Ant0Kr/Circuit-design/Cхемы/battery_controller.jpg

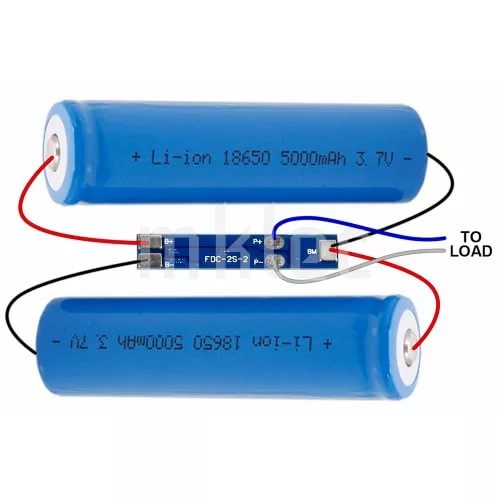
Cхемы/battery_controller.jpg
