Ant0Kr/Circuit-design/Инструкция/Логотип.png

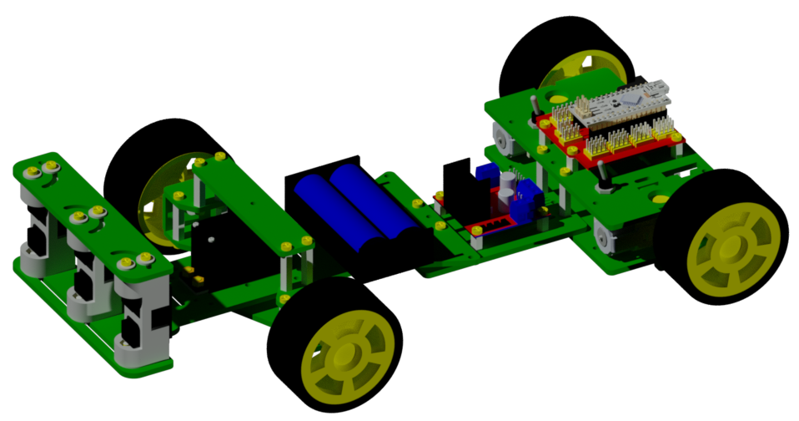
Инструкция/Логотип.png
