Ant0Kr/Circuit-design/Инструкция/Инструкция.docx

Робот для RoboRace

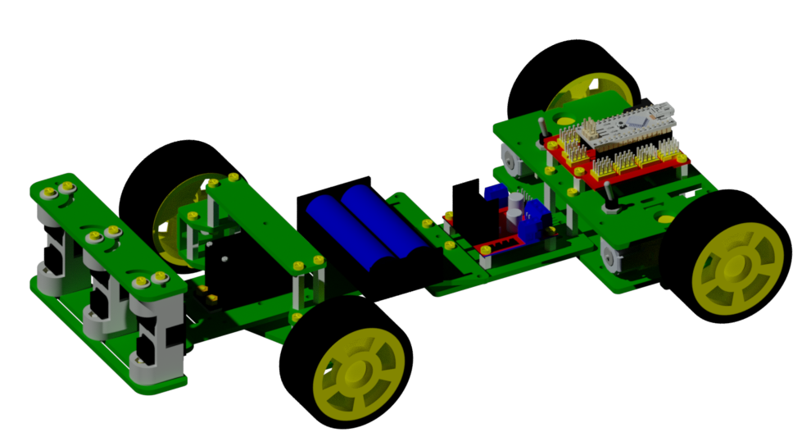
[picture p3: figure]

ИНСТРУКЦИЯ ПО СБОРКЕ

От авторов

Данная инструкция предлагает Вам собрать робота для участия в соревнованиях RoboRace по уже подготовленным чертежам и схемам. Однако авторы будут в восторге, если Вы используя их наработки спроектируете и соберете своего уникального робота.

Все чертежи, схемы и примеры прошивок можно найти в github репозитории: https://github.com/Ant0Kr/Circuit-design

(Все схемы и чертежи, приведенные в данной инструкции могут не соответствовать реальному виду использованных комплектующих робота. Все ссылки на комплектующие приведены в качестве примера.)

Удачи в творчестве.

С уважением, студенты БГУиР ФКСиС ВМСиС:

Карачун А. С.

Василевский И. А.

Содержание

Состав корпуса10

Инструкция по сборке12

Схема подключения электроники4

Описание API робота4

Необходимые комплектующие

Изображение | Описание | Количество

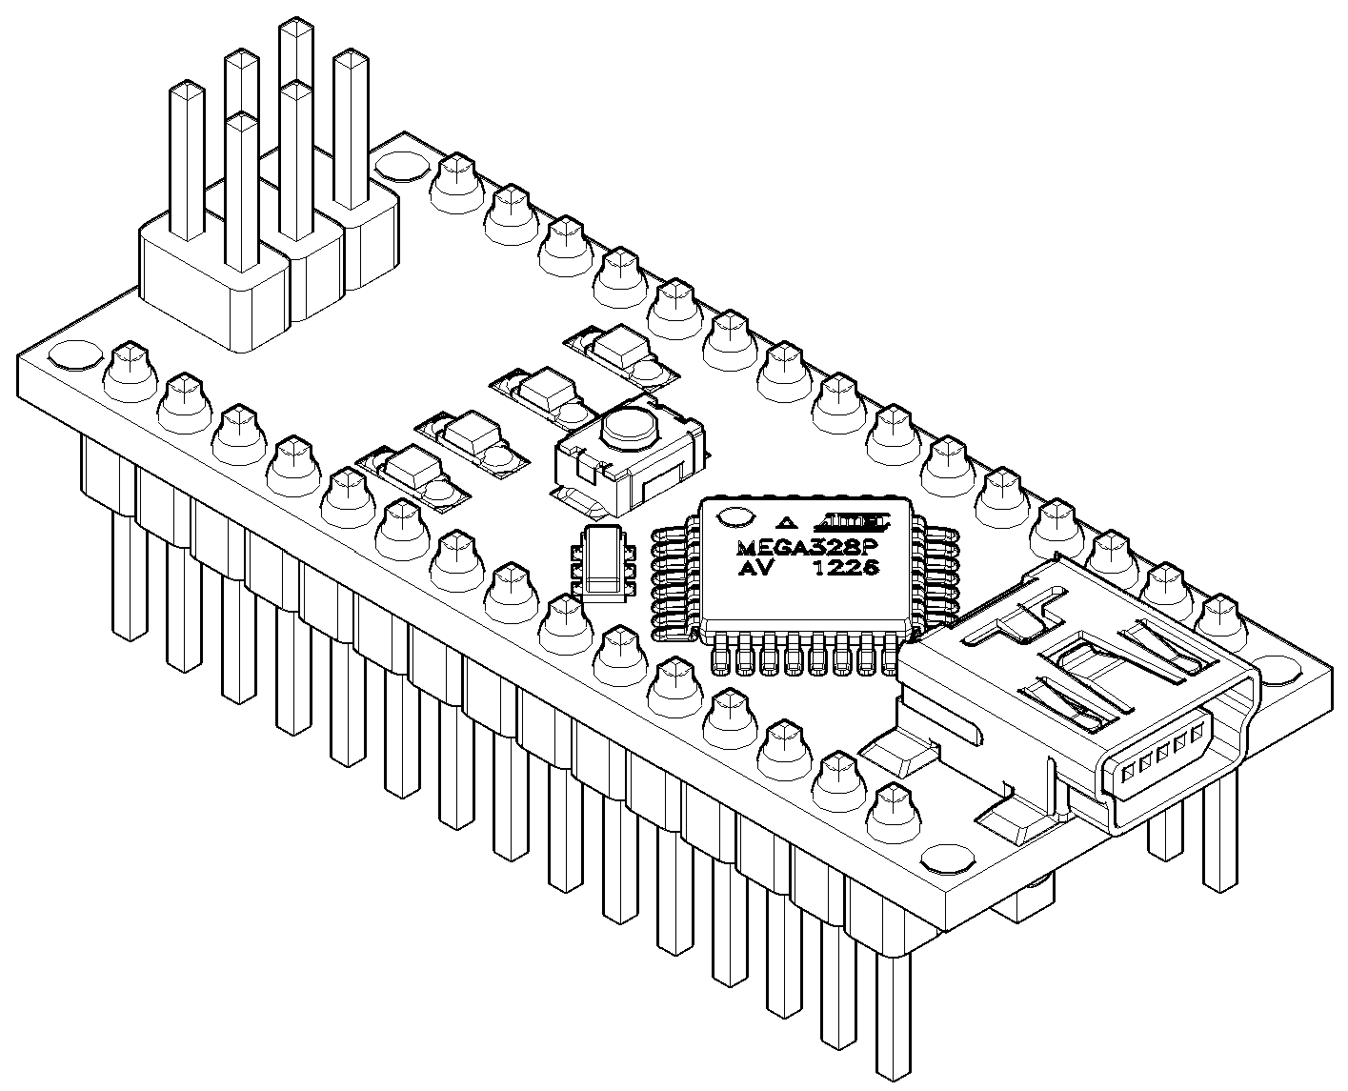
[picture p4: figure]

| Ардуино (Arduino Nano V3.0 (https://www.ebay.com/itm/ATmega328P-Mini-USB-Nano-V3-0-CH340G-5V-16M-Micro-controller-Board-For-Arduino-/172425955537)) | 1 шт.

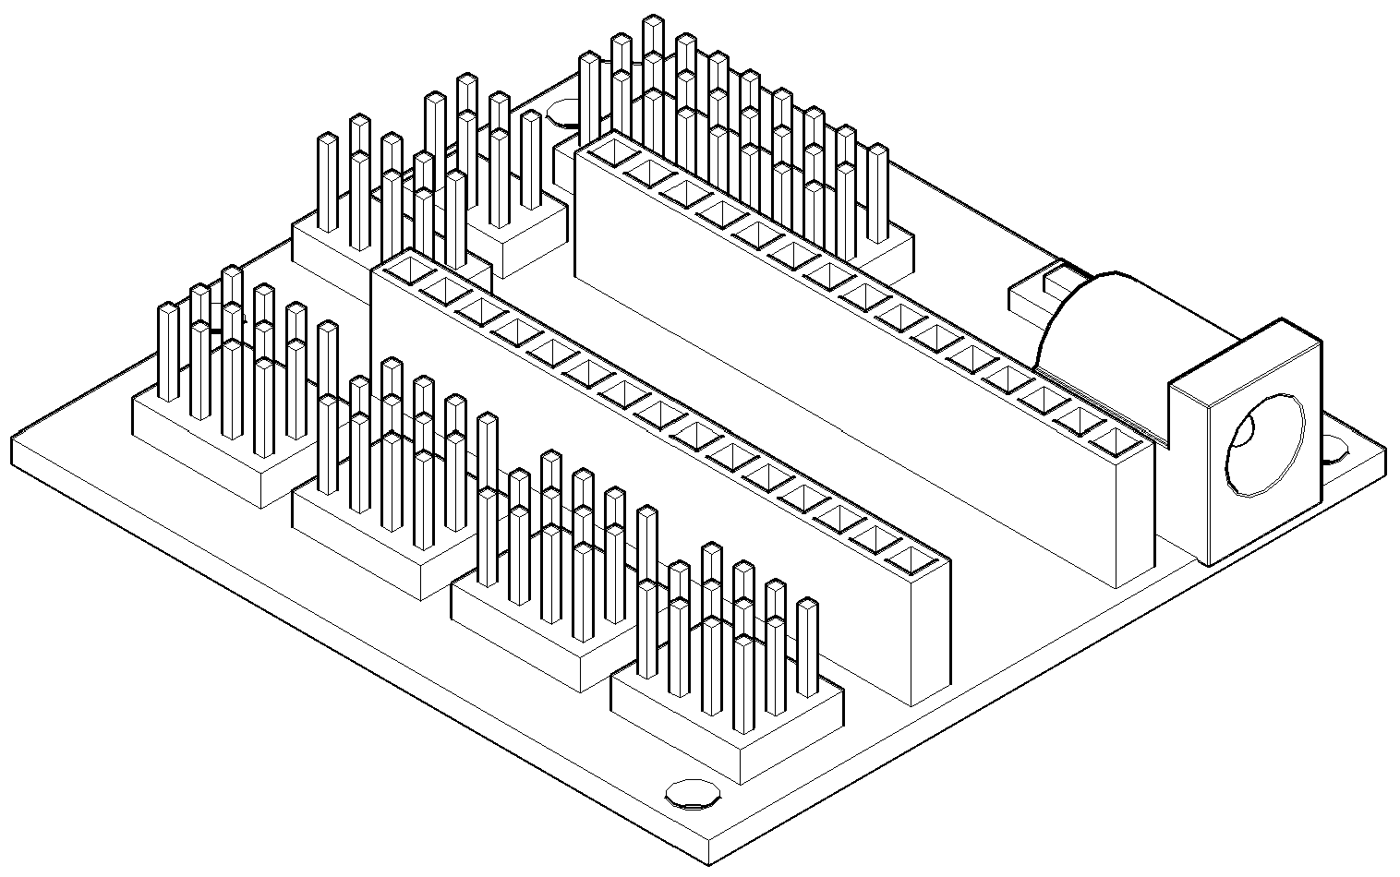
[picture p5: figure]

| Плата расширения (Nano V3.0 Prototype Shield I/O I2C Extension Board (https://www.ebay.com/itm/Nano-V3-0-Prototype-Shield-I-O-I2C-Extension-Board-Expansion-Module-F-Arduino-MO-/152340733476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)) | 1 шт.

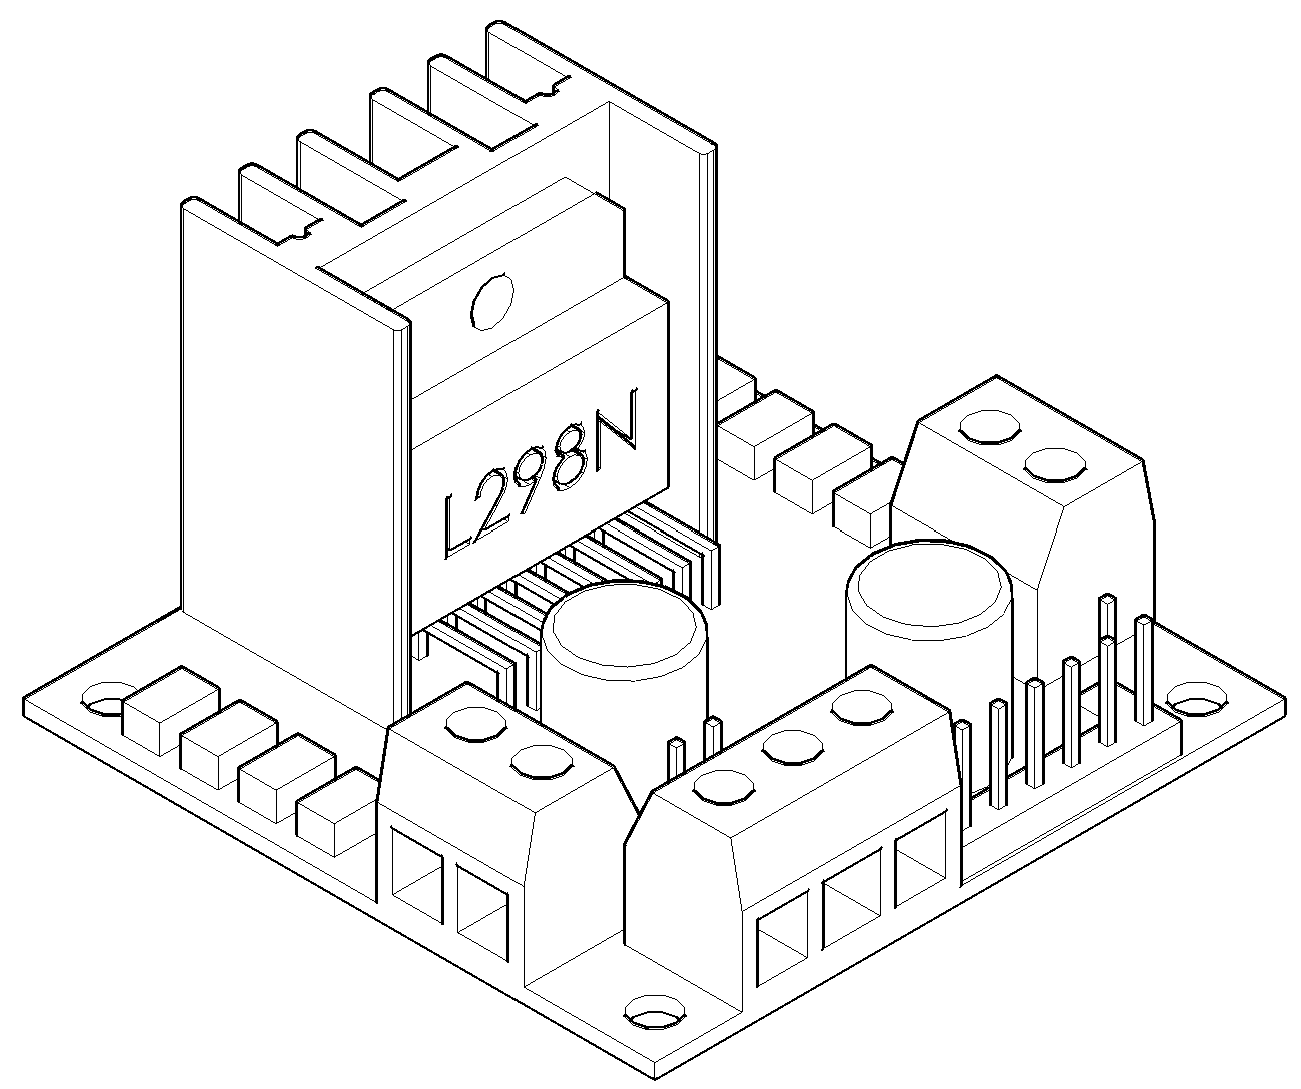
[picture p6: figure]

| Контроллер двигателей (L298N Driver Stepper Control (https://www.ebay.com/itm/DC-Module-Board-for-Arduino-HOT-Dual-H-Bridge-NEW-L298N-Driver-Stepper-Control-/112467282661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)) | 1 шт.

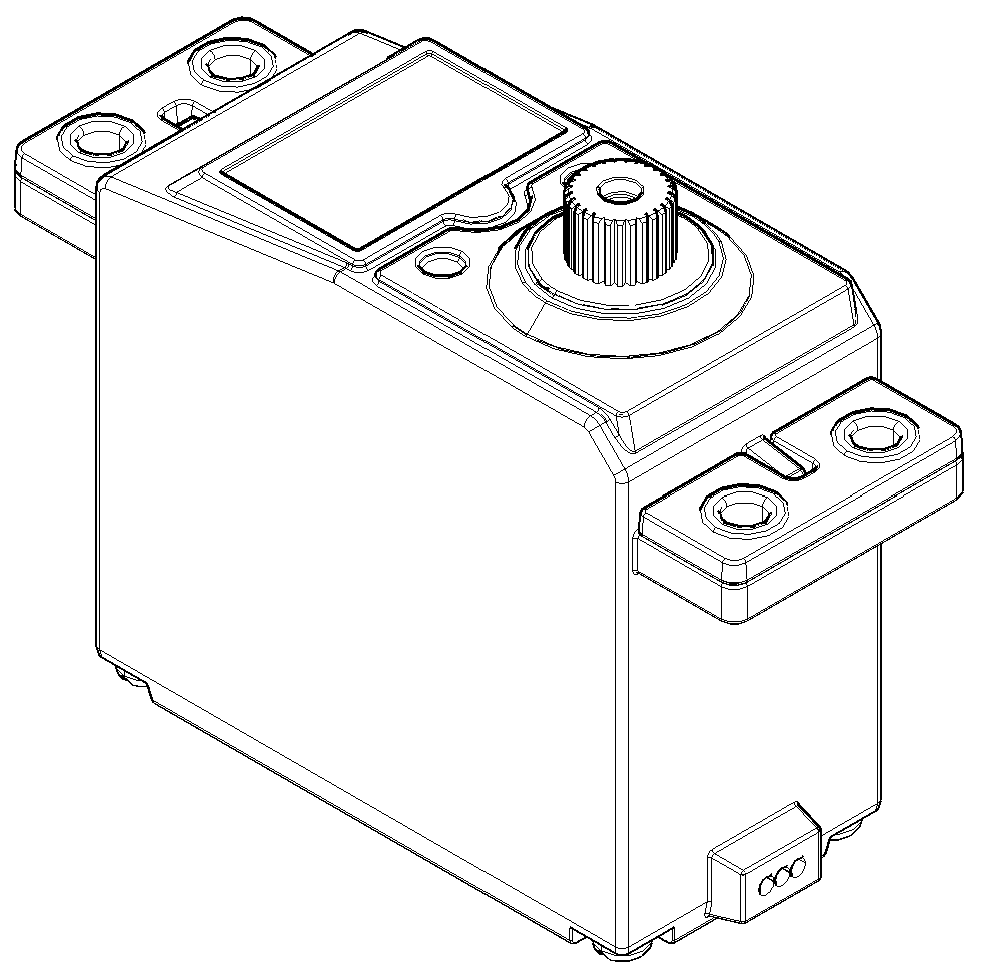
[picture p7: figure]

| Сервопривод (Futaba S3003 Servo Motor (http://www.ebay.com/itm/Big-Torque-Futaba-S3003-Servo-Motor-Gear-for-Robot-RC-Helicopter-Align-T-R-/201606199373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)) | 1 шт.

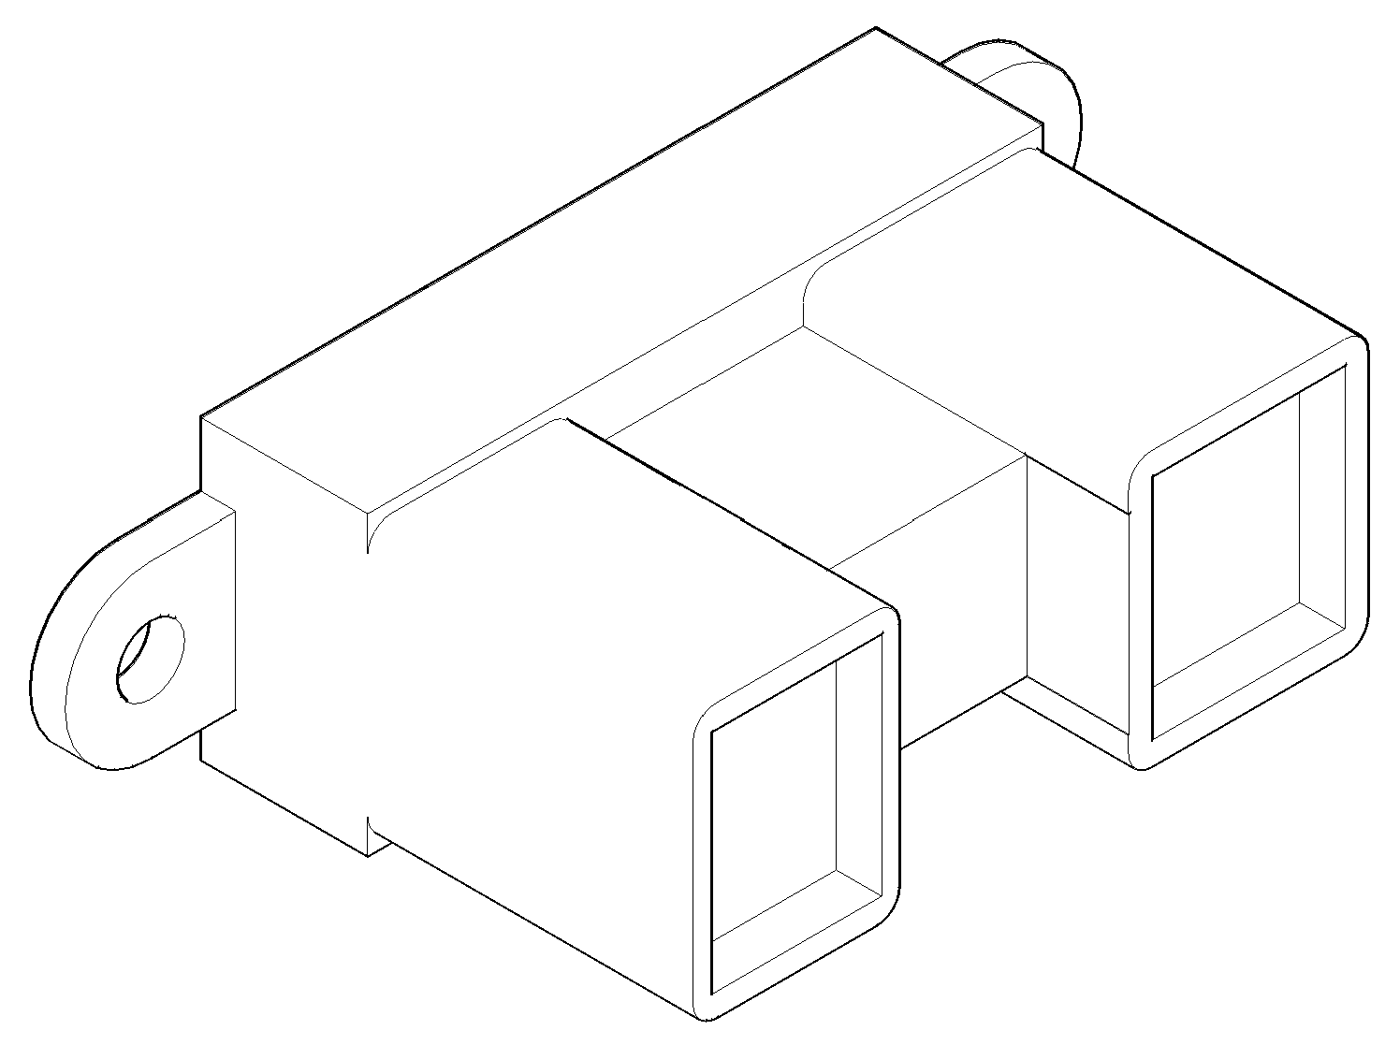
[picture p8: figure]

| Инфракрасный датчик расстояния (GP2Y0A21YK0F Sharp IR Analog Distance Sensor (http://www.ebay.com/itm/GP2Y0A21YK0F-Sharp-IR-Analog-Distance-Sensor-Distance-10CM-80CM-Cable-Arduino-D-/112073155701)) | 3 шт.

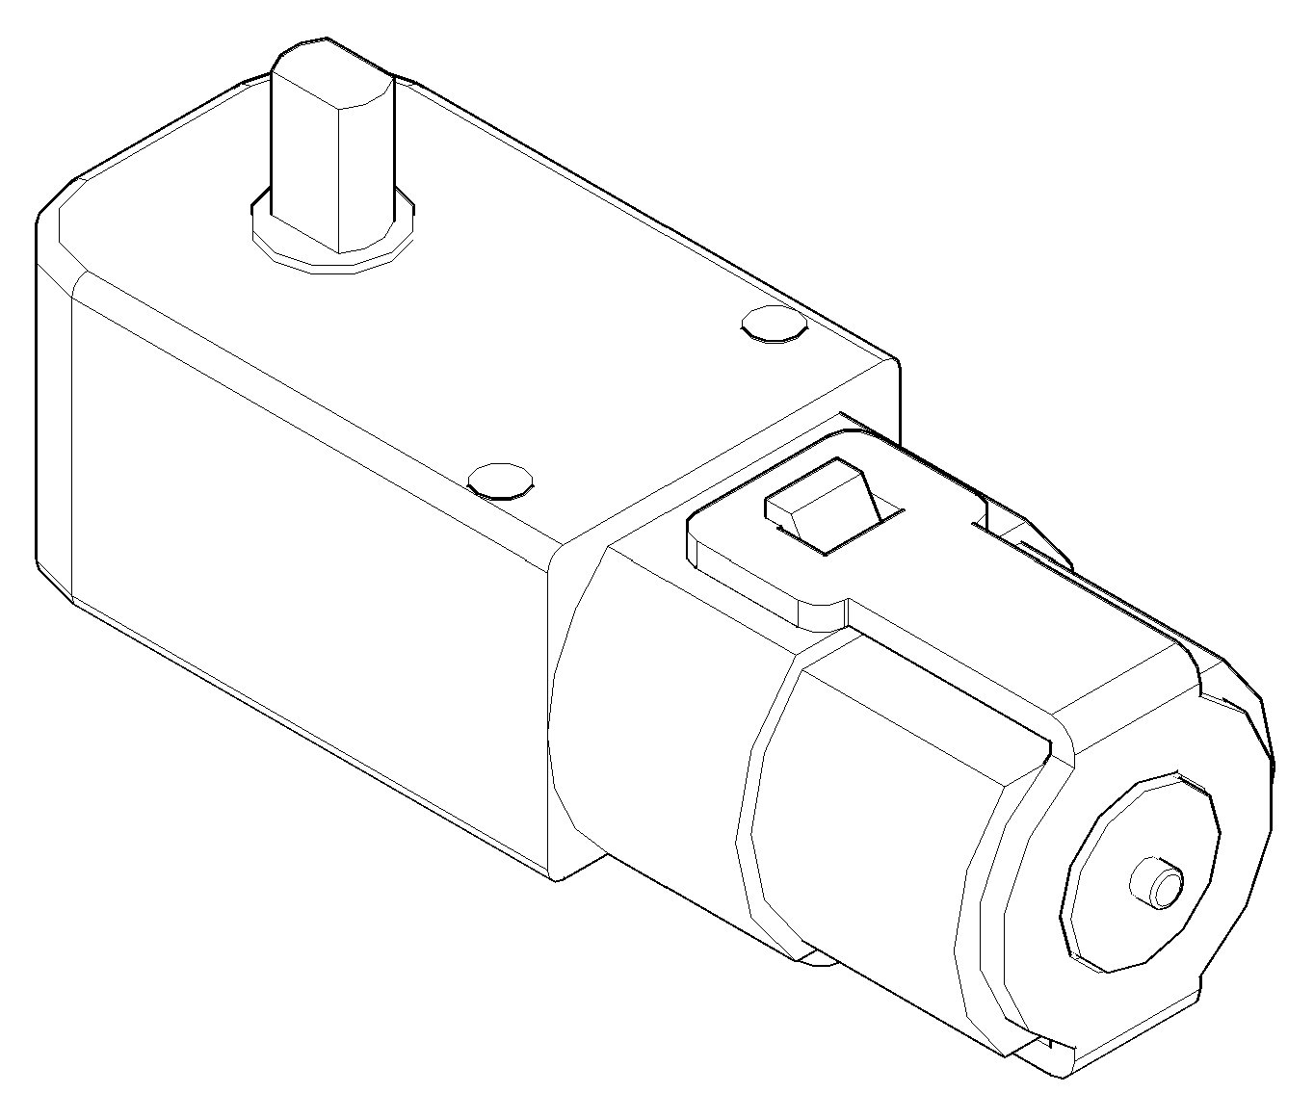
[picture p9: figure]

| Двигатель с редуктором (DC 3-6v Gear Motor (https://www.ebay.com/itm/DC3V-6V-DC-Geared-Motor-TT-For-Robot-Smart-Car-Chassis-DIY-Anti-interferenc-BBUS/311885629517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)) | 2 шт.

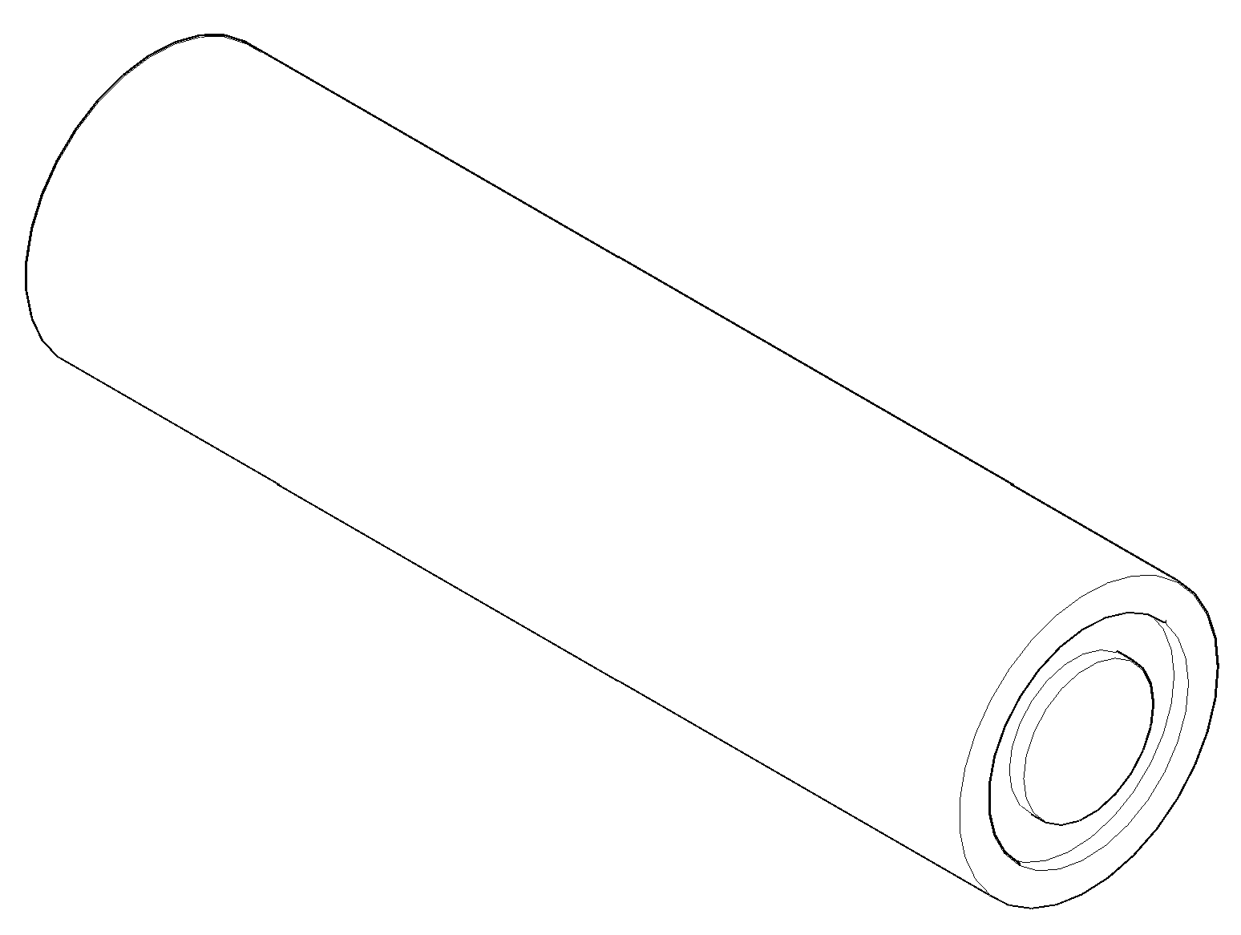
[picture p10: figure]

| Аккумулятор 18650 (Аккумулятор 18650 3.7V 1400mAh (http://belchip.by/product/?selected_product=19109)) | 2 шт.

Необходимые комплектующие

6

Изображение | Описание | Количество

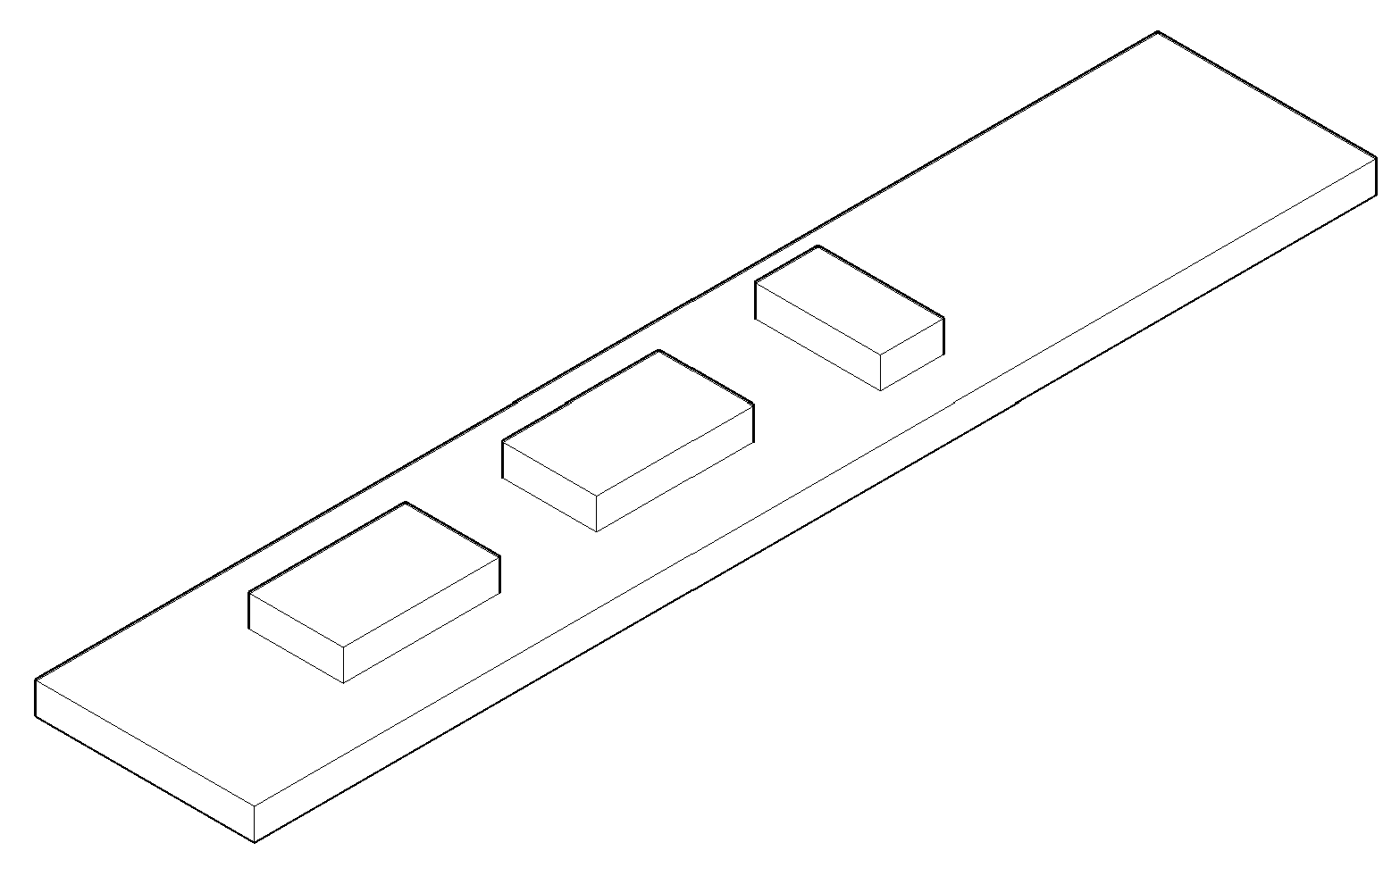
[picture p11: figure]

| Контроллер заряда/разряда аккумулятора (2S Li-ion Battery 18650 Charger Protection Board (https://www.ebay.com/itm/2S-Li-ion-Lithium-Battery-18650-Charger-Protection-Board-Pad-Module-3A-7-4V-8-4V-/131996865110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)) | 1 шт.

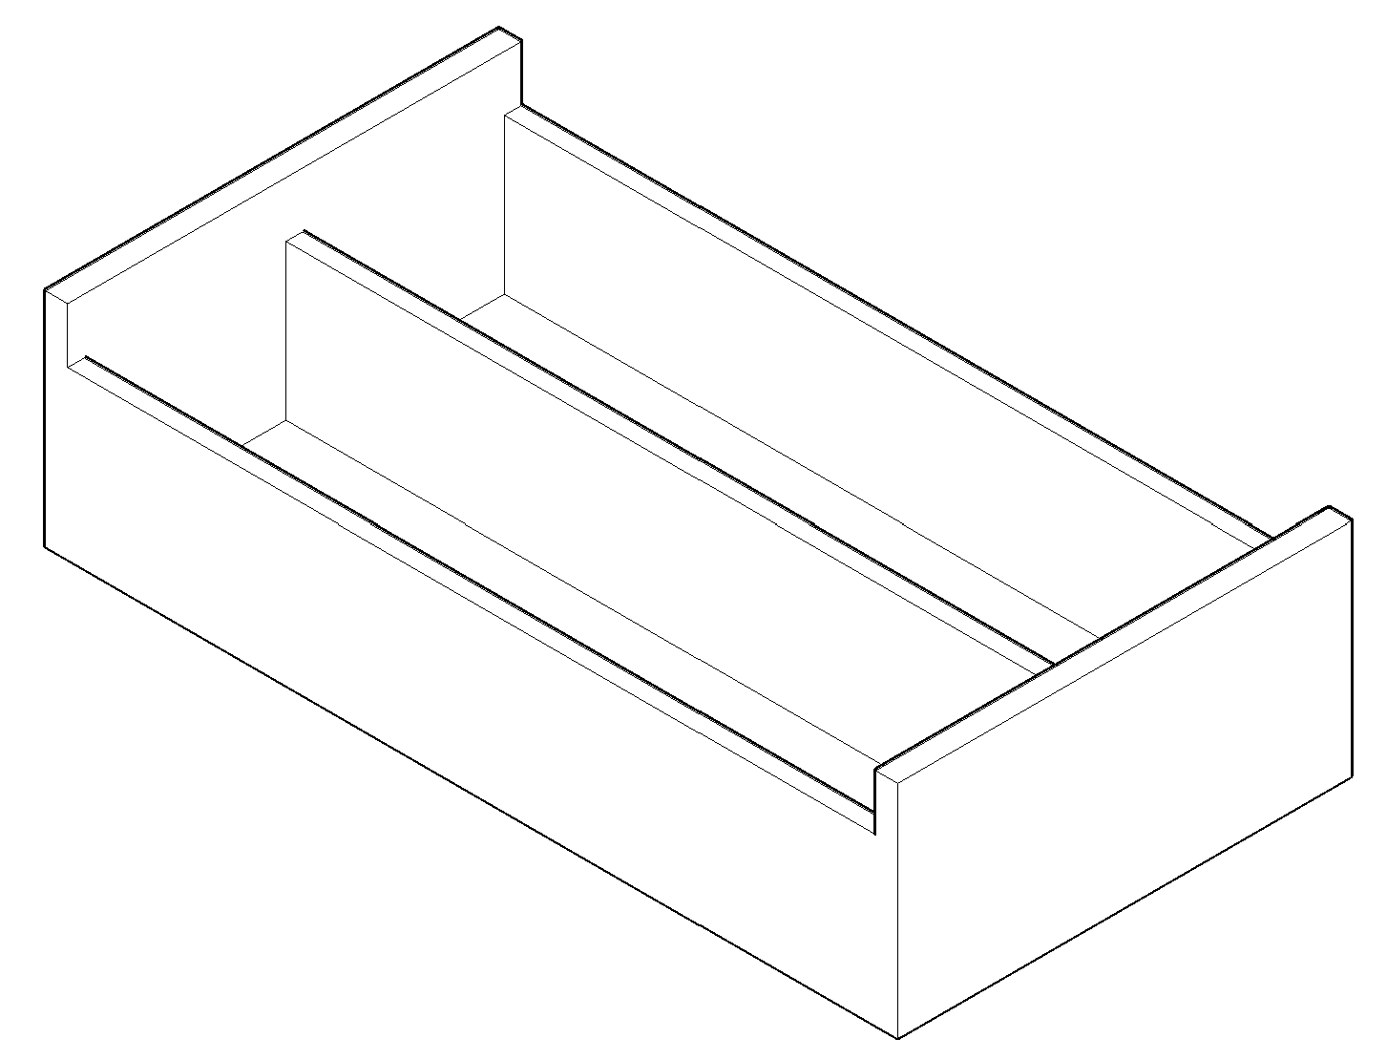
[picture p12: figure]

| Батарейный отсек (Батарейный отсек 18650 x2 (http://belchip.by/product/?selected_product=17455)) | 1 шт.

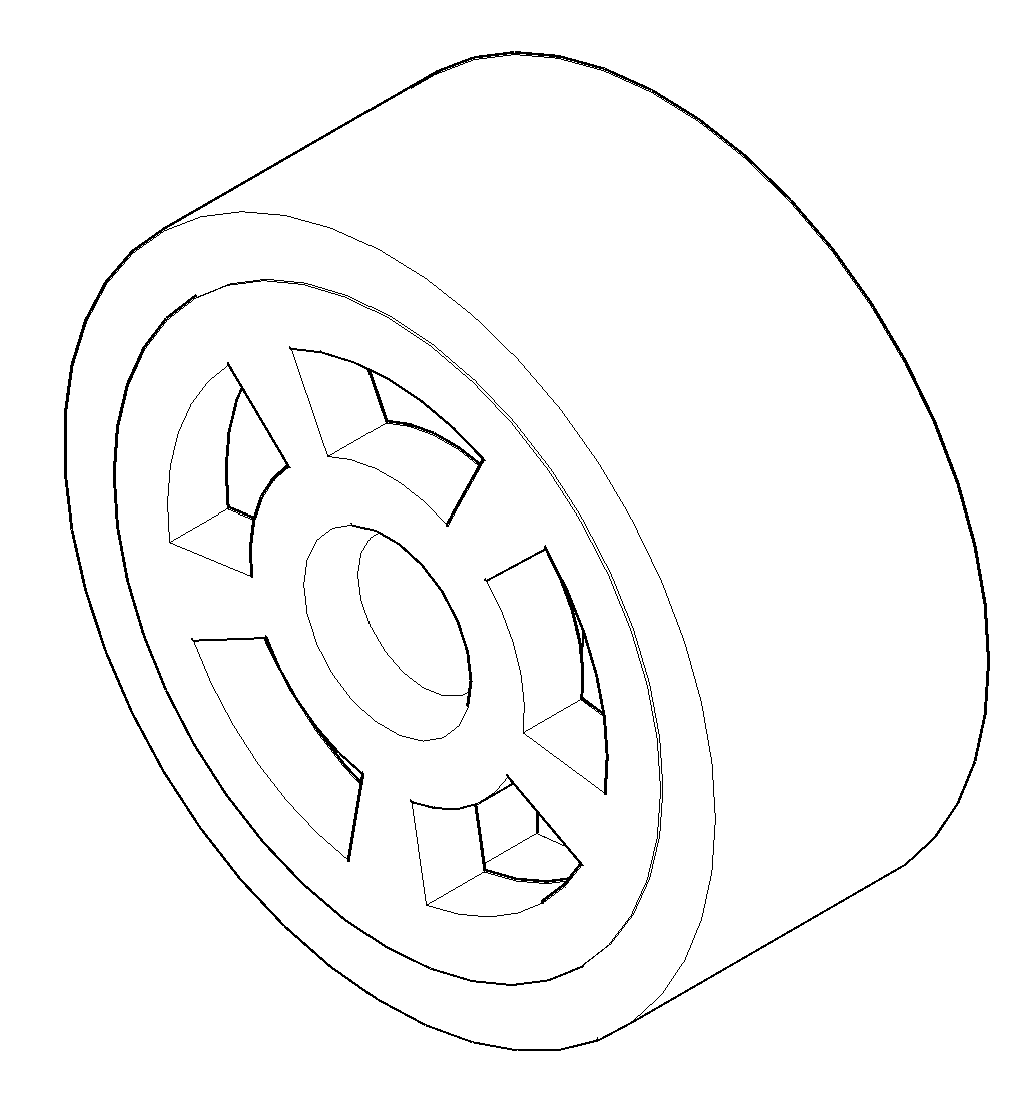
[picture p13: figure]

| Колесо (Plastic Tire Wheel (http://www.ebay.com/itm/2Pcs-Model-Robot-Plastic-Tire-Wheel-65Mm-X-26Mm-Small-Smart-Car-Ic-New-W-/232323293234)) | 4 шт.

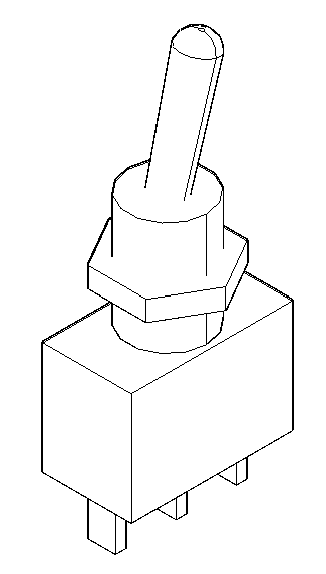
[picture p14: figure]

| Тумблер (Микротумблер MTS-101-A2 (http://belchip.by/product/?selected_product=11402)) | 2 шт.

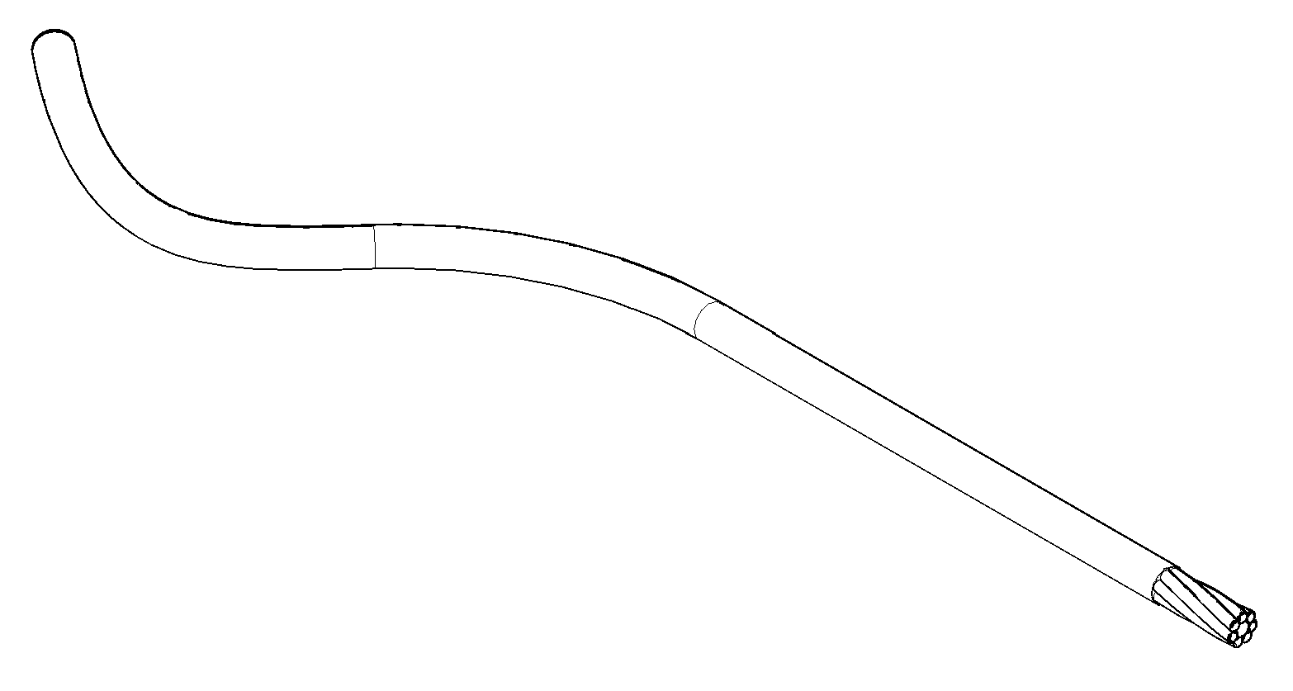
[picture p15: figure]

| Шлейф (Шлейф RC-10 (http://belchip.by/product/?selected_product=30982)) | 1 м.
| Провод (Кабель акустический LXK610 2x0.50 (http://belchip.by/product/?selected_product=06628)) | 1 м.

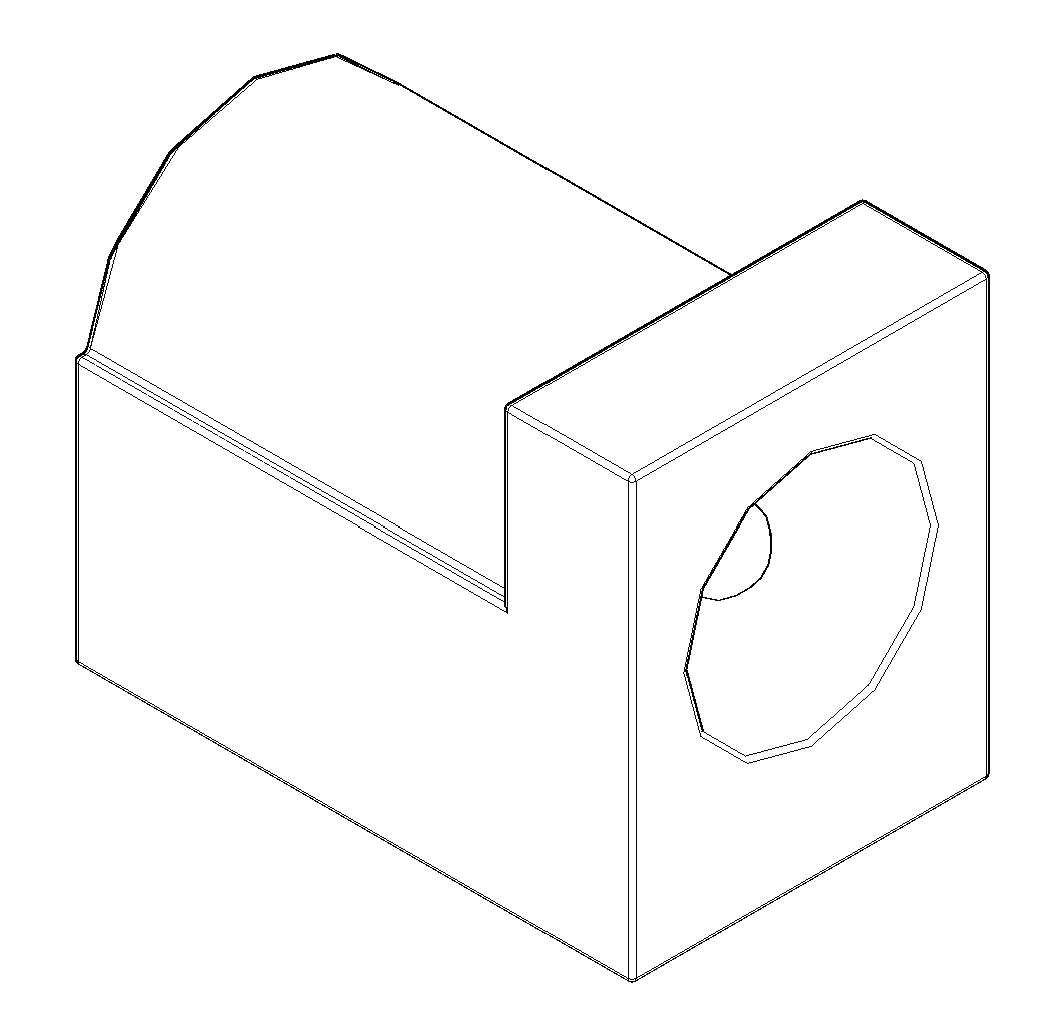
[picture p16: figure]

| Гнездо питания (Разъём питания штырьковый DC-012 (http://belchip.by/product/?selected_product=03900)) | 1 шт.

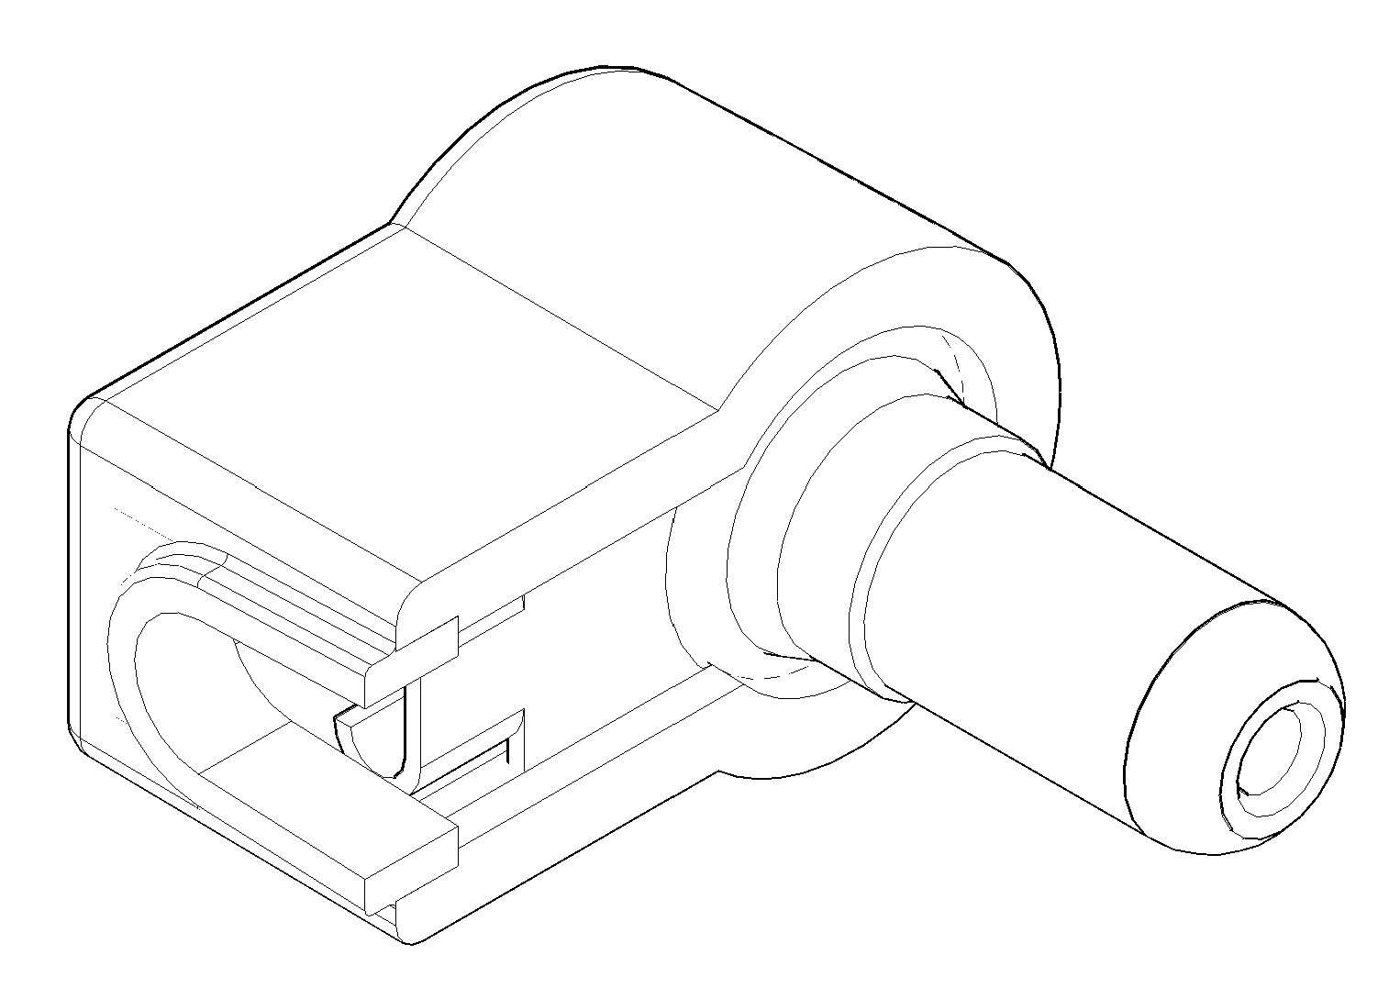
[picture p17: figure]

| Штекер питания (Разъём питания штырьковый PC-2.1/5.5K-14 (http://belchip.by/product/?selected_product=07373)) | 1 шт.
| Стойка дистанцирующая М3 10мм (Стойка дистанцирующая HTP-310, гайка-гайка М3 (http://belchip.by/product/?selected_product=31251)) | 4 шт.
| Стойка дистанцирующая М3 20мм (Стойка дистанцирующая HP-20, гайка-гайка М3 (http://belchip.by/product/?selected_product=12449)) | 12 шт.

7

Изображение | Описание | Количество

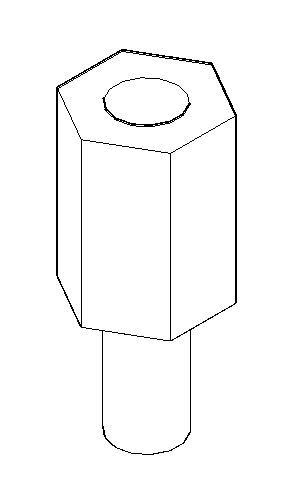
[picture p18: figure]

| Стойка дистанцирующая М3 8мм (Стойка дистанцирующая TP-8, винт-гайка М3 (http://belchip.by/product/?selected_product=12065)) | 8 шт.

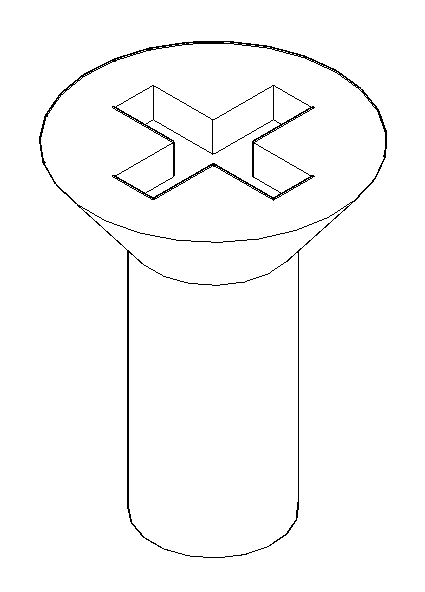
[picture p19: figure]

| Винт с потайной шляпкой М3х10 | 2 шт.
| Винт с полукруглой шляпкой М3х6 (Крепеж М3х6 (http://belchip.by/product/?selected_product=30162)) | 36 шт.
| Винт с полукруглой шляпкой М3х10 (Крепеж М3х10 (http://belchip.by/product/?selected_product=30161)) | 10 шт.
| Винт с полукруглой шляпкой М3х16 | 9 шт.
| Винт с полукруглой шляпкой М3х30 | 4 шт.

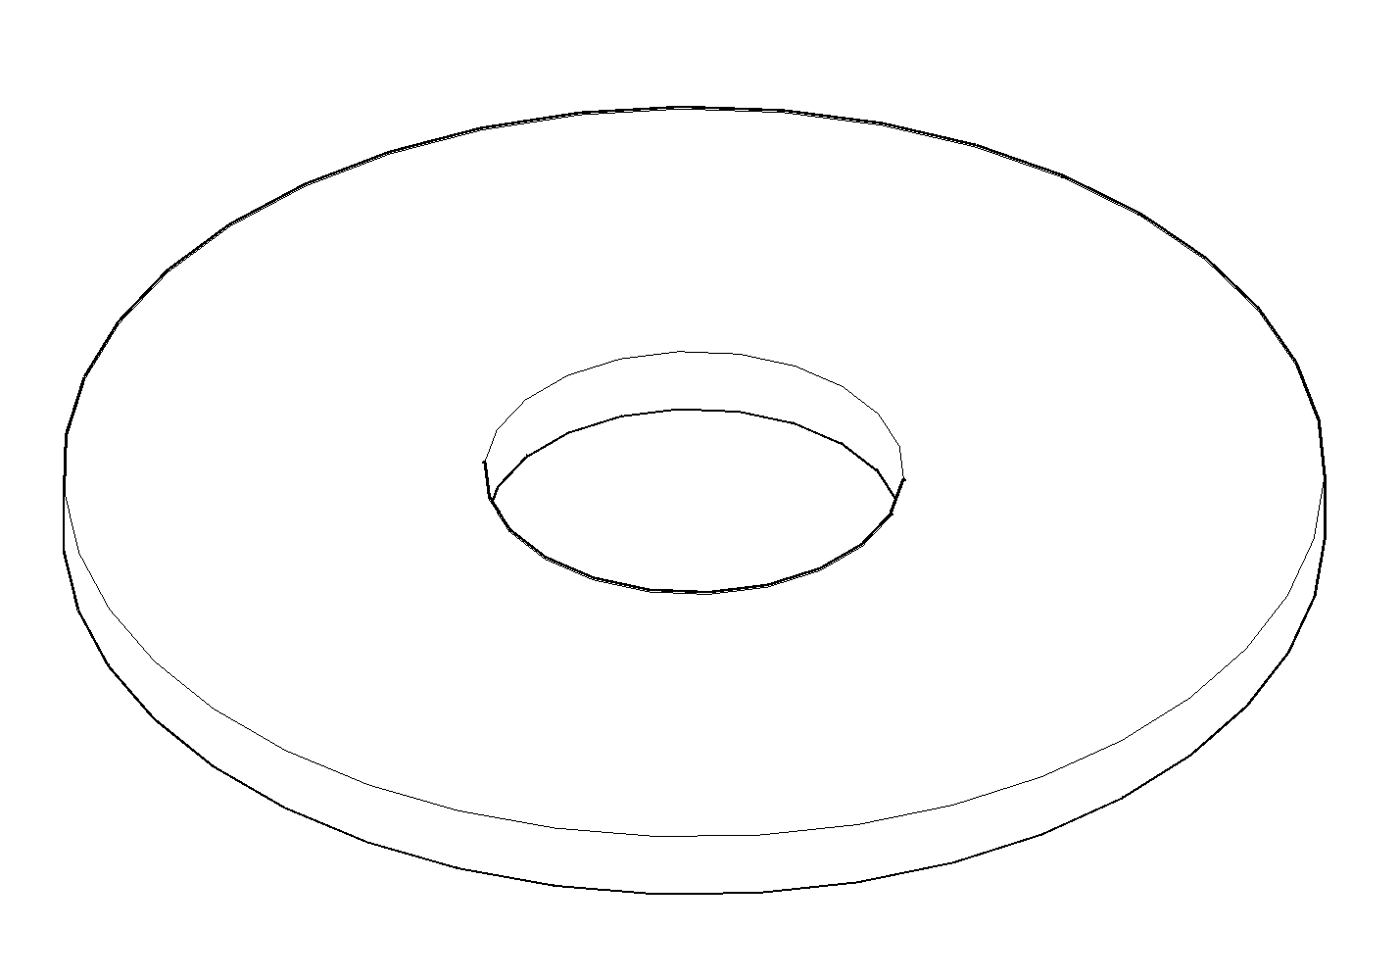
[picture p20: figure]

| Шайба М3 (Крепеж М3 шайба (http://belchip.by/product/?selected_product=18040)) | 18 шт.

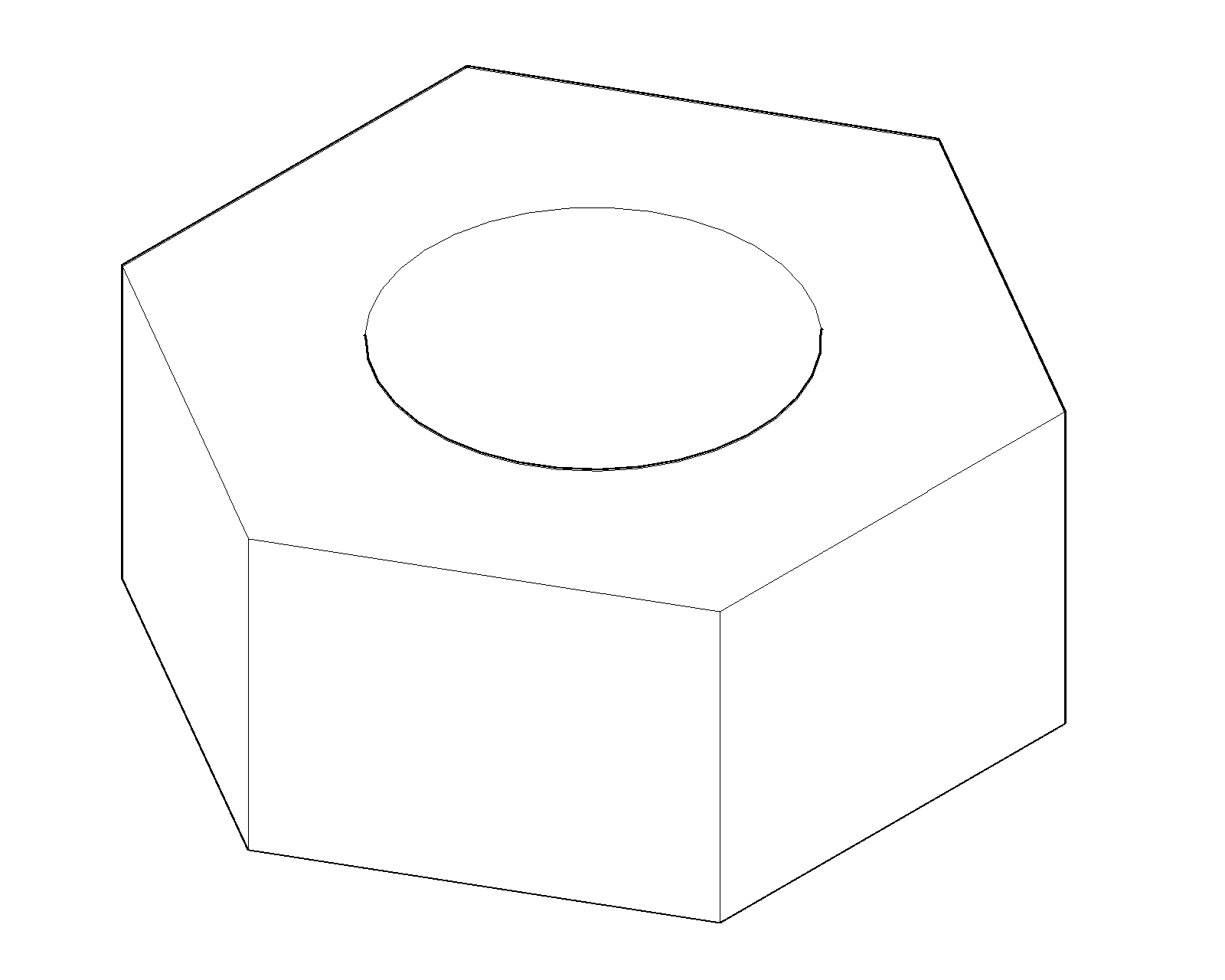
[picture p21: figure]

| Гайка М3 (Крепеж М3 гайка (http://belchip.by/product/?selected_product=16461)) | 20 шт.

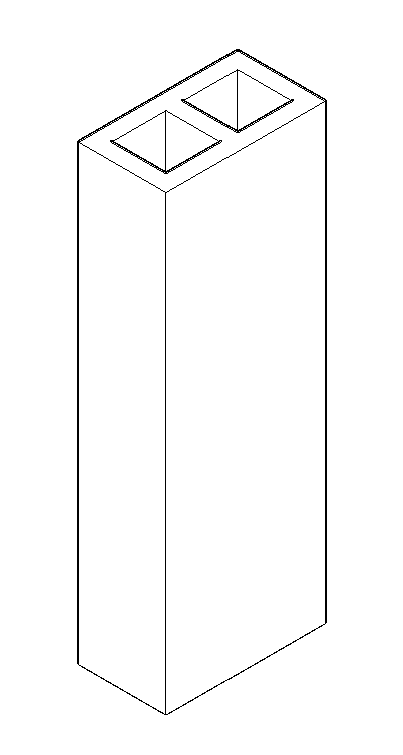
[picture p22: figure]

| Гнездо штыревое 2pin шаг 2.54 (Разъём штыревой NSR-02 (http://belchip.by/product/?selected_product=30941)) | 4 шт.

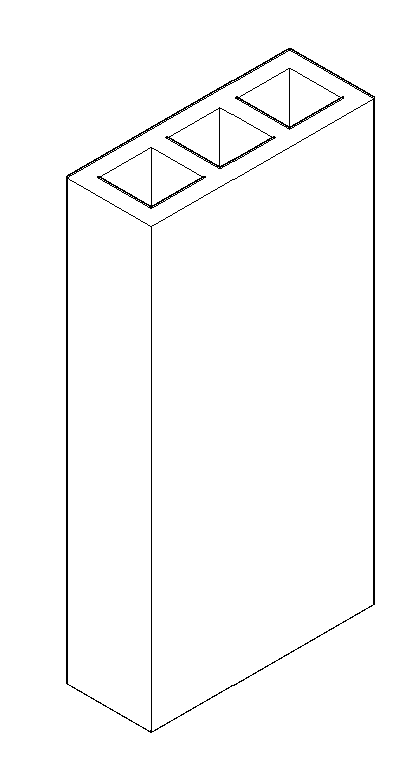
[picture p23: figure]

| Гнездо штыревое 3pin шаг 2.54 (Разъём штыревой NSR-03 (http://belchip.by/product/?selected_product=11234)) | 3 шт.

8

Название | Комментарий
Паяльное оборудование | В процессе сборки робота будет необходимо припаять несколько проводов. В состав входит: паяльник, припой, паяльная кислота либо канифоль.
Модельный нож | В процессе сборки робота может возникнуть необходимость убрать заусенцы со стоек датчиков или зачистить провода.
Набор надфилей | В процессе сборки робота, возможно, будет необходимо подогнать некоторые детали.
Крестовая отвертка | Необходима для сборки корпуса, прикручивания модулей к корпусу.
Зажигалка | Необходима для обжима термоусадочной трубки при изоляции соединения проводов.
Термопистолет | Необходим для закрепления разъема питания. Можно вместо него использовать клей момент.
Инструмент для снятия изоляции | Применятся для снятия изоляции с проводов. Вместо него можно использовать модельный нож.
Плоскогубцы | Понадобятся при сборке корпуса.

Необходимые инструменты

9

Изображение | Описание | Количество

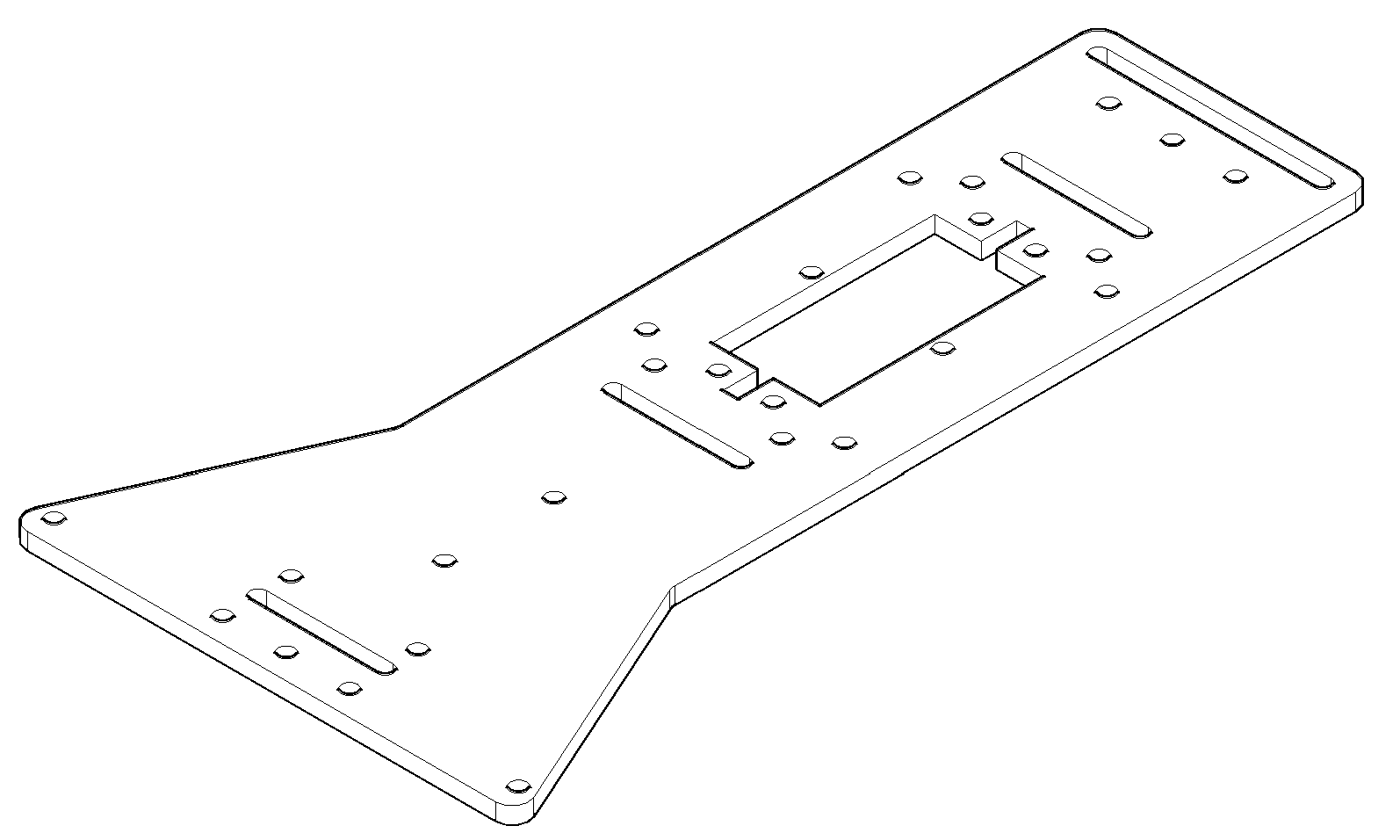
[picture p24: figure]

| Центральная часть (Деталь A) | 1 шт.

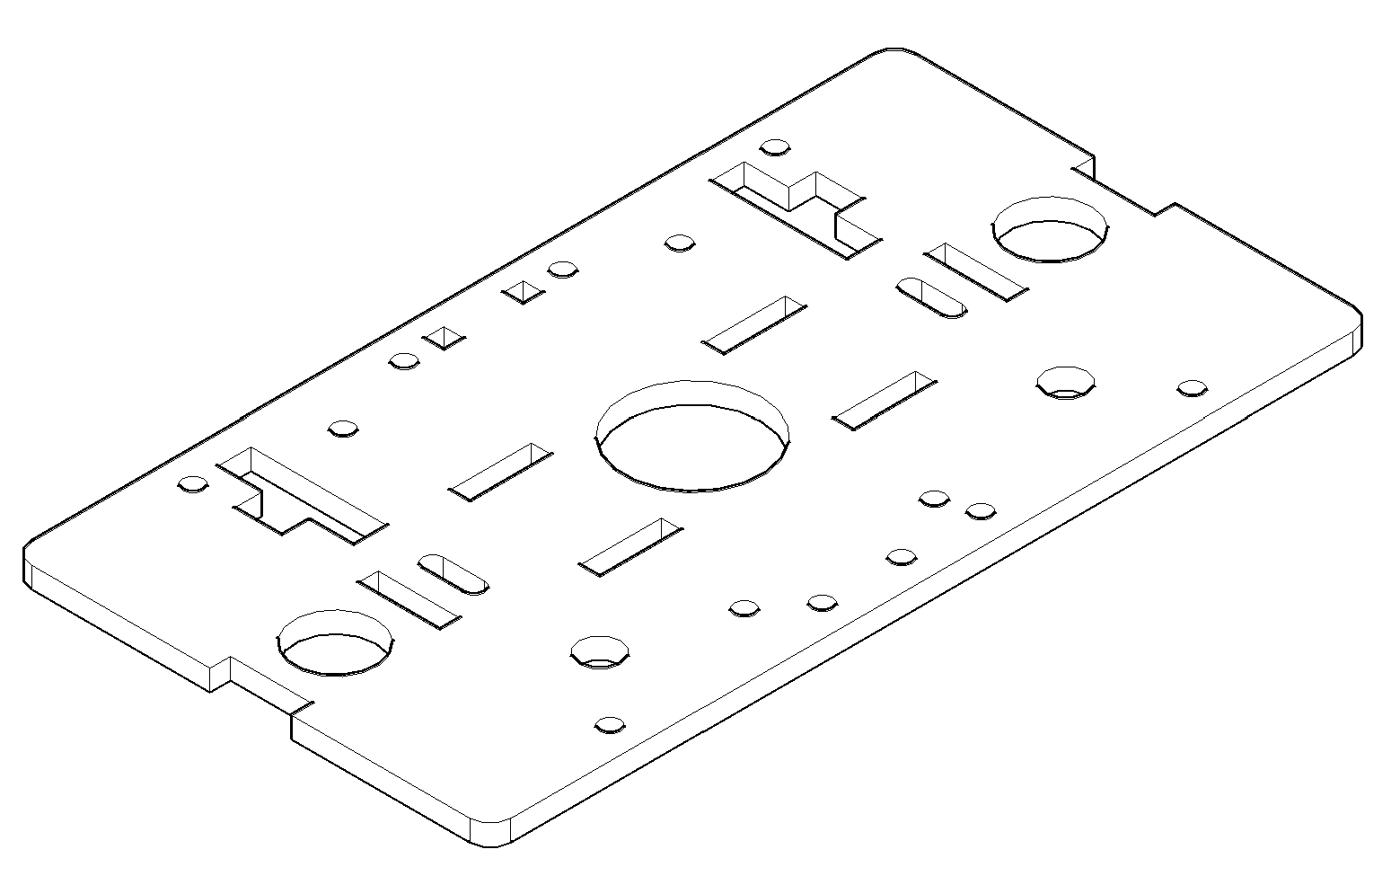
[picture p25: figure]

| Панель крепления двигателей (верх) (Деталь B) | 1 шт.

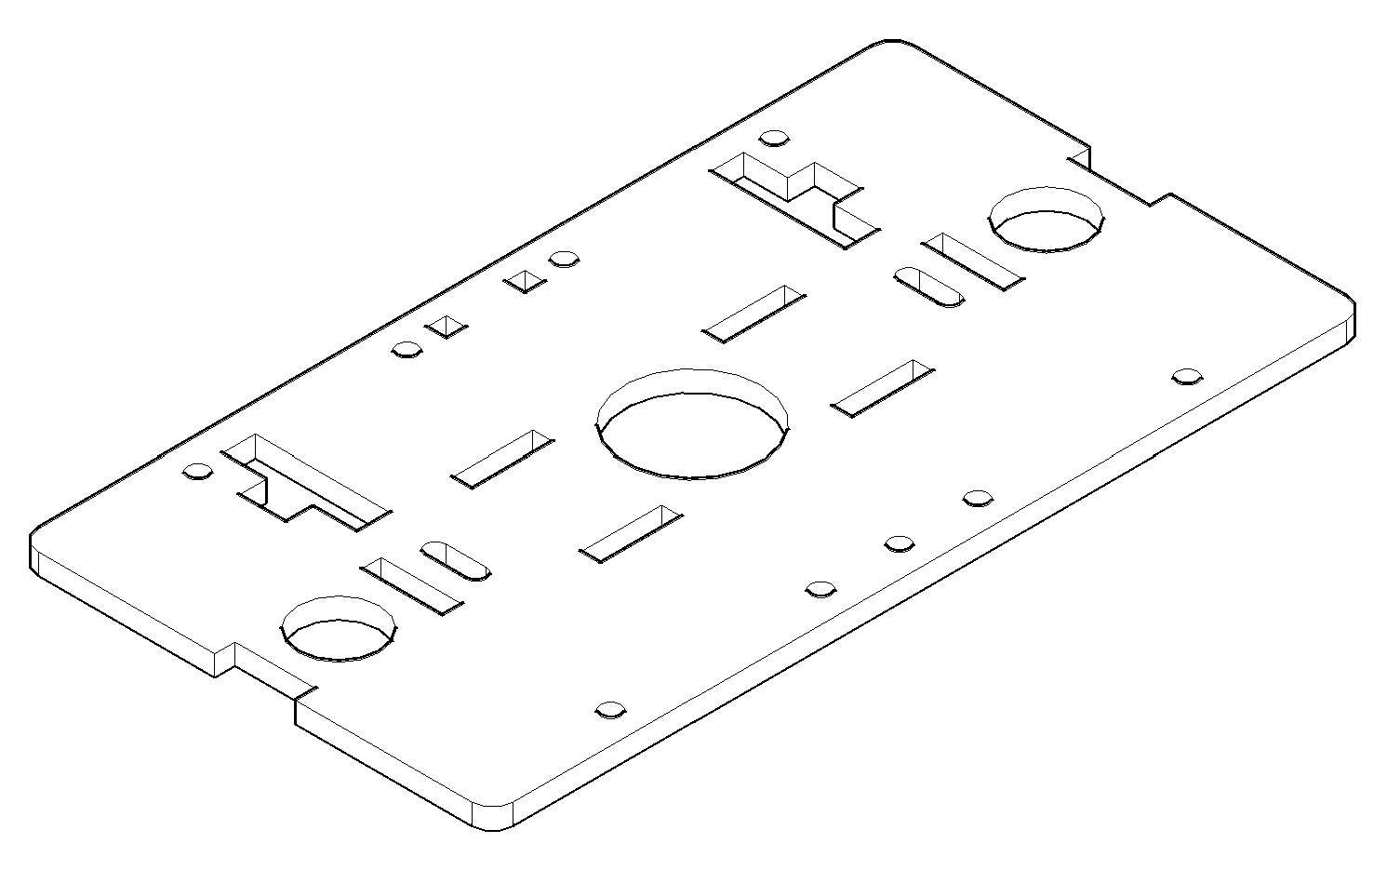
[picture p26: figure]

| Панель крепления двигателей (низ) (Деталь C) | 1 шт.

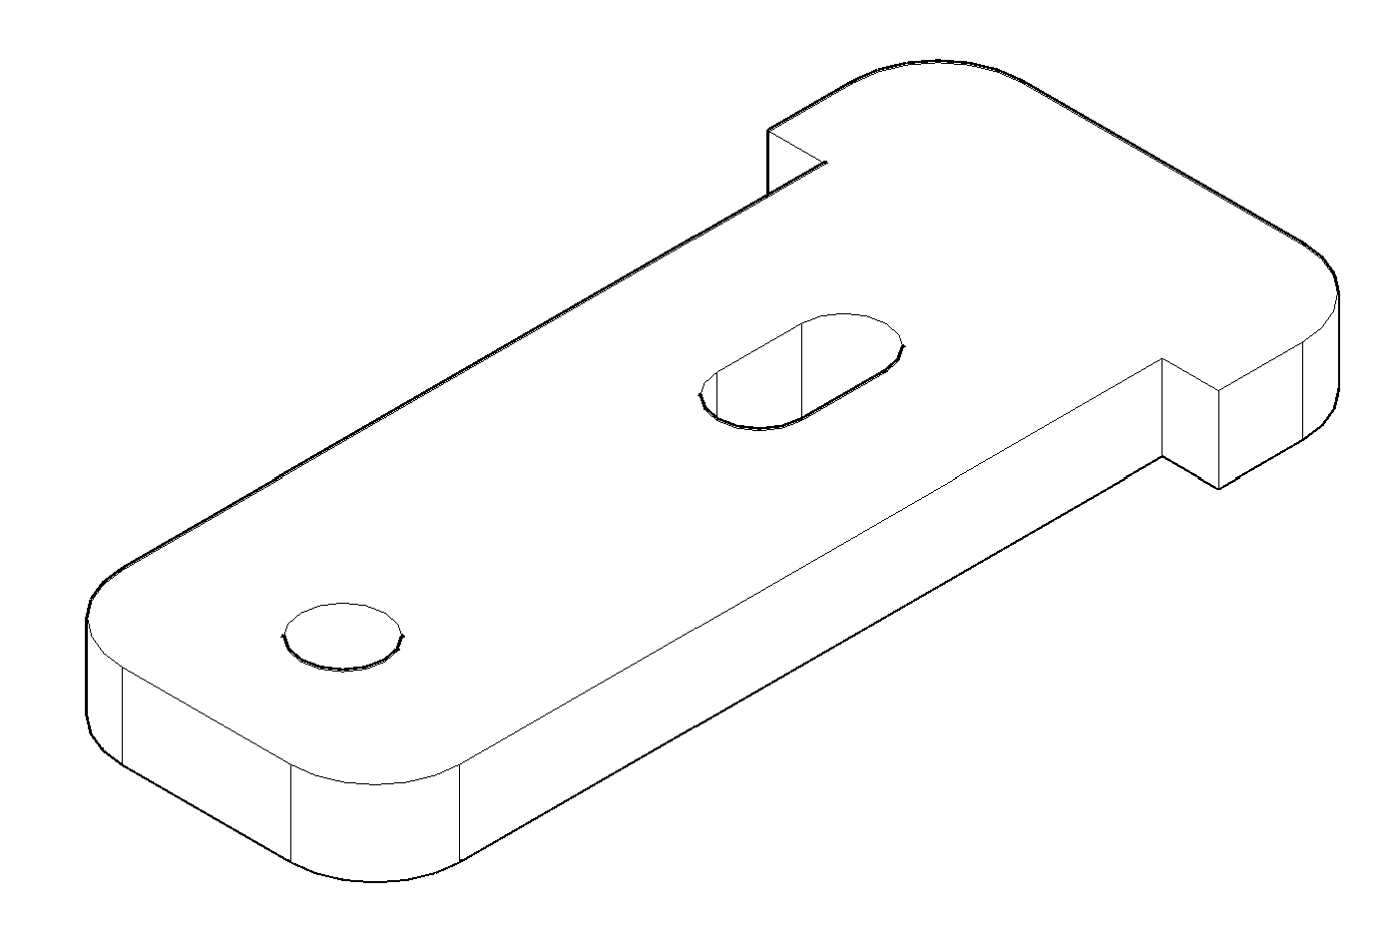
[picture p27: figure]

| Стойка крепления двигателей (Деталь D) | 4 шт.

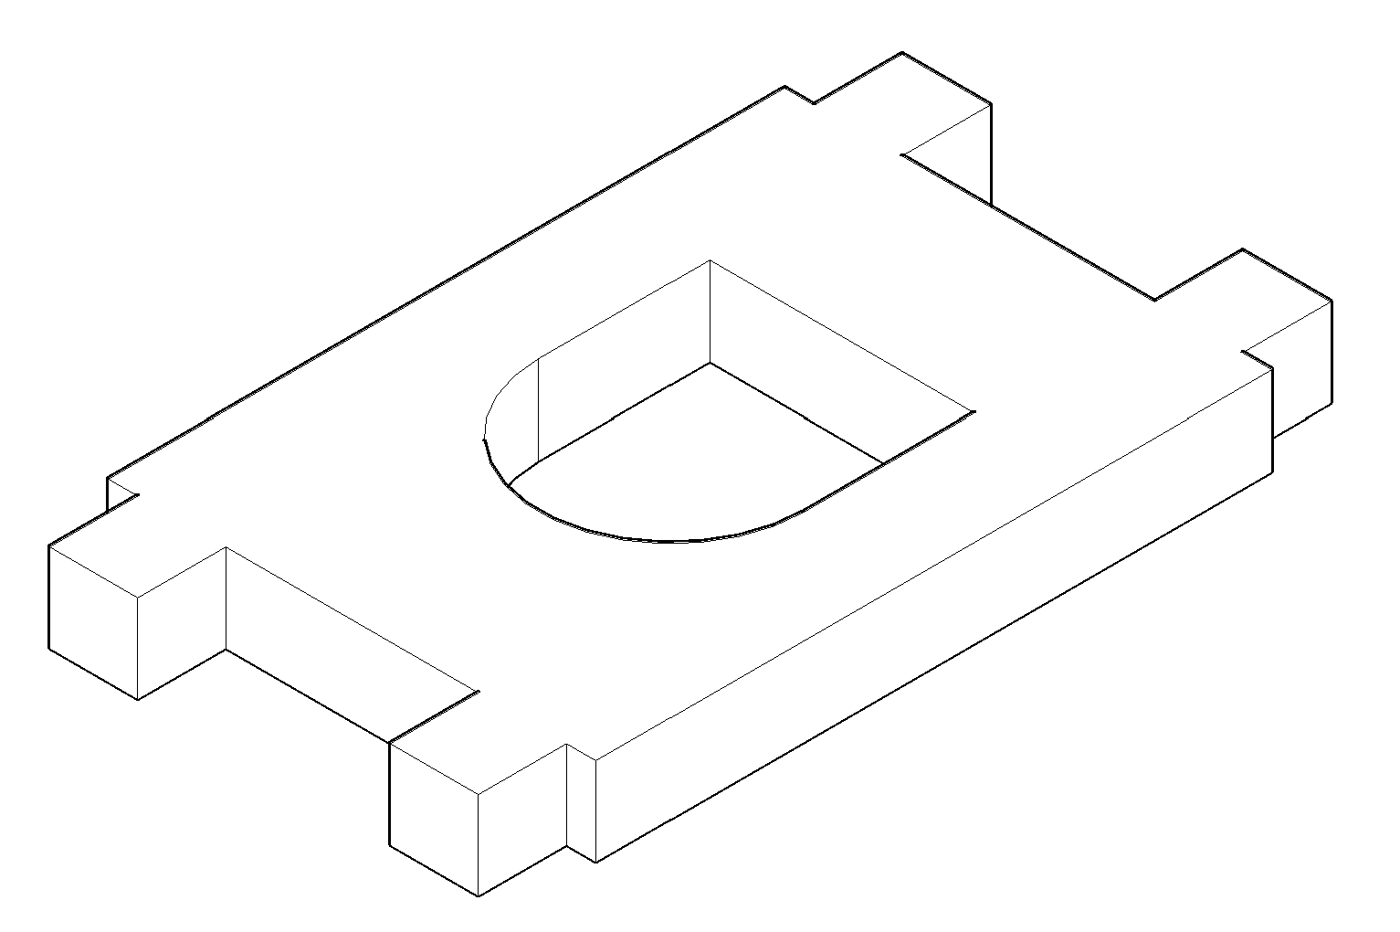
[picture p28: figure]

| Стойка крепления гнезда питания (Деталь E) | 1 шт.

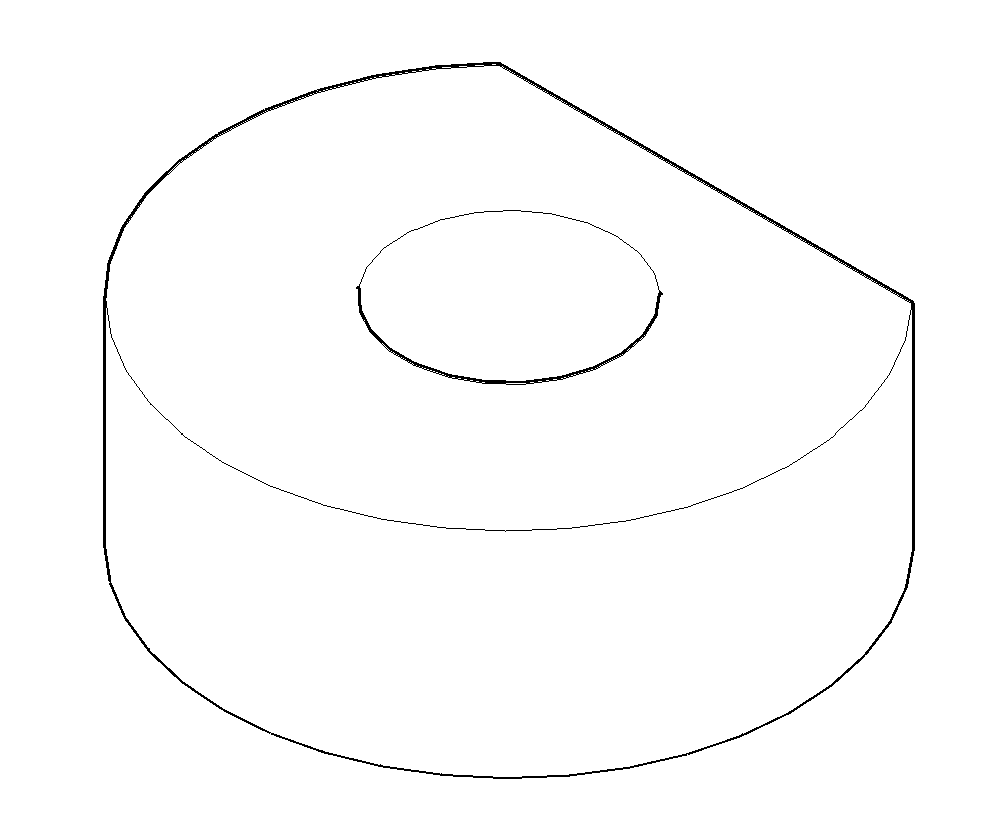
[picture p29: figure]

| Шайба (Деталь F) | 2 шт.

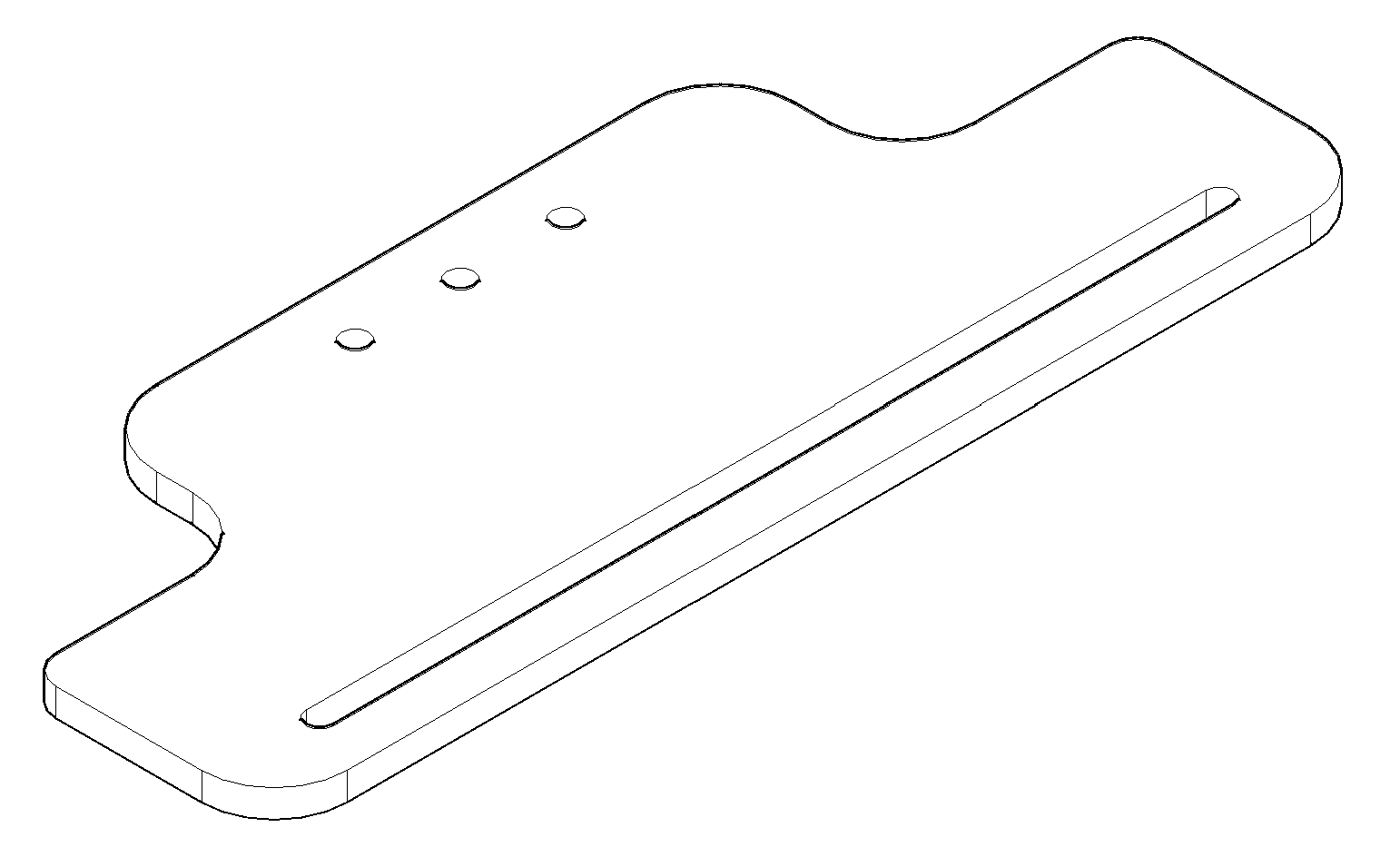
[picture p30: figure]

| Панель крепления ИК датчиков (низ) (Деталь G) | 1 шт.

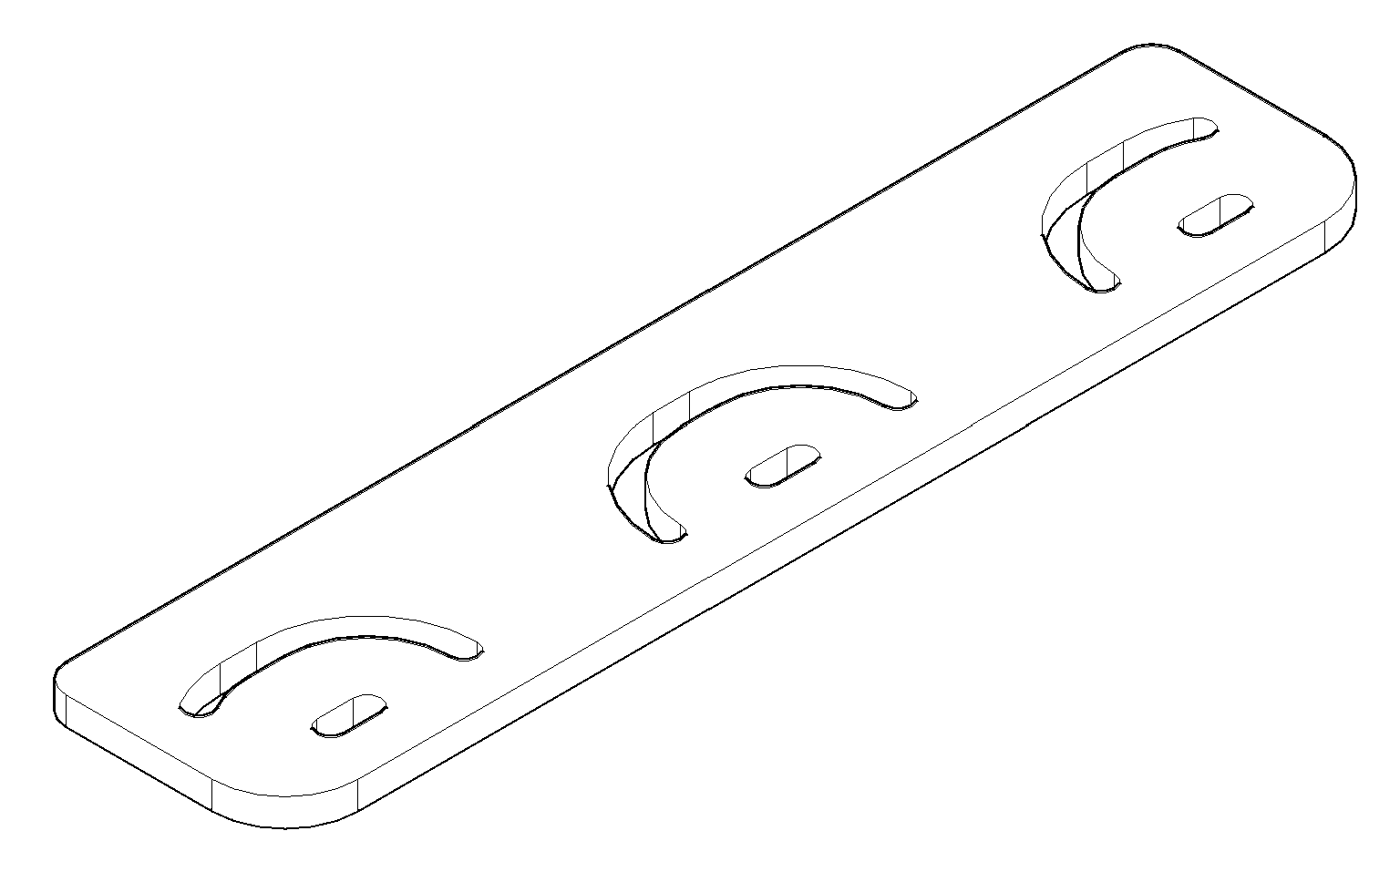
[picture p31: figure]

| Панель крепления ИК датчиков (верх) (Деталь H) | 1 шт.

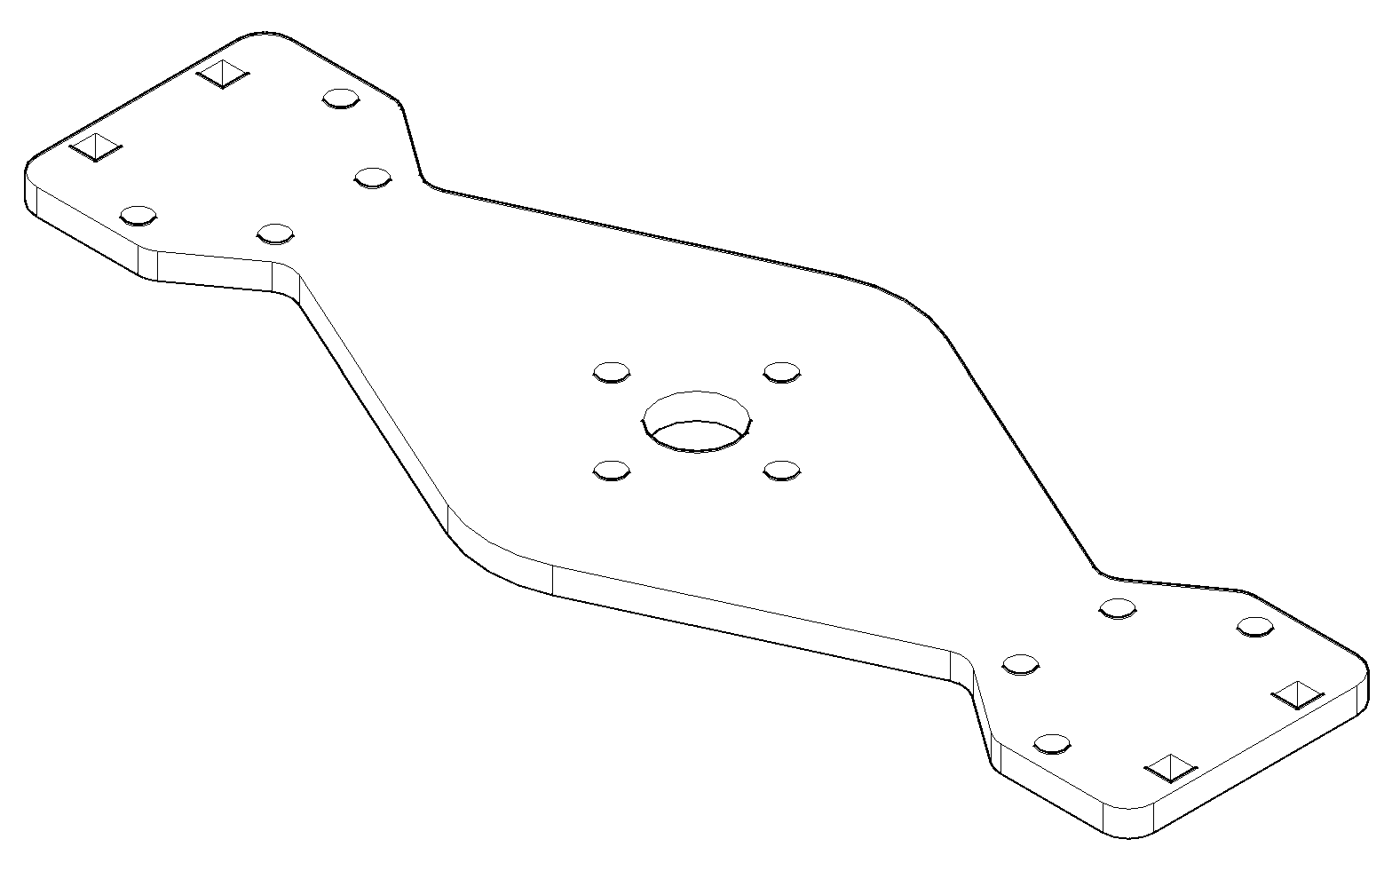
[picture p32: figure]

| Панель крепления колес (низ) (Деталь I) | 1 шт.

Состав корпуса

10

Изображение | Описание | Количество

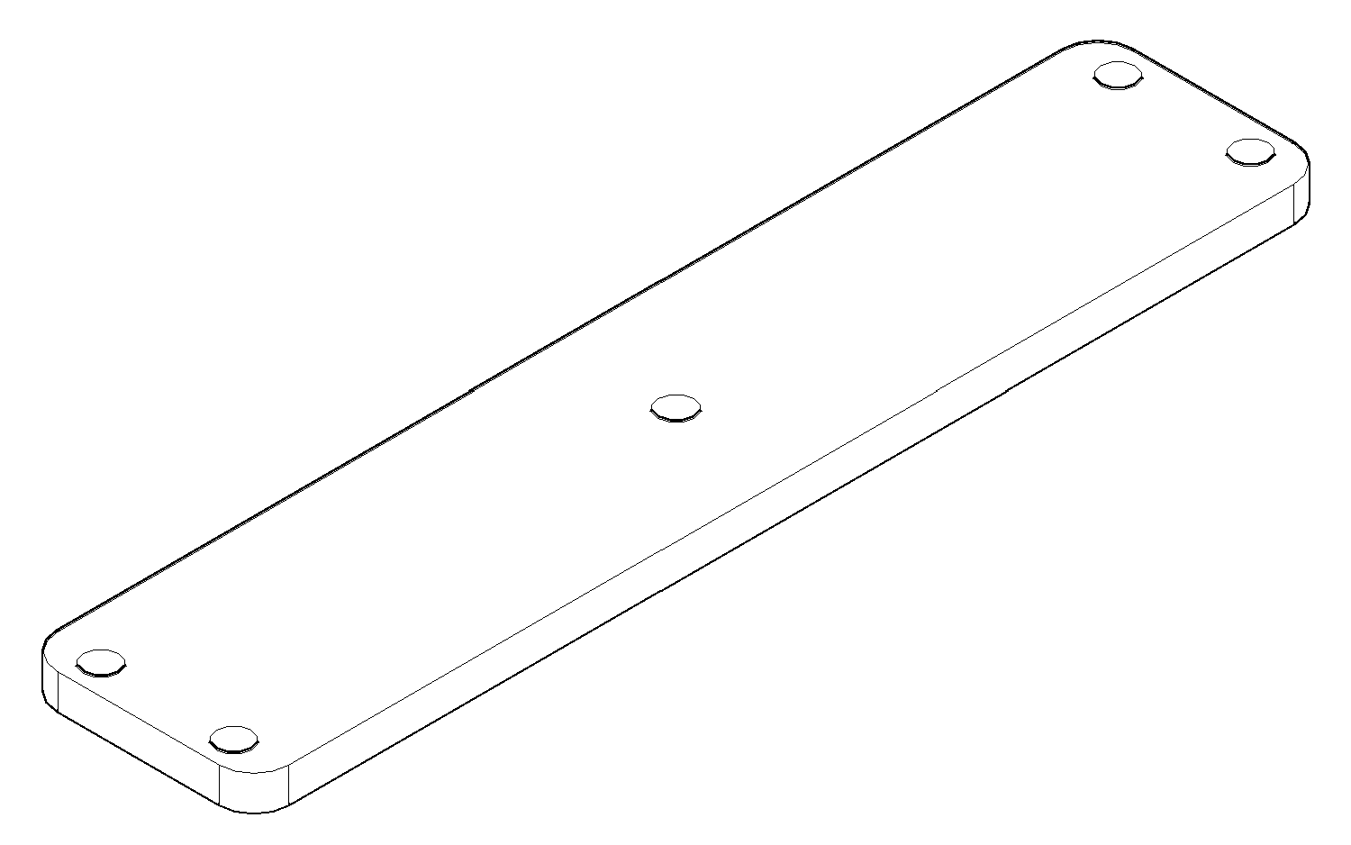
[picture p33: figure]

| Панель крепления колес (верх) (Деталь J) | 1 шт.

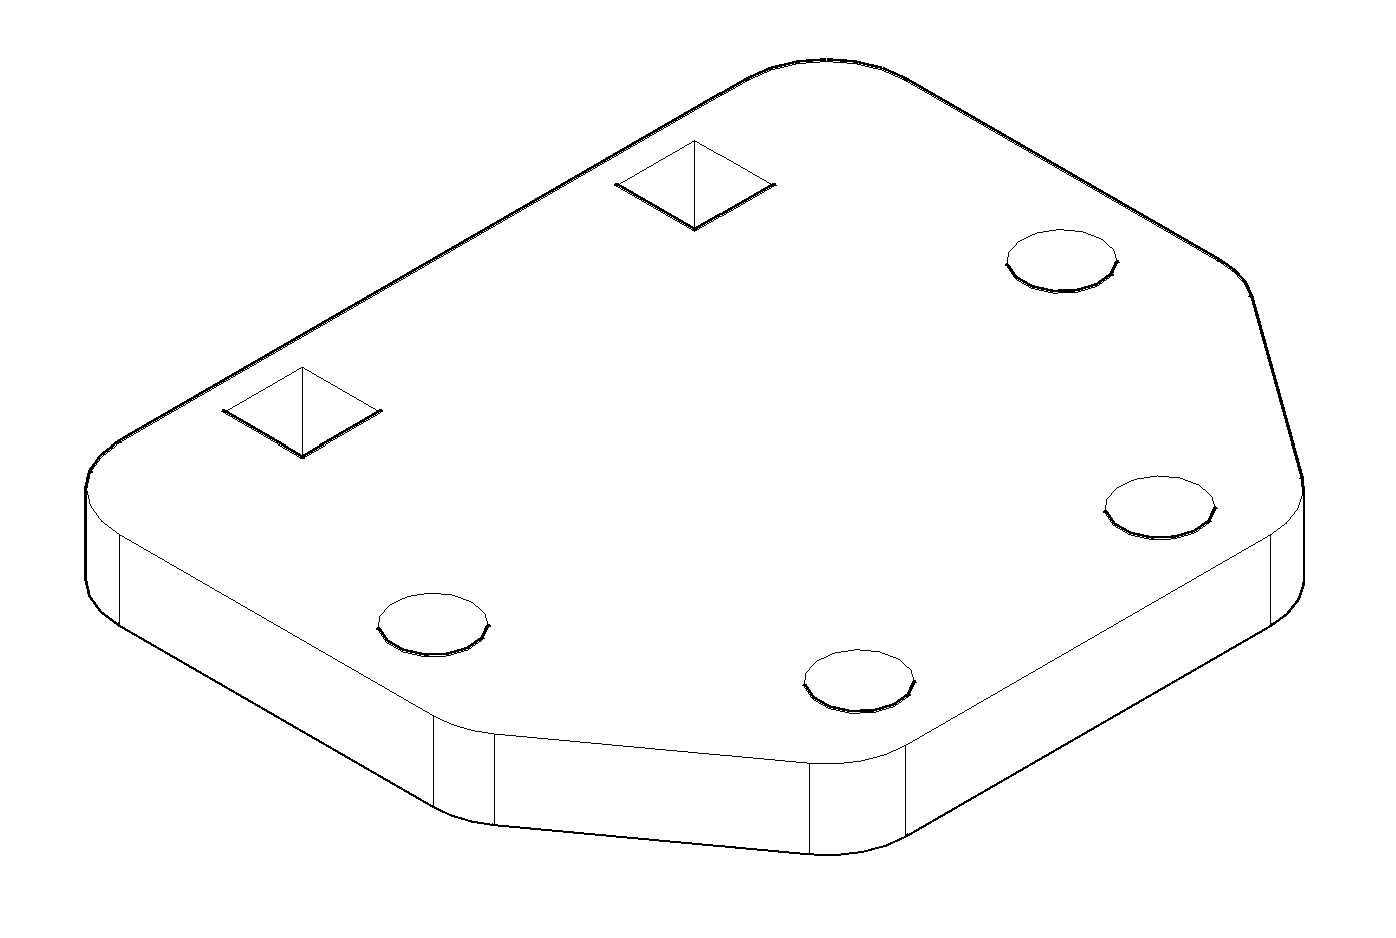
[picture p34: figure]

| Промежуточная панель крепления колеса (Деталь K) | 2 шт.

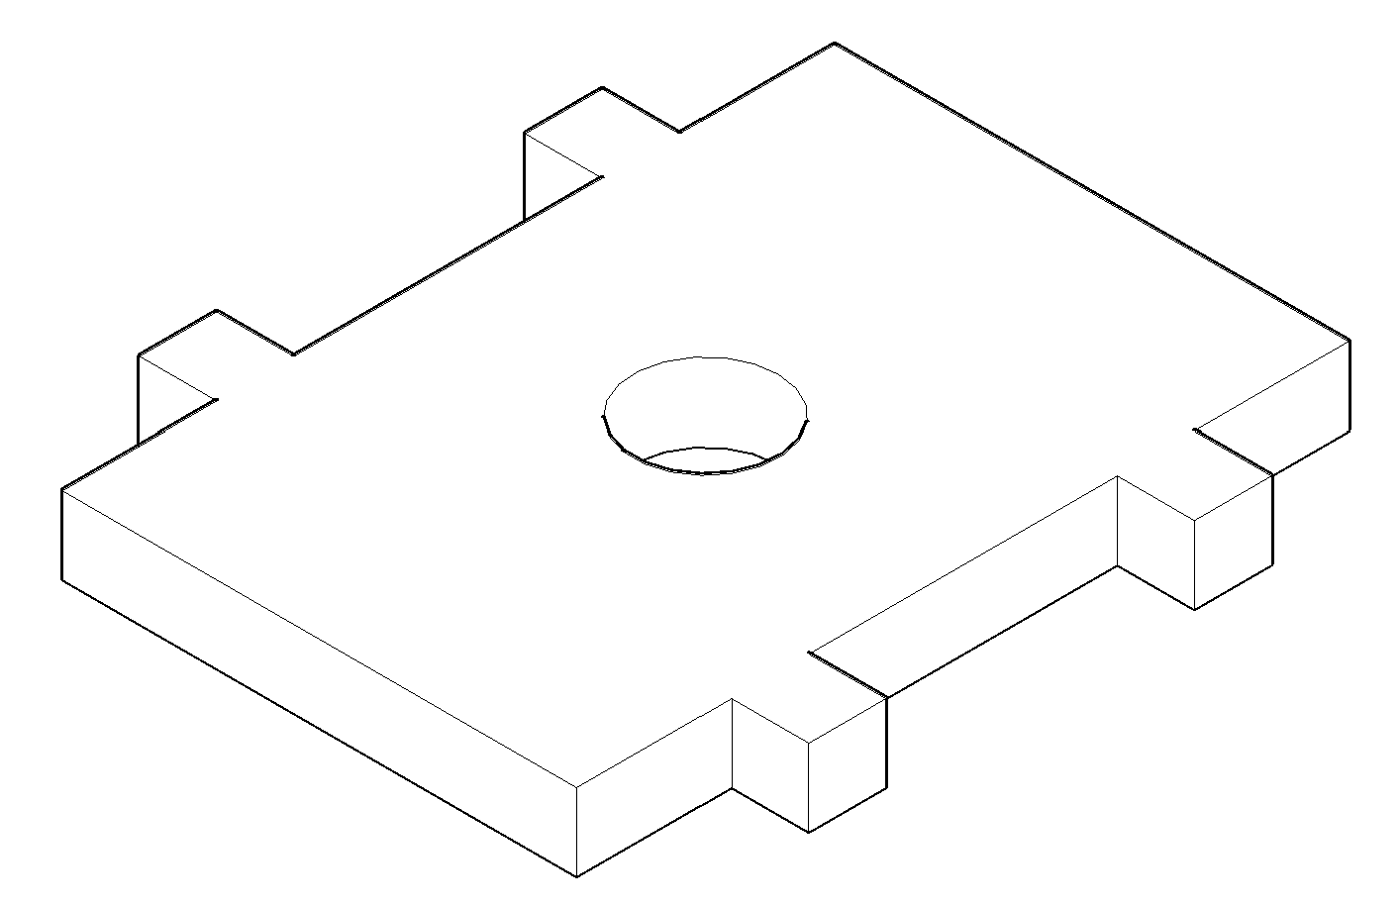
[picture p35: figure]

| Стойка крепления колеса (Деталь L) | 2 шт.

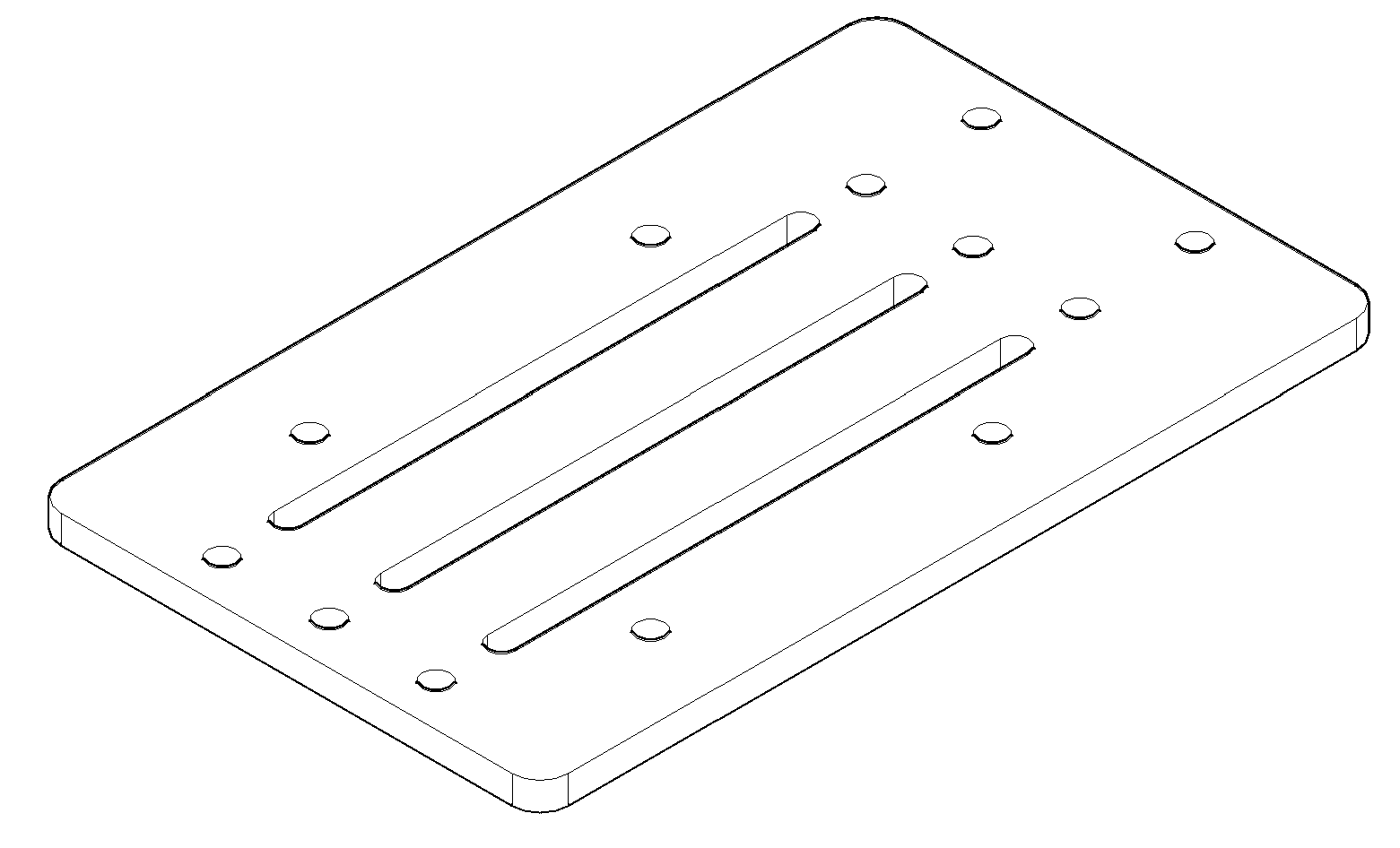
[picture p36: figure]

| Панель крепления контроллера двигателей (Деталь M) | 1 шт.

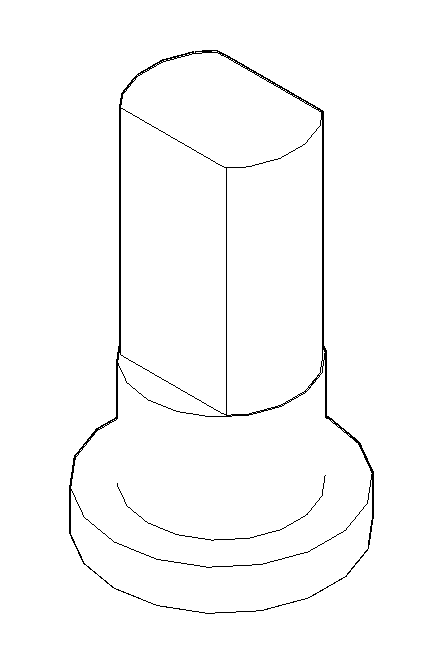
[picture p37: figure]

| Ступица переднего колеса (Деталь N) | 2 шт.

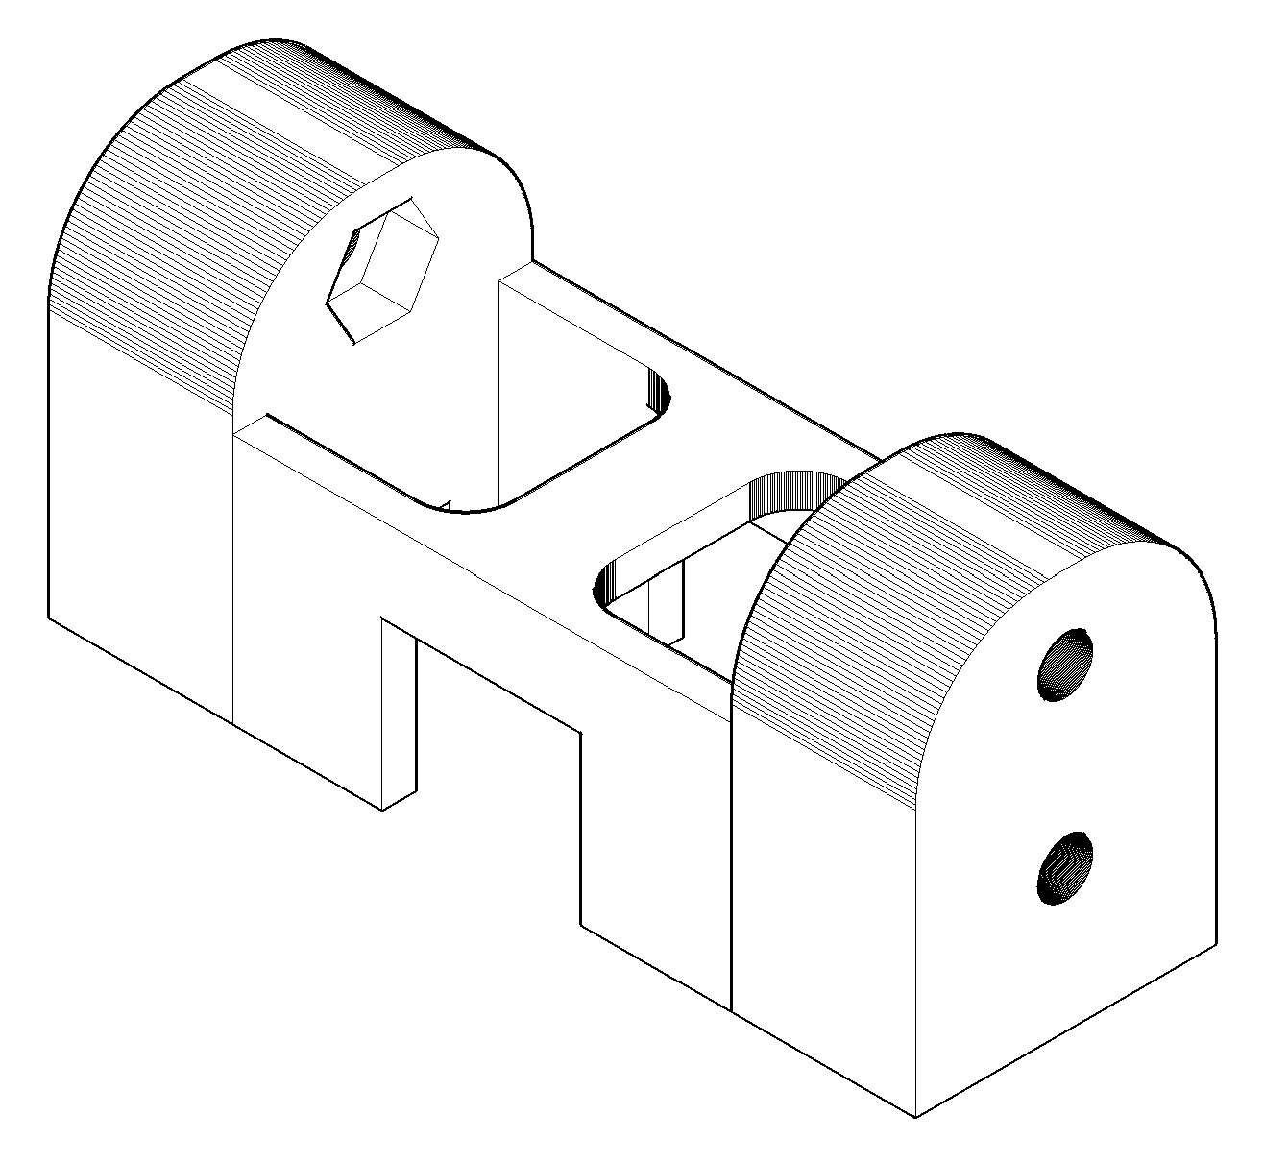
[picture p38: figure]

| Стойка ИК датчика (Деталь O) | 3 шт.

11

ШАГ 1: Установка ИК датчика в корпус
| х 3 | | х 3 | | х 9

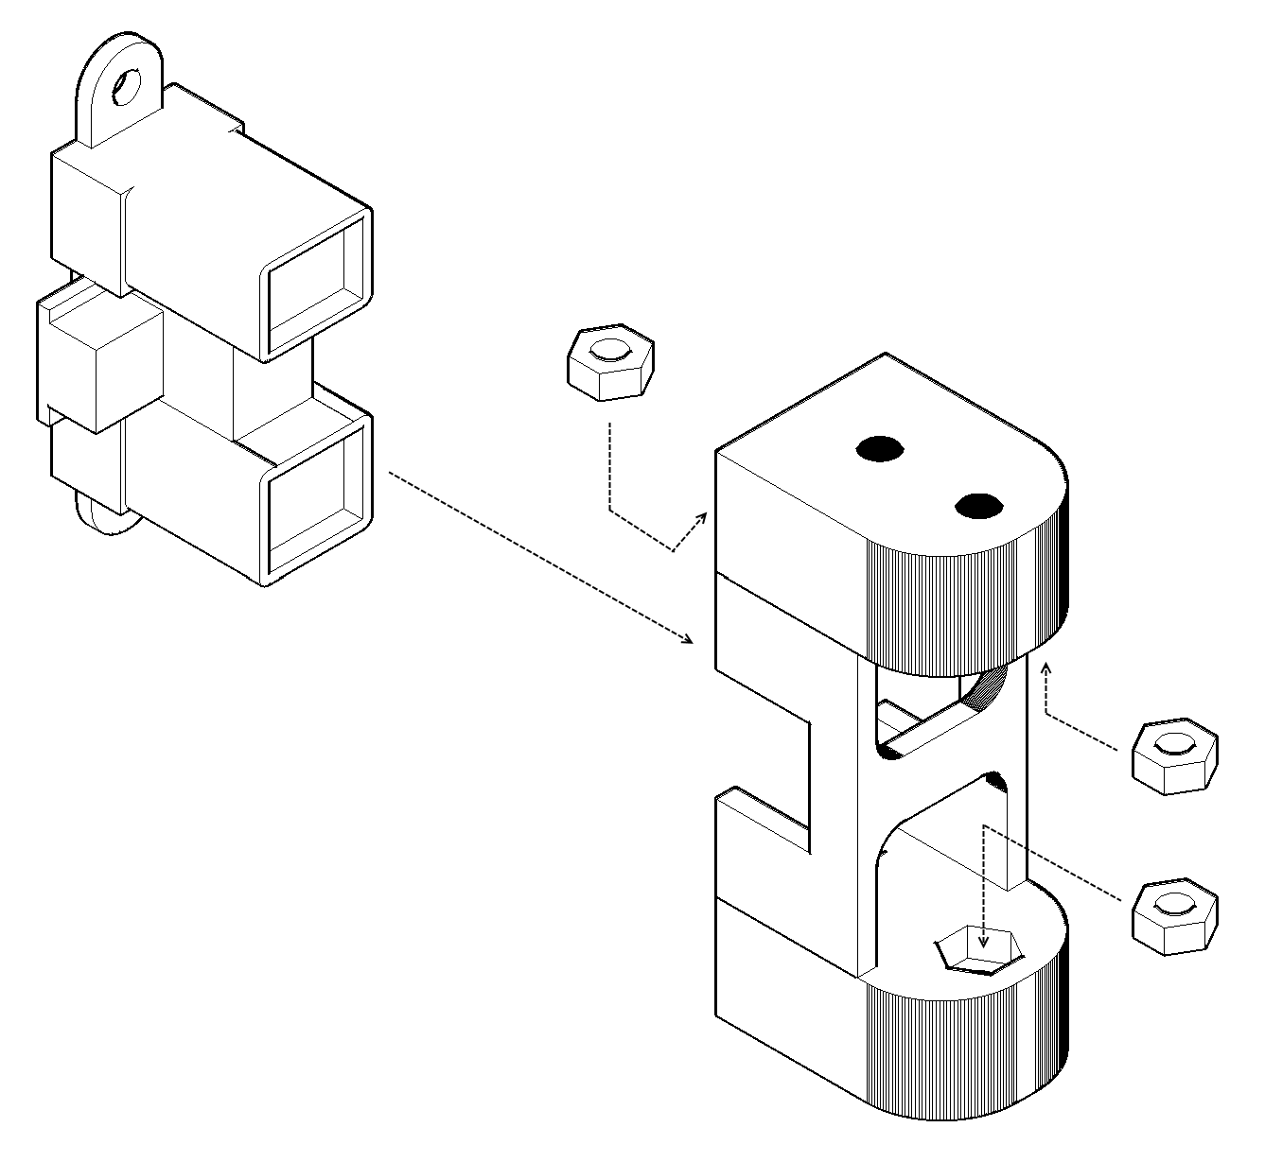
[picture p39: figure]

Возьмите Деталь O и установите 3 гайки в посадочные места. Затем установите ИК датчик в стойку. Повторите с оставшимися двумя датчиками.

ё

Инструкция по сборке

12

ШАГ 2: Установка ИК датчиков на нижнюю панель

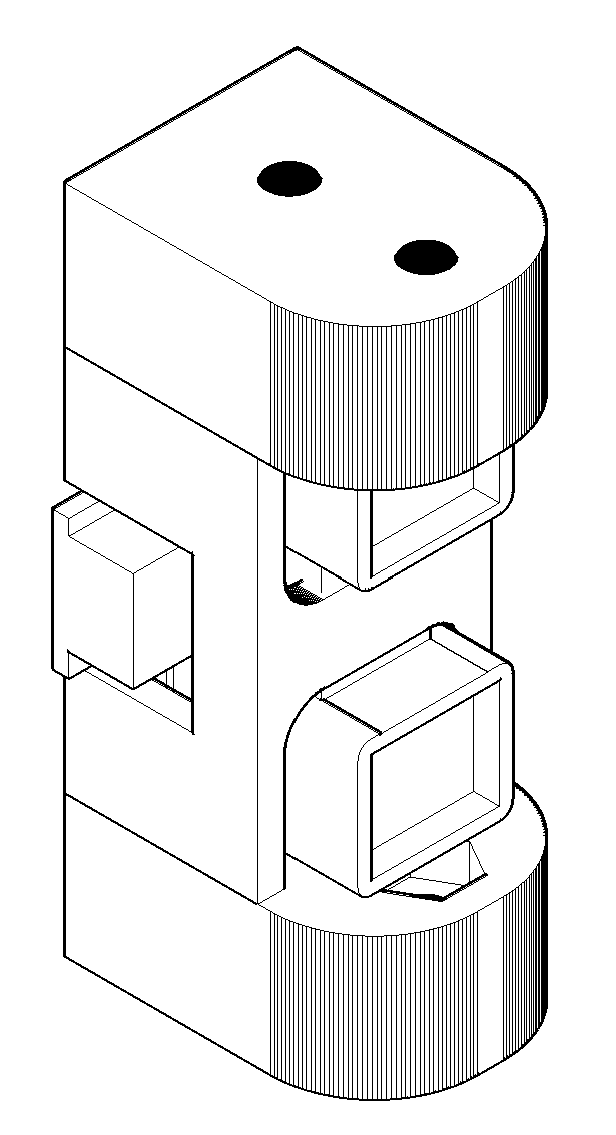
[picture p40: figure]

| х 3 | | х 1 | | х 6 | | х 3

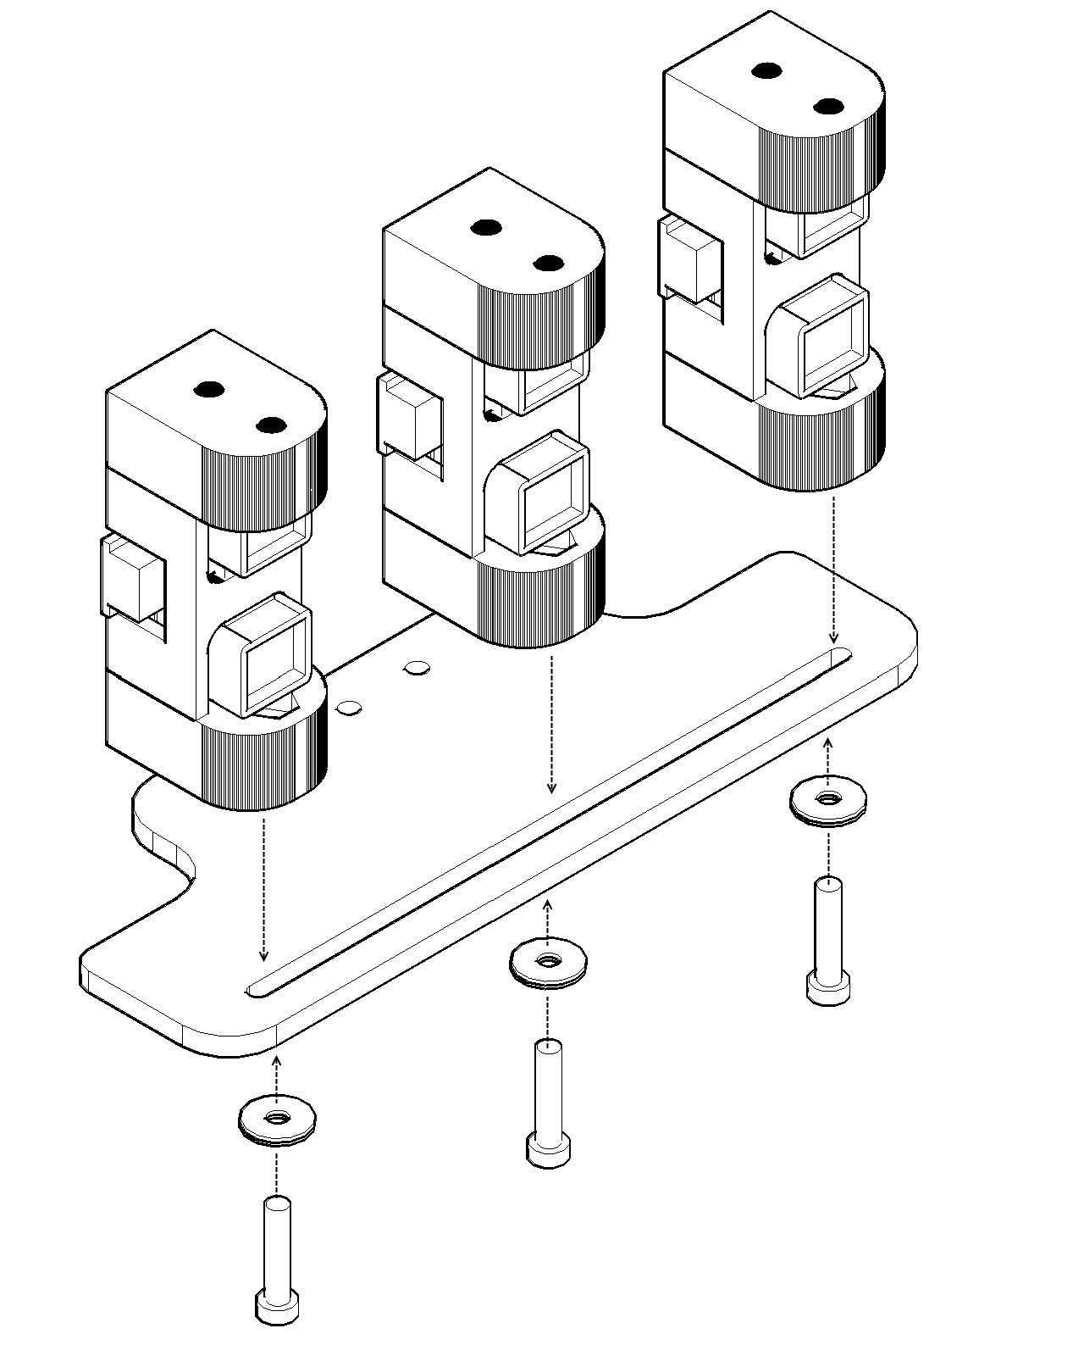
[picture p41: figure]

Возьмите Деталь G и части робота, собранные на шаге 1. Винтами с полукруглой шляпкой М3х16 прикрутите их к нижней панели крепления ИК датчиков. Между винтами и панелью положите по две шайбы М3.

13

ШАГ 3: Установка верхней панели крепления ИК датчиков

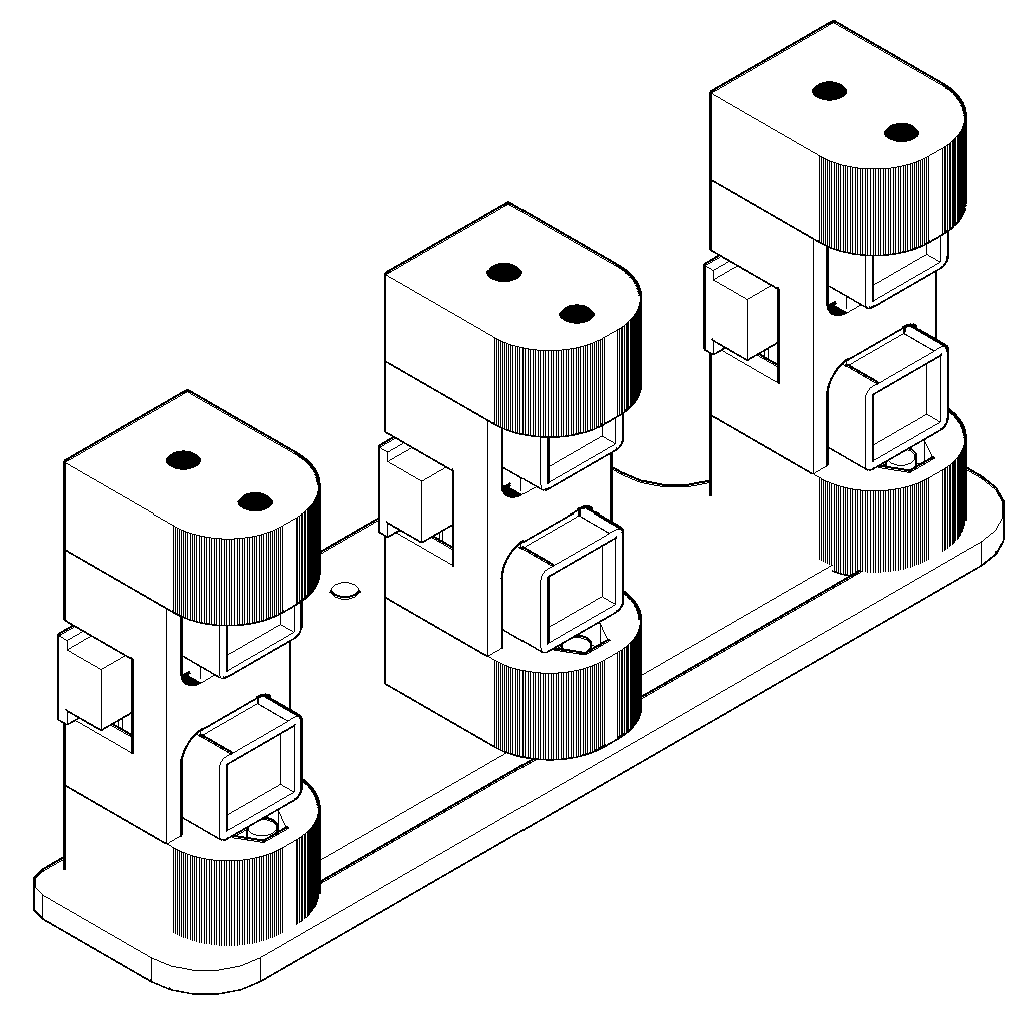
[picture p42: figure]

| х 1 | | х 1 | | х 12 | | х 6

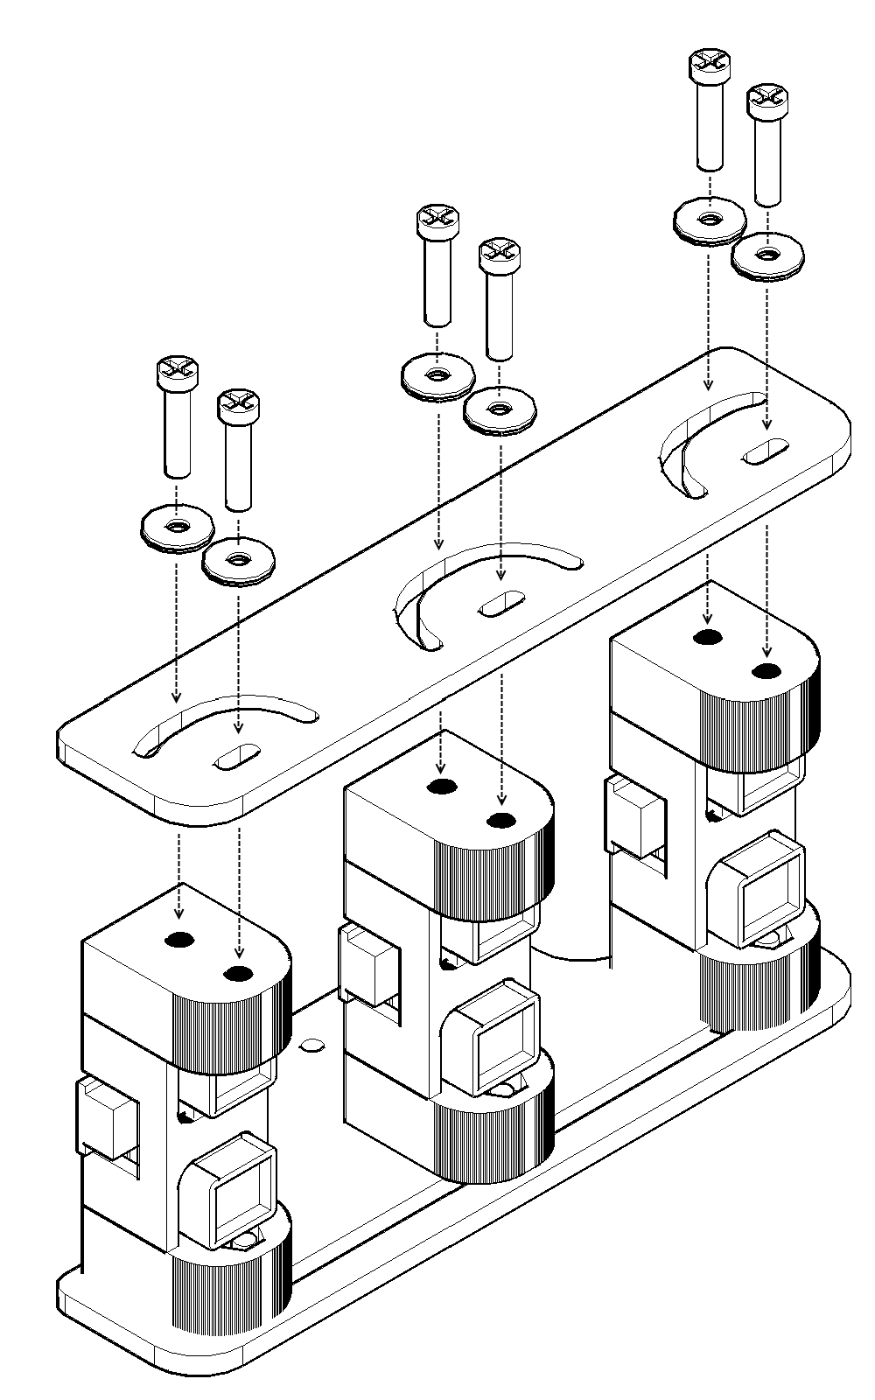
[picture p43: figure]

Возьмите Деталь H и часть робота, собранную на шаге 2. Винтами с полукруглой шляпкой М3х16 прикрутите их к ИК датчикам. Между винтами и панелью положите по две шайбы М3.

14

ШАГ 4: Установка крепления колес к сервоприводу

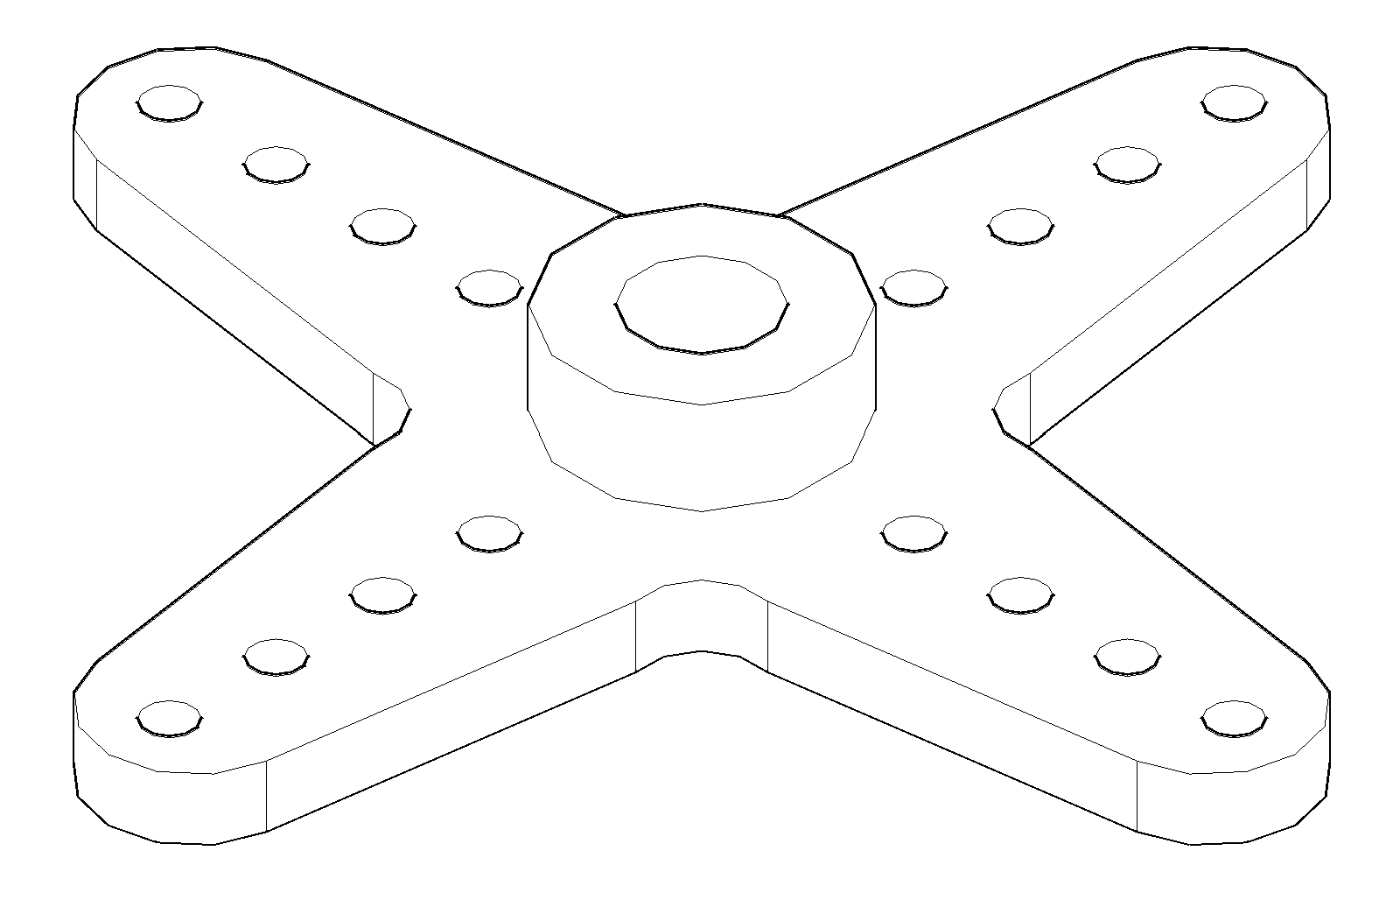
[picture p44: figure]
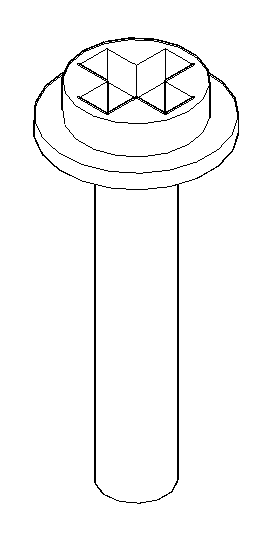
[picture p45: figure]

| х 1 | | х 1 | | х 4

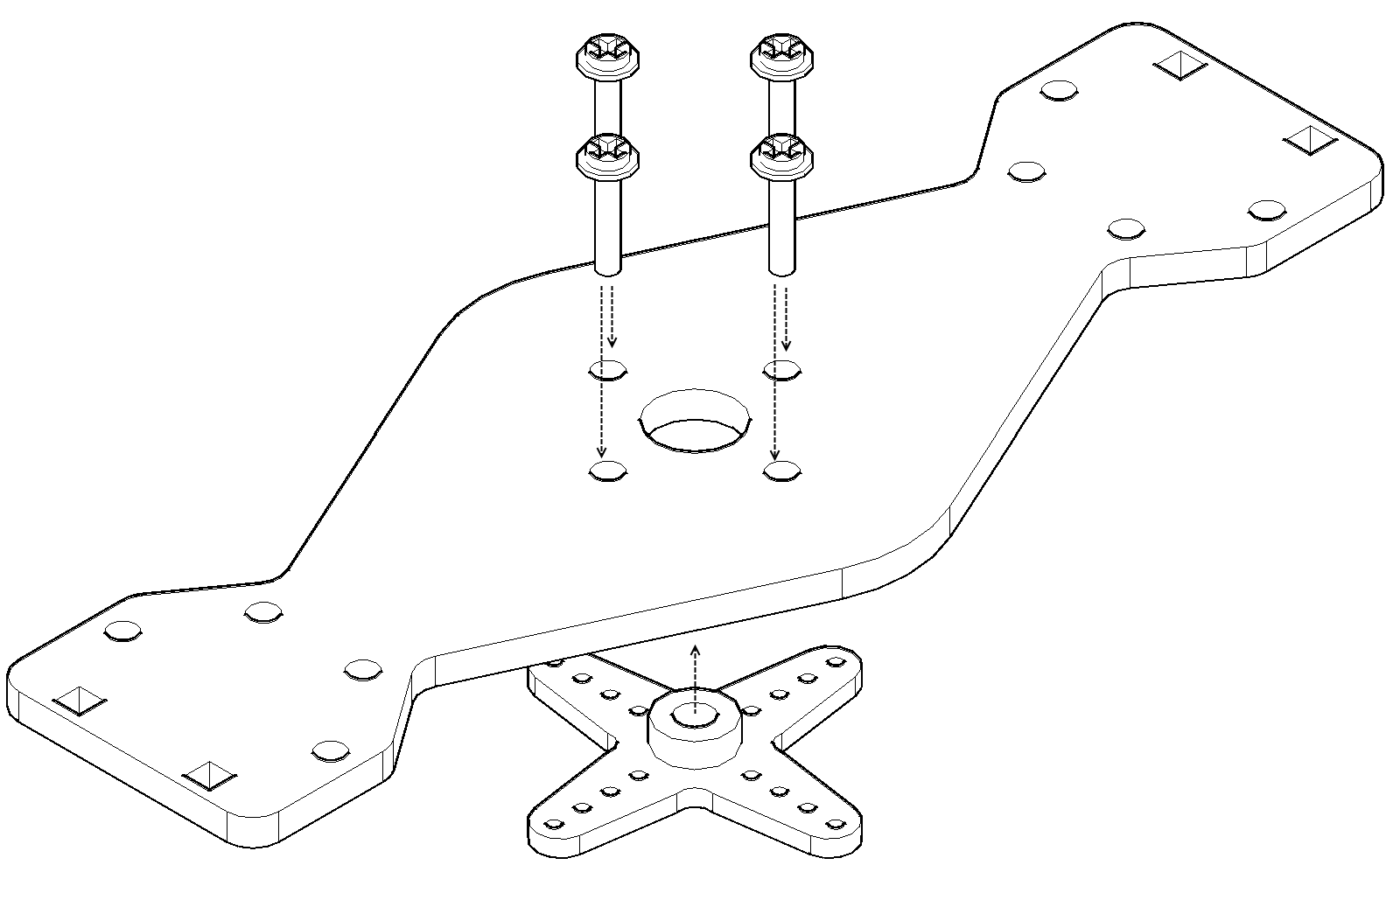
[picture p46: figure]

Возьмите Деталь I и крестовой переходник, который идет в комплекте с сервоприводом. Саморезами, которые идут в комплекте с сервоприводом, прикрутите крестовой переходник к нижней панели крепления колес.

15

ШАГ 5: Установка стоек крепления передних колес

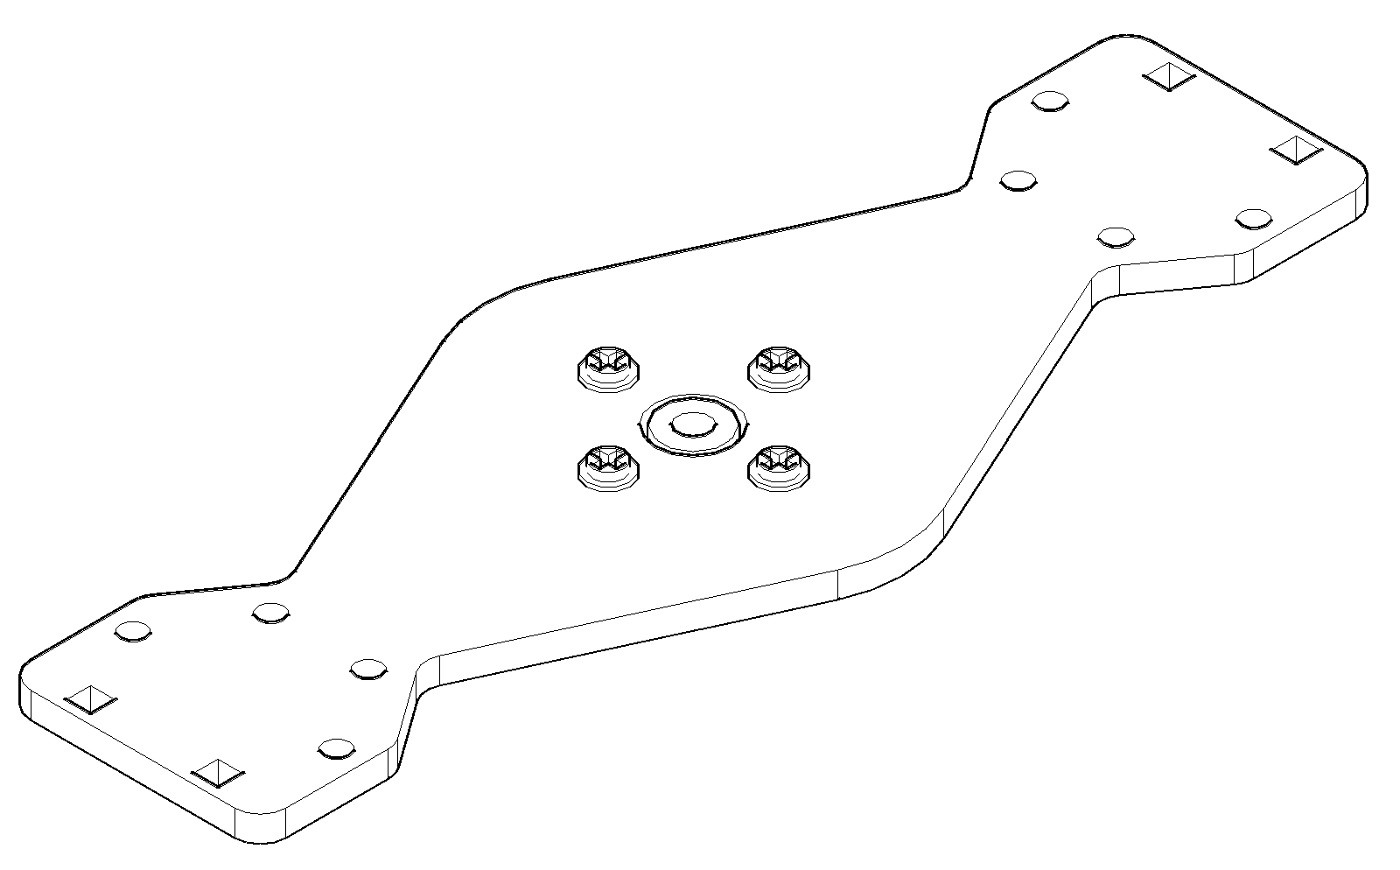
[picture p47: figure]

| х 1 | | х 1 | | х 1 | | х 2 | | х 4

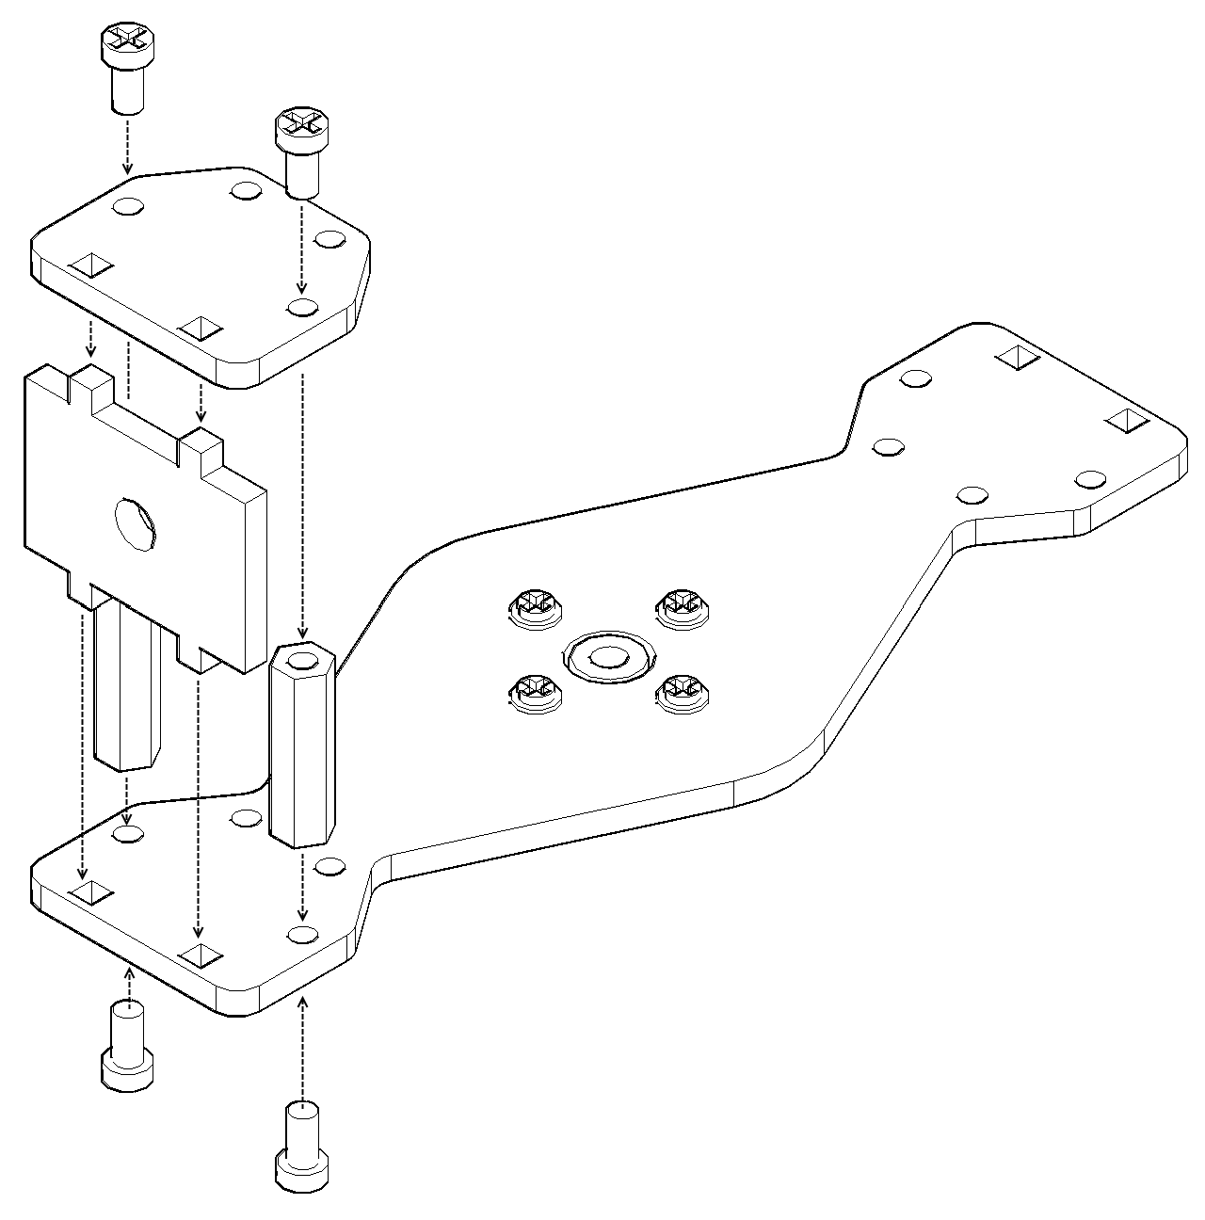
[picture p48: figure]

Возьмите Детали K, L и часть робота, собранную на шаге 4. Винтами с полукруглой шляпкой М3х6 прикрутите детали к стойкам М3х20 как изображено на схеме.

16

ШАГ 6: Установка стоек крепления передних колес

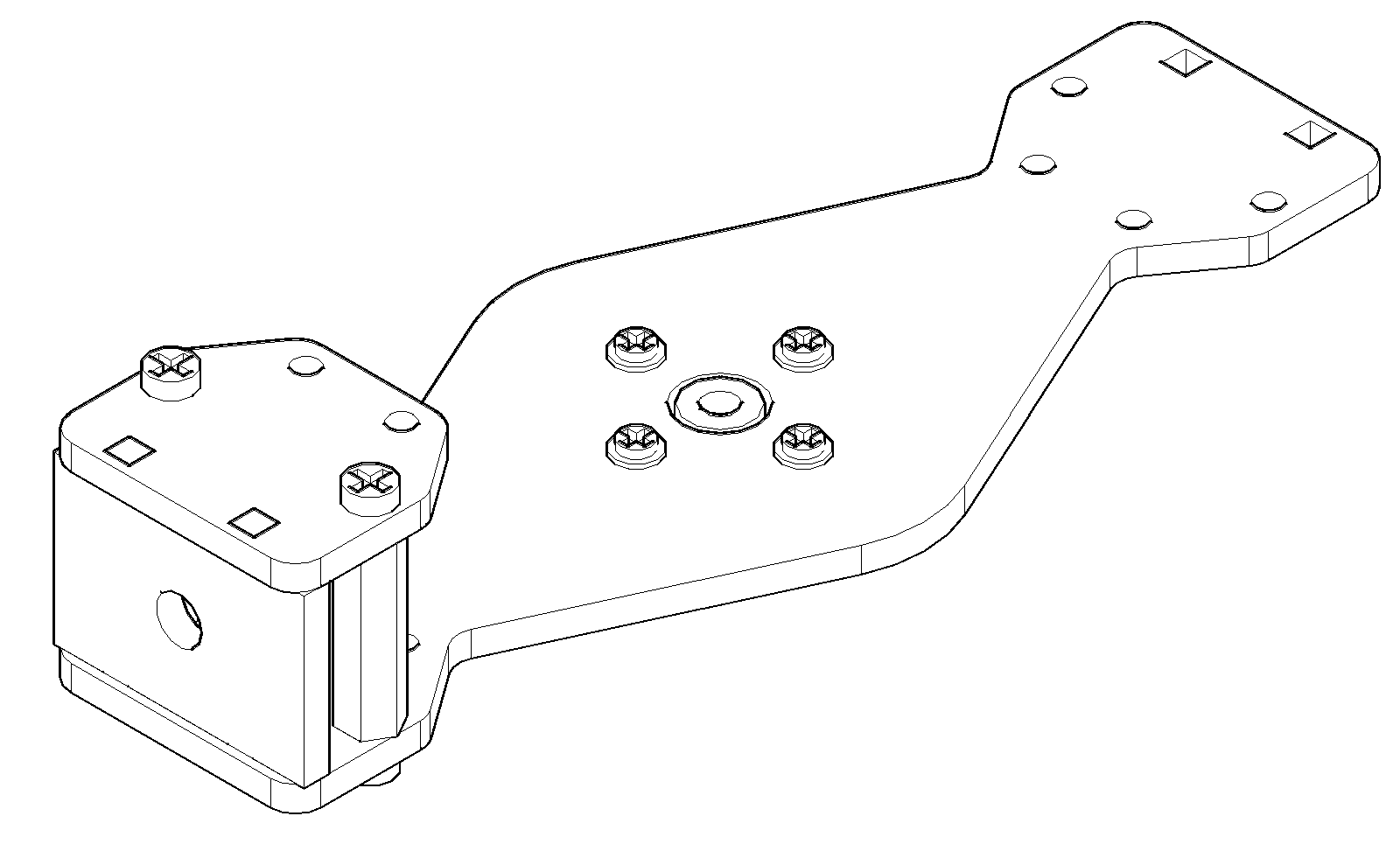
[picture p49: figure]

| х 1 | | х 1 | | х 1 | | х 2 | | х 4

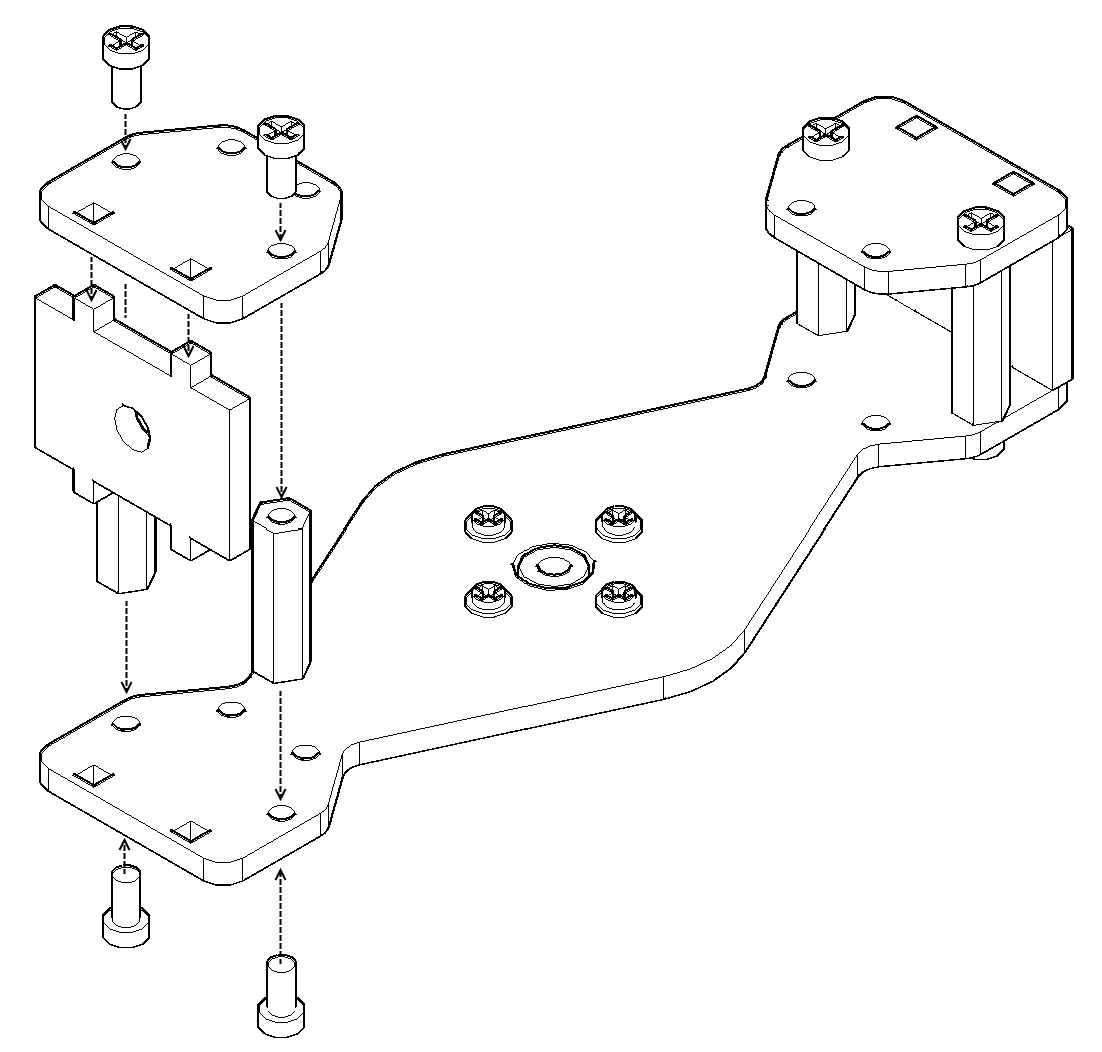
[picture p50: figure]

Возьмите Детали K, L и часть робота, собранную на шаге 5. Винтами с полукруглой шляпкой М3х6 прикрутите детали к стойкам М3х20 как изображено на схеме.

17

ШАГ 7: Установка стоек для крепления верхней панели крепления колес

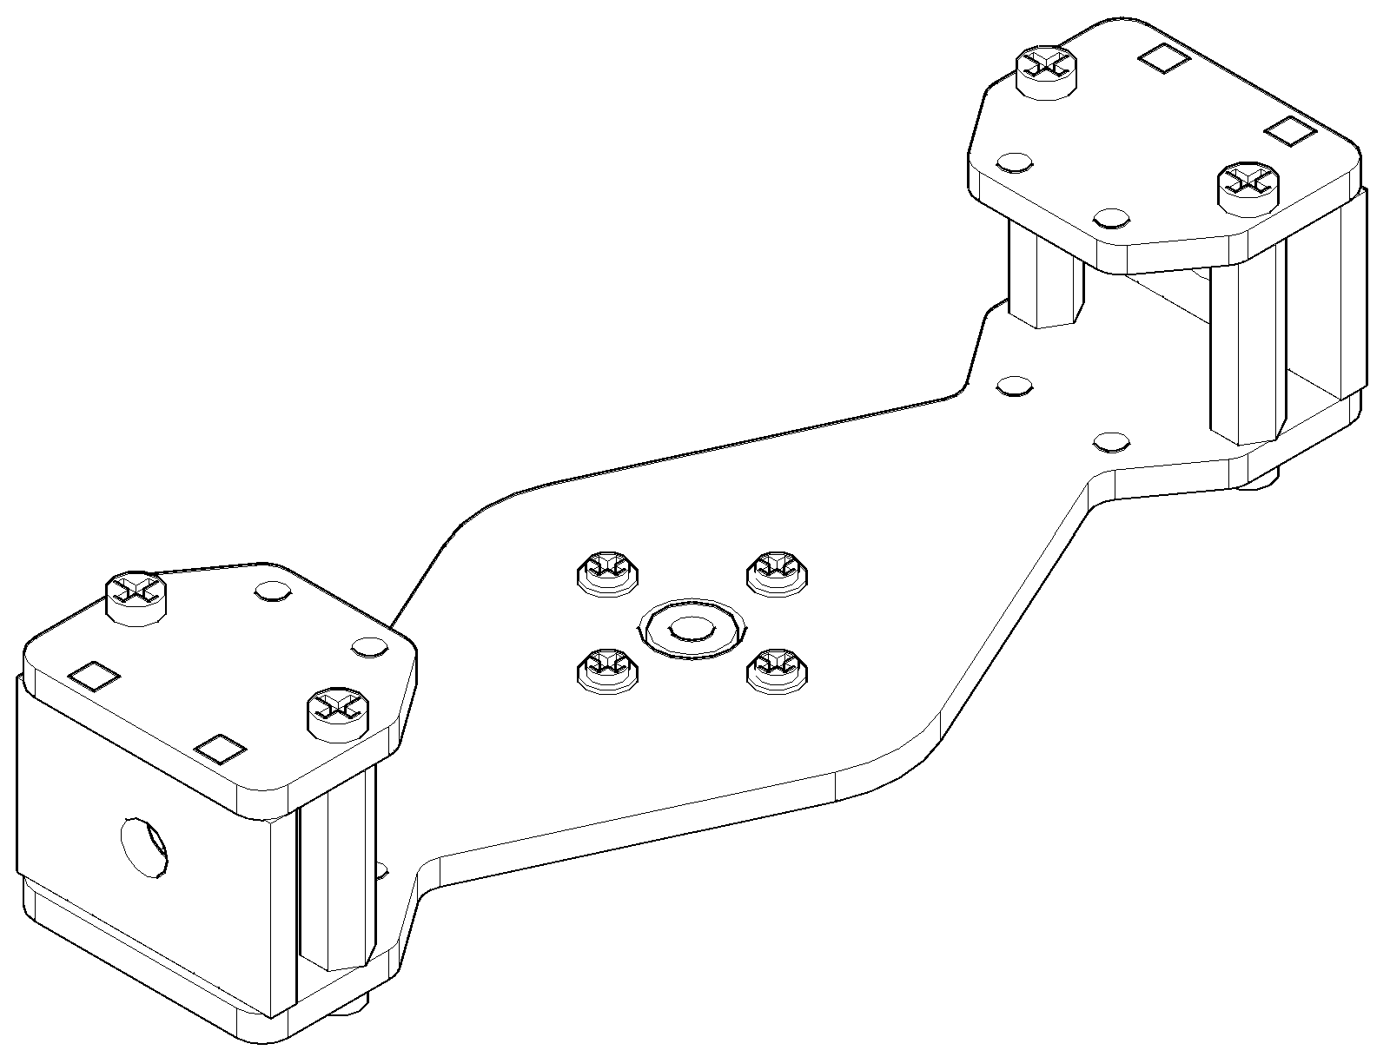
[picture p51: figure]

| х 1 | | х 4 | | х 4

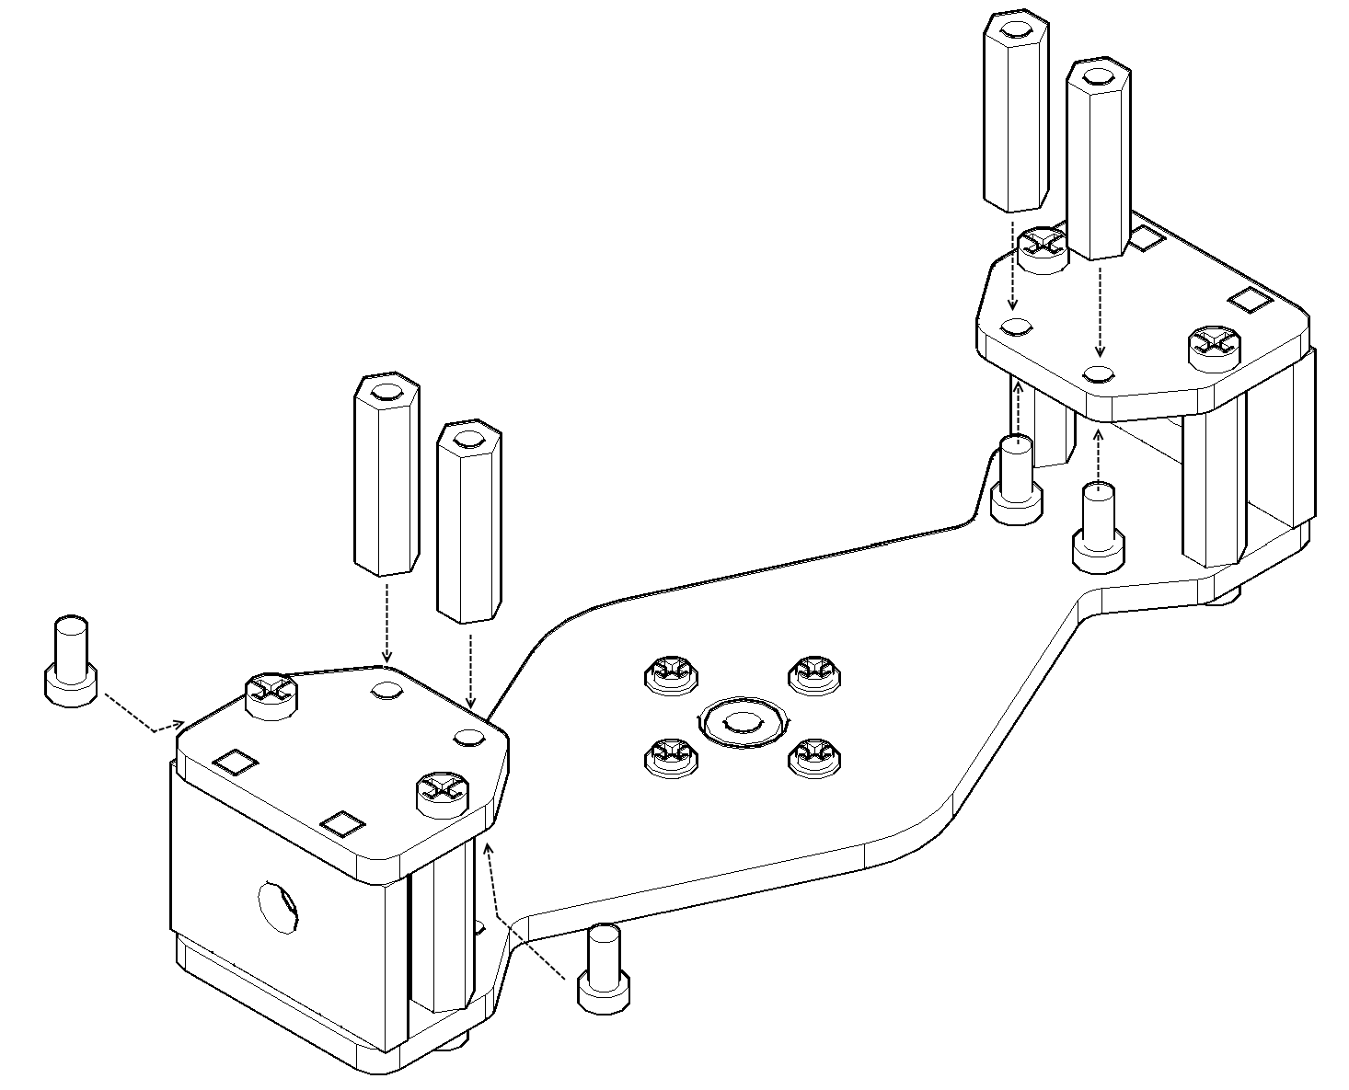
[picture p52: figure]

Возьмите часть робота, собранную на шаге 5. Винтами с полукруглой шляпкой М3х6 прикрутите стойки М3х20 как изображено на схеме.

18

ШАГ 8: Сборка блока аккумуляторов
| х 1 | | х 1

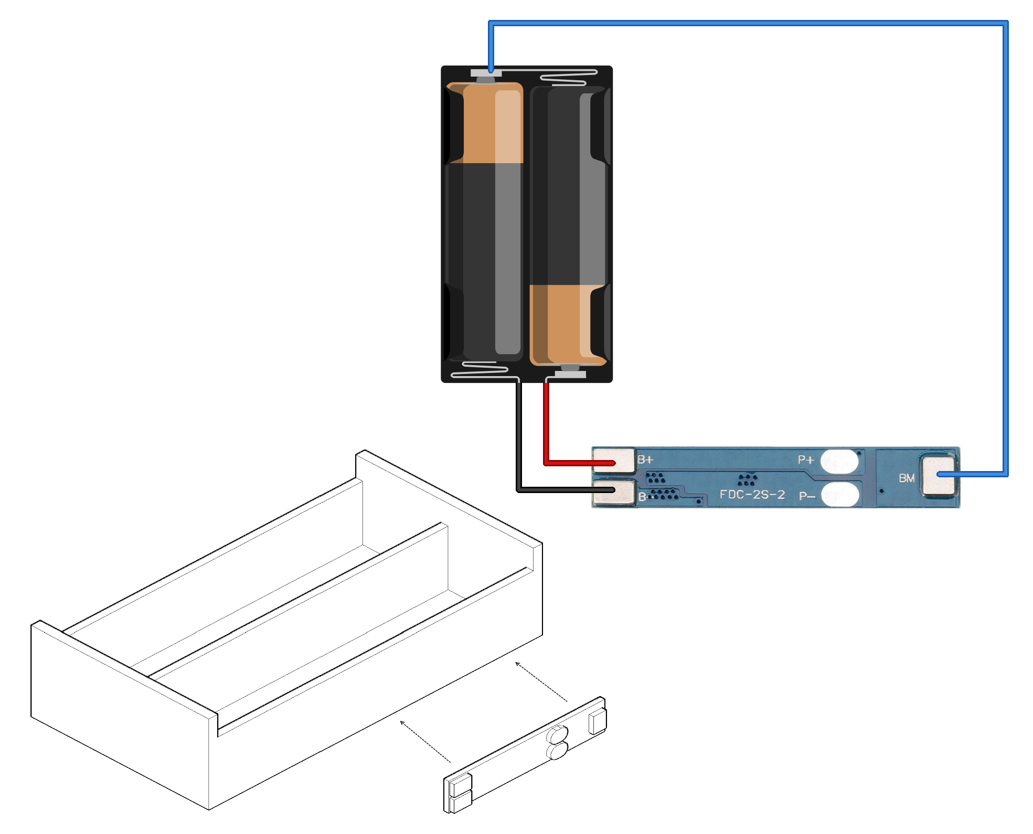
[picture p53: figure]

На данном шаге необходимо объединить батарейный отсек и контроллер разряда/заряда аккумуляторов по схеме, изображенной в правом углу. Мы рекомендуем Вам закрепить контроллер на батарейном отсеке при помощи двустороннего скотча, как изображено на схеме в левом углу.

19
