Ant0Kr/Circuit-design/Презентация/Presentation.pptx

## Курсовой проект по схемотехнике “Робот - конструктор”

Ст. гр. 550504
Василевский И.А
Карачун А.С.

## Задачи и цели курсового проекта:

Задачи:
- Разработка и сборка робота-конструктора на базе готового материала.
- Сборка второго робота(прототипа).
- Разработка и создание инструкции по сборке с 3D моделями.
Цели:
- Получить новые знания и умения в освоении работы с Arduino.
- Получить навыки сборки роботов.
- Получить умения в написании инструкции по сборке и основной документации к проекту.

## Ресурсы

## Slide 4

## Вспомогательное оборудование

  - Набор инструментов для сборки
  - Станок по резке оргстекла
  - 3D – принтер

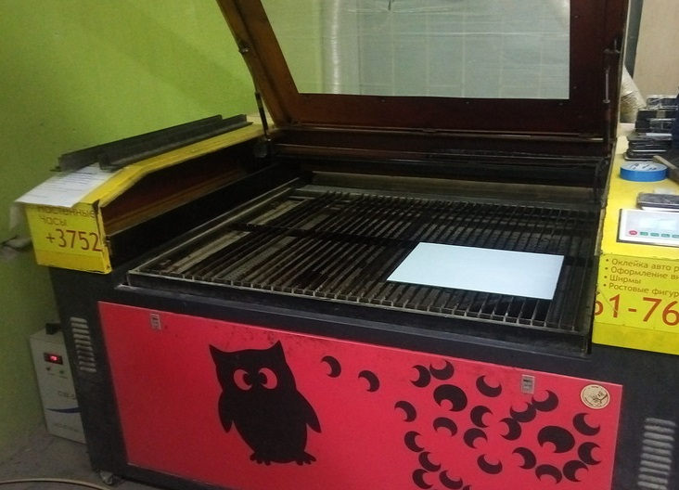
[picture p92: figure]
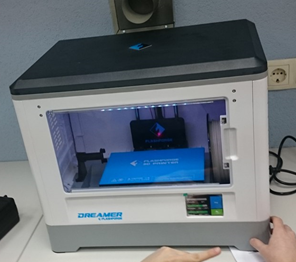
[picture p93: figure]

## Софт

- 3d Max , AutoCAD, Paint.net, CorelDraw – графические редакторы. Львиная доля всех чертежей была выполнена в AutoCAD.
- FlashPrint – программа для печати моделей на 3D принтере.
- Fritzing – программа для виртуального моделирования электрических цепей и схем и прочего электронного оборудования.
- Arduino IDE – среда разработки под Arduino.
- MS Office – офис, куда же без него.
- GitHub + GitKraken – система контроля версий, и удобное Git GUI приложение.

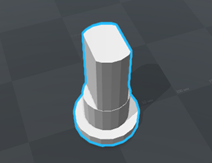
[picture p94: figure]
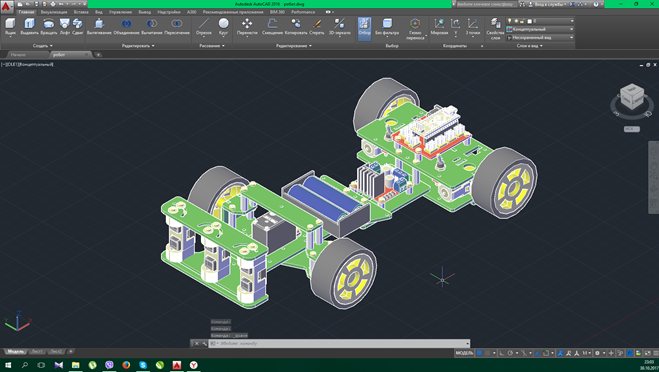
[picture p95: figure]
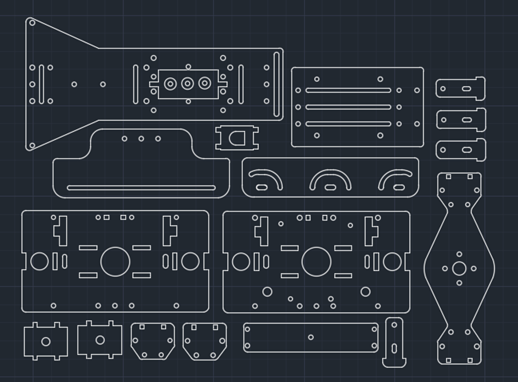
[picture p96: figure]

## Подготовка чертежей

Для того чтобы собрать прототип робота, необходимо было сделать чертежи его корпуса. Так же были созданы 3D модели корпусов для ИК датчиков и колесных ступиц. Имея готовый корпус, были сделаны необходимые измерения для чертежей:

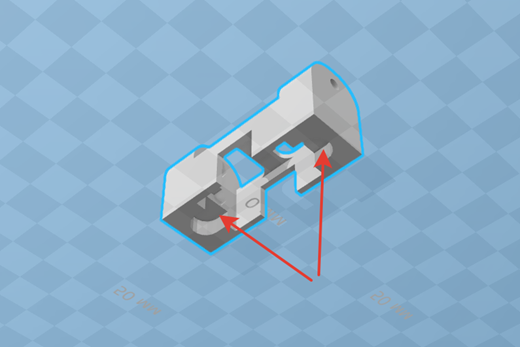
[picture p97: figure]
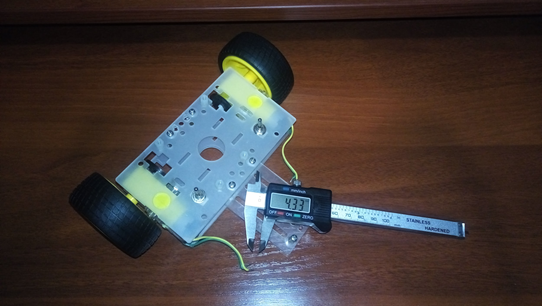
[picture p98: figure]

## Подготовка корпуса

Корпус робота был вырезан из оргстекла , а помогли нам - Lazer (http://lazerbro.by/) (http://lazerbro.by/)BROTHERS (http://lazerbro.by/).

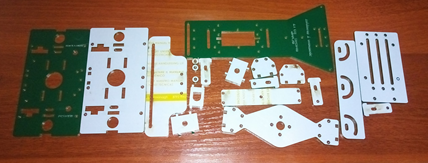
[picture p99: figure]
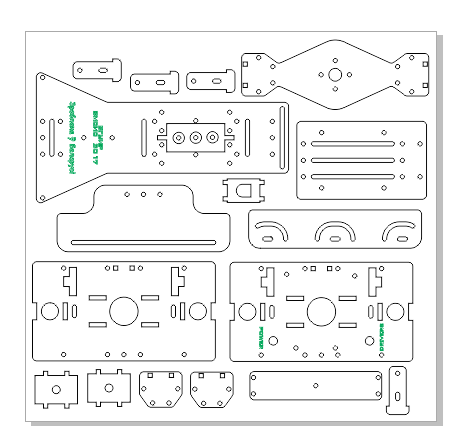
[picture p100: figure]

## Подготовка 3D деталей

Корпуса для ИК датчиков и колесные ступицы были напечатаны на 3D принтере в лаборатории 207б-5.

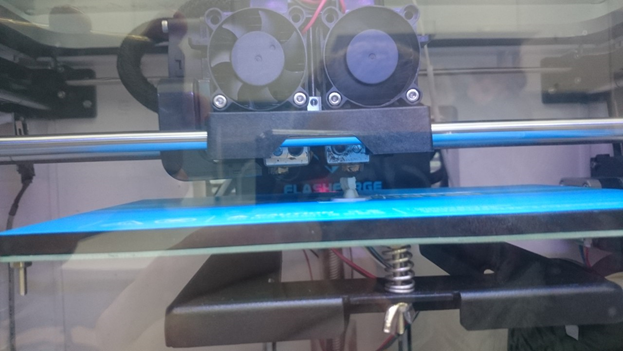
[picture p101: figure]
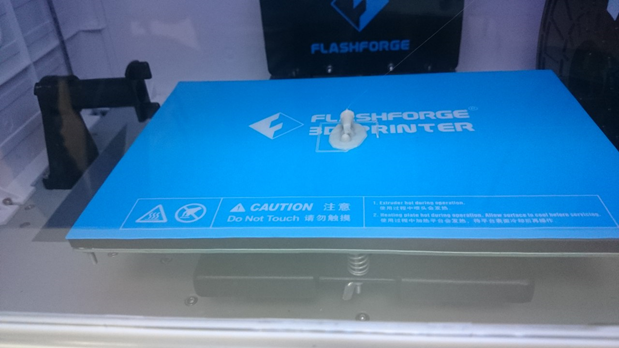
[picture p102: figure]

## Slide 10

## Slide 11

## Slide 12

## Slide 13

## Slide 14

## Slide 15

## Slide 16

## Slide 17

## Slide 18

## Slide 19

## Slide 20

## Slide 21

- https://github.com/Ant0Kr/Circuit-design
