Ant0Kr/Circuit-design/Cхемы/robot.pdf

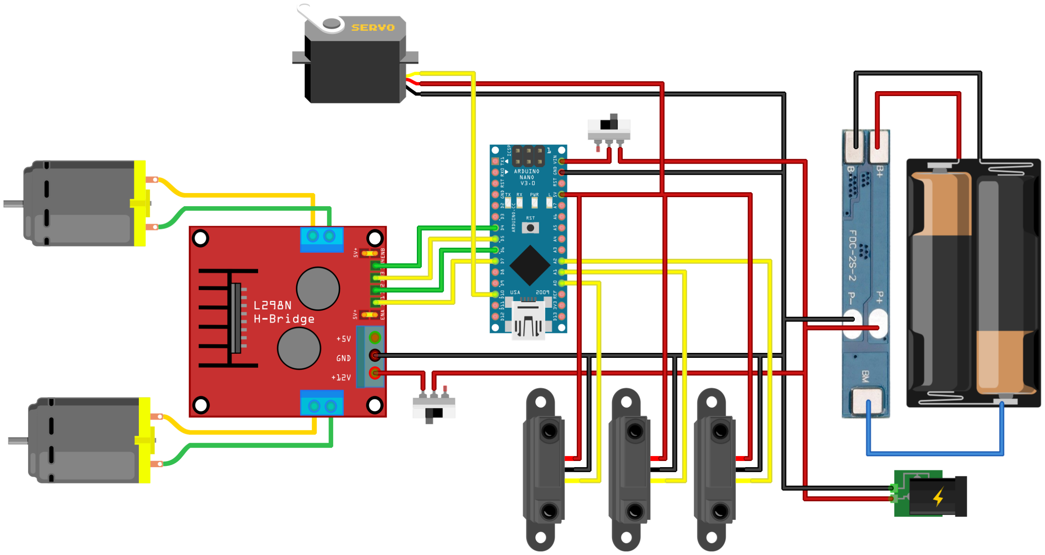
[picture p103: page 1]
