Ant0Kr/Circuit-design/Инструкция/Необходимые комплектующие/Винт.png

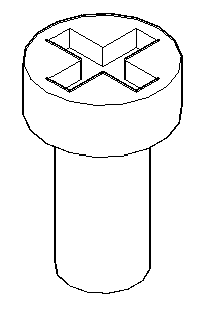
Инструкция/Необходимые комплектующие/Винт.png
