Ant0Kr/Circuit-design/Инструкция/Необходимые комплектующие/Стойка.png

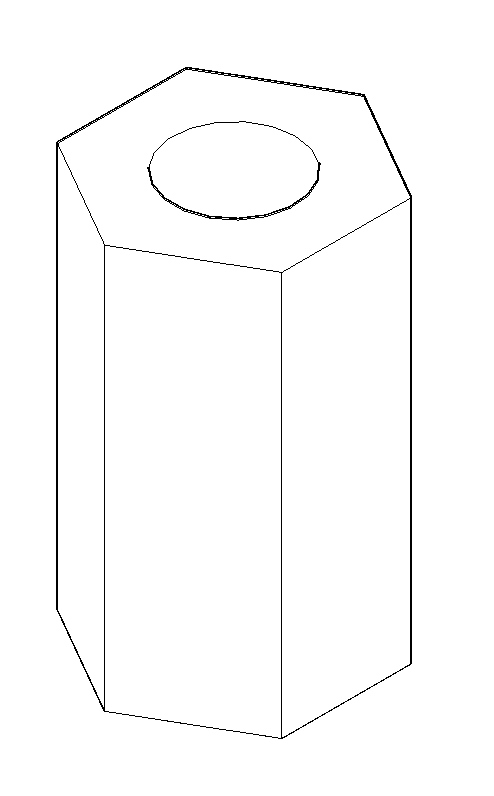
Инструкция/Необходимые комплектующие/Стойка.png
