Ant0Kr/Circuit-design/Инструкция/Подложка.jpg

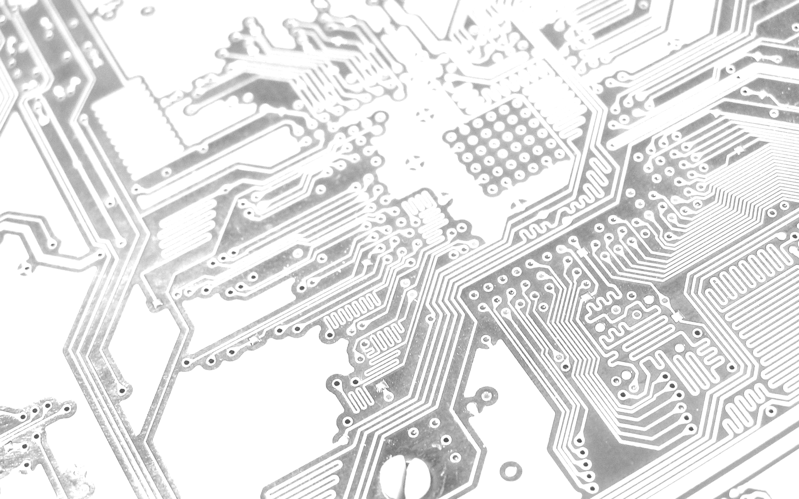
Инструкция/Подложка.jpg
