Ant0Kr/Circuit-design/Инструкция/Схема.png

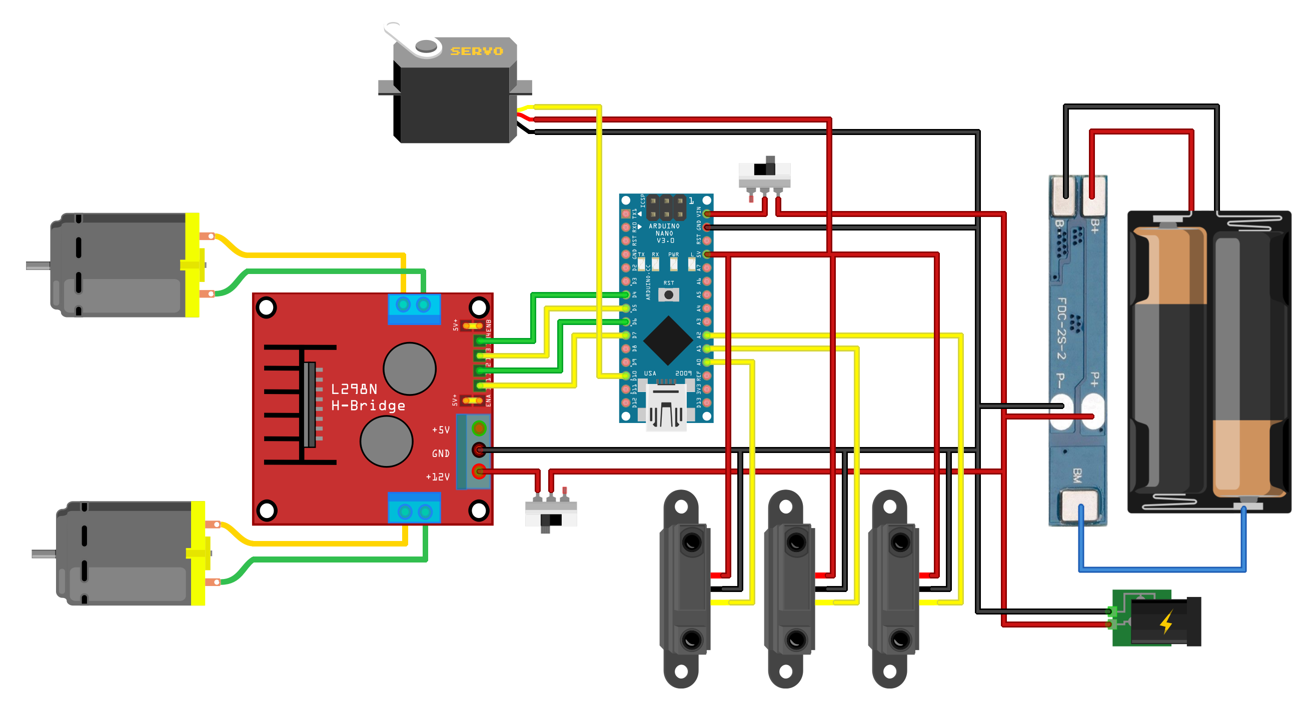
Инструкция/Схема.png
