Ant0Kr/Circuit-design/Инструкция/Шаги/Шаг 10!.png

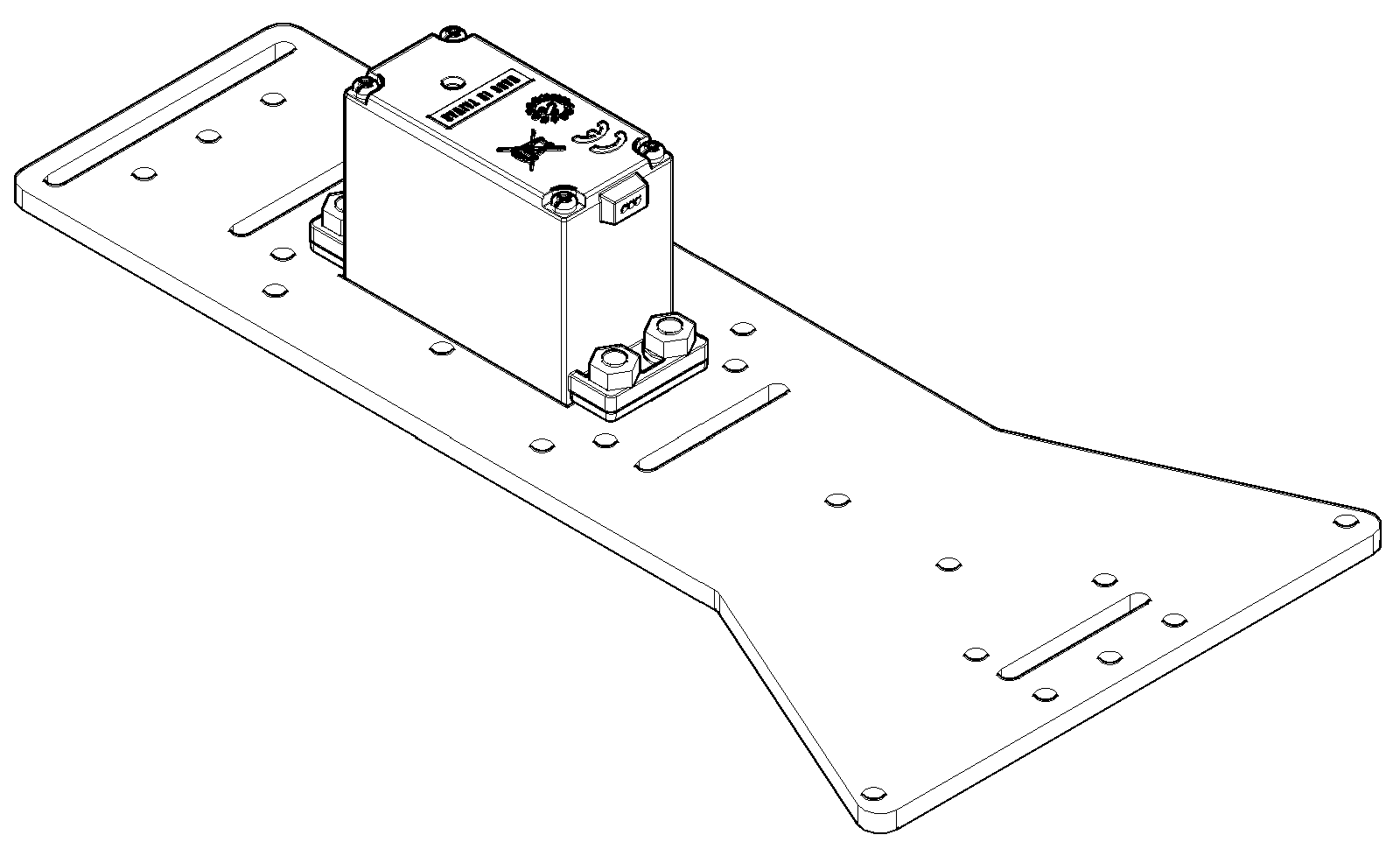
Инструкция/Шаги/Шаг 10!.png
