Ant0Kr/Circuit-design/Инструкция/Шаги/Шаг 12!.png

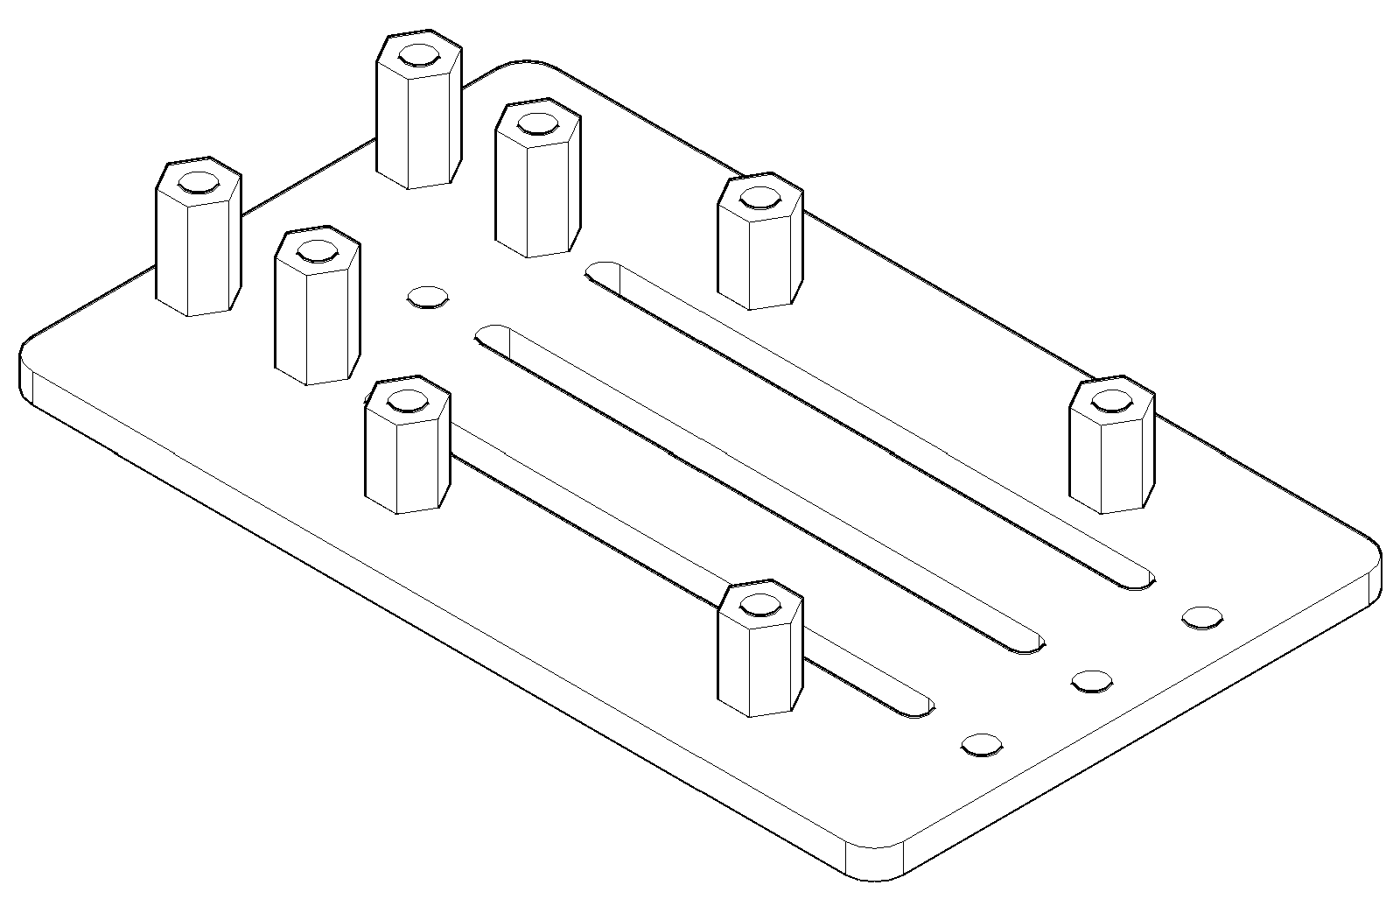
Инструкция/Шаги/Шаг 12!.png
