Ant0Kr/Circuit-design/Инструкция/Шаги/Шаг 14!.png

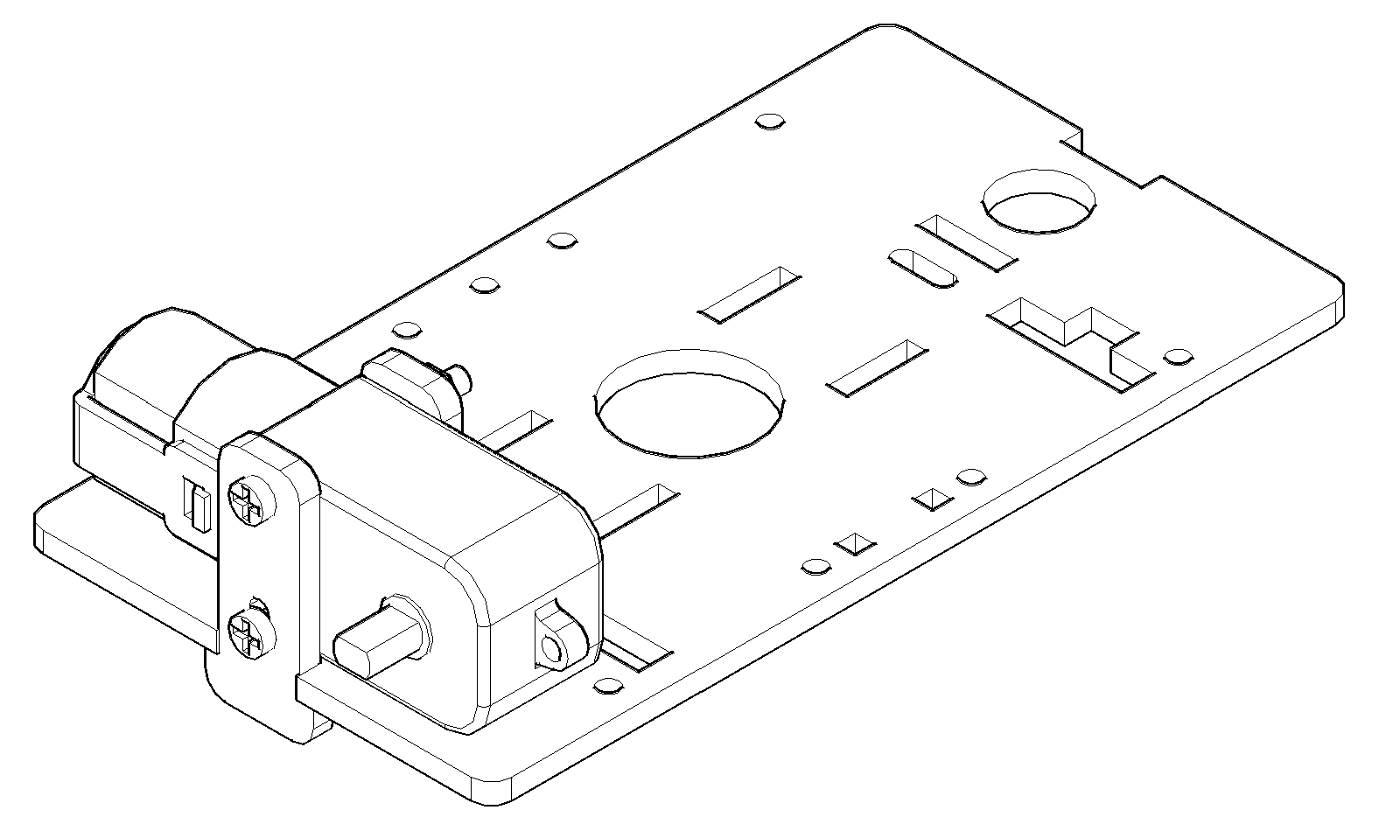
Инструкция/Шаги/Шаг 14!.png
