Ant0Kr/Circuit-design/Инструкция/Шаги/Шаг 15.png

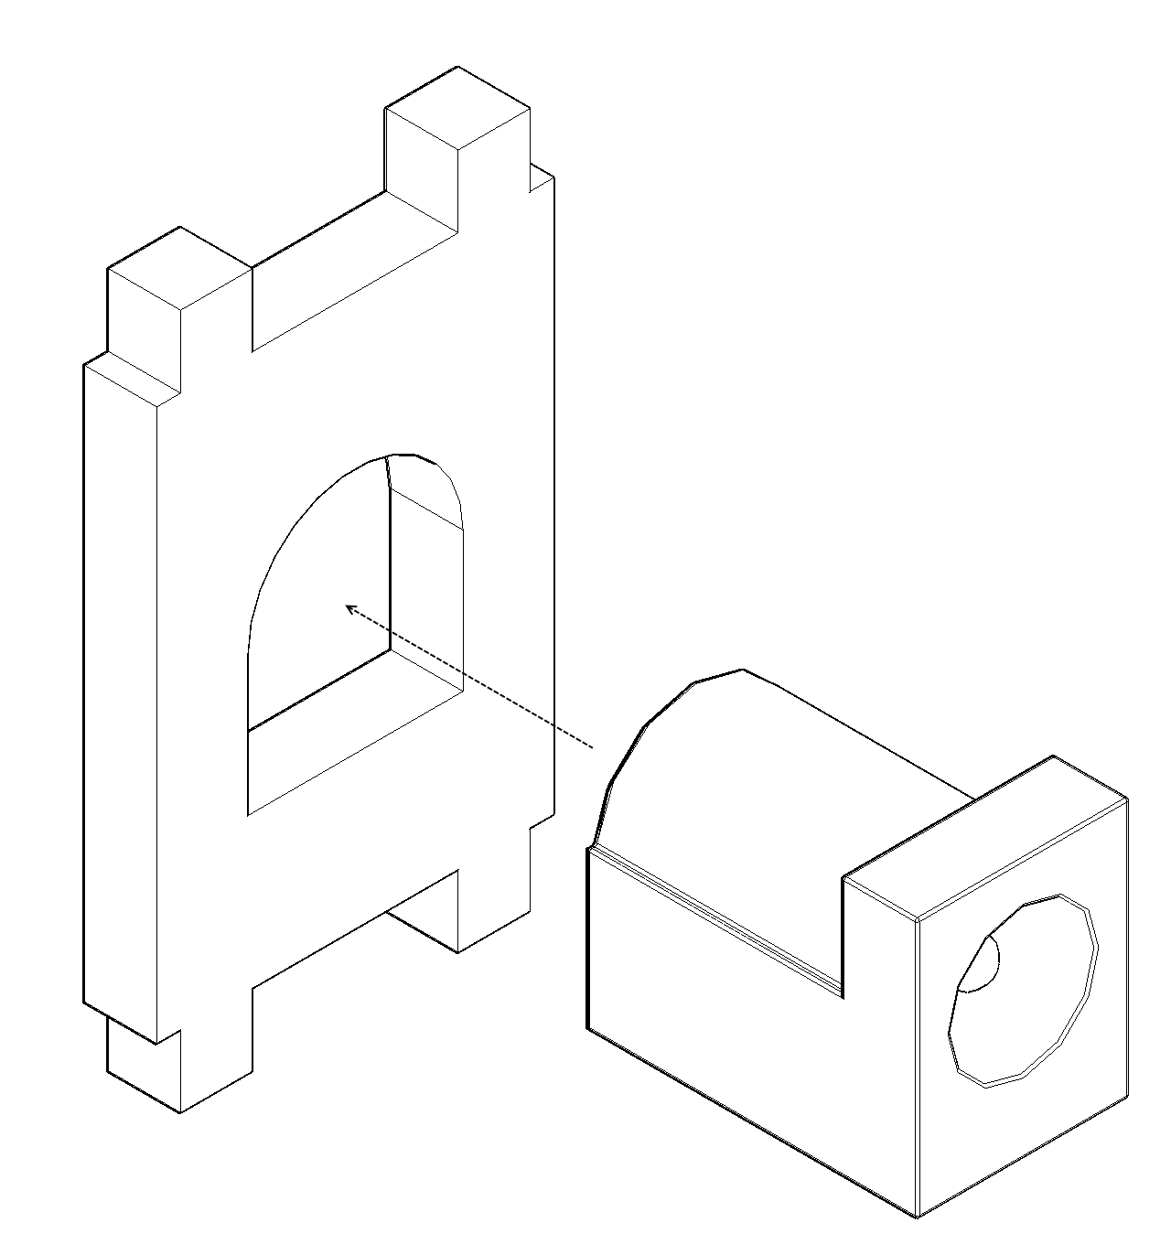
Инструкция/Шаги/Шаг 15.png
