Ant0Kr/Circuit-design/Инструкция/Шаги/Шаг 16!.png

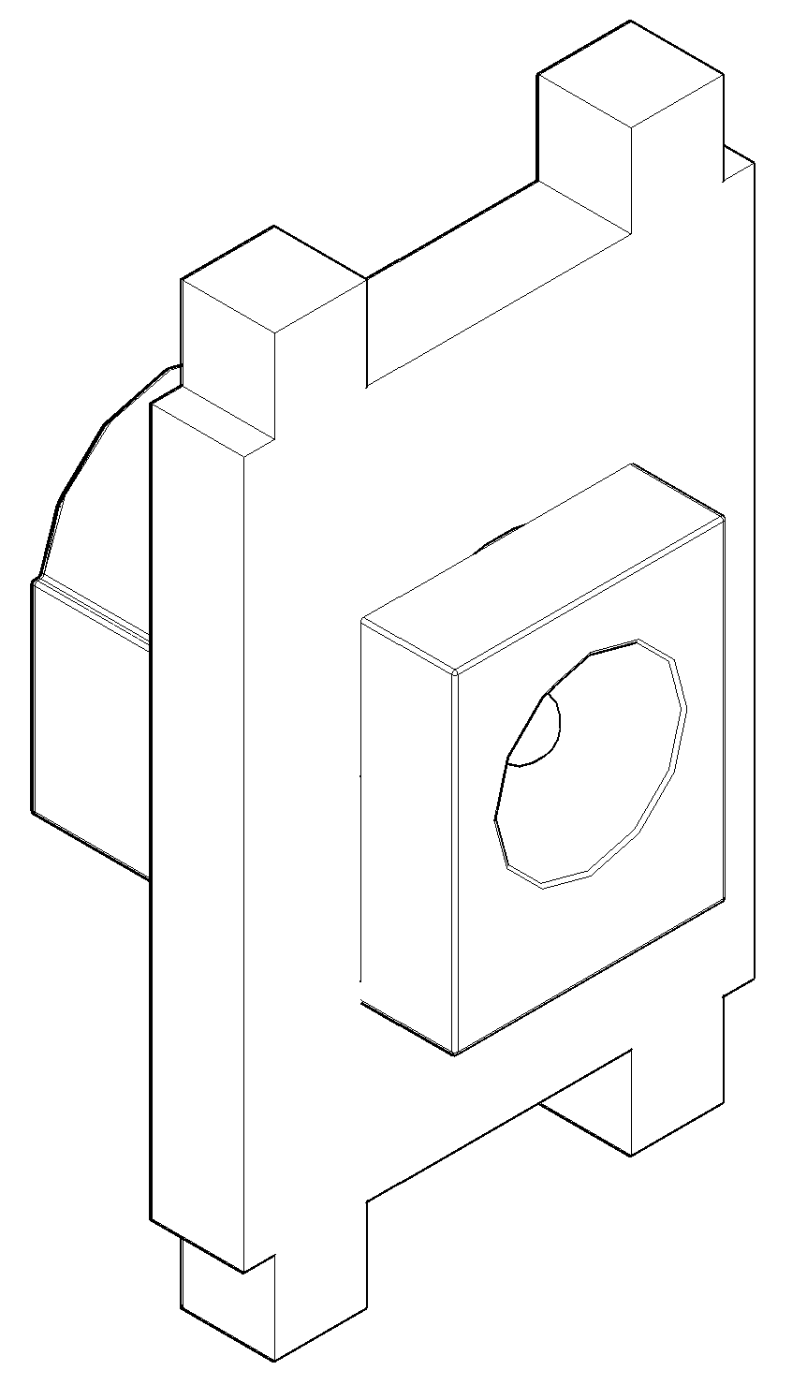
Инструкция/Шаги/Шаг 16!.png
