Ant0Kr/Circuit-design/Инструкция/Шаги/Шаг 17.png

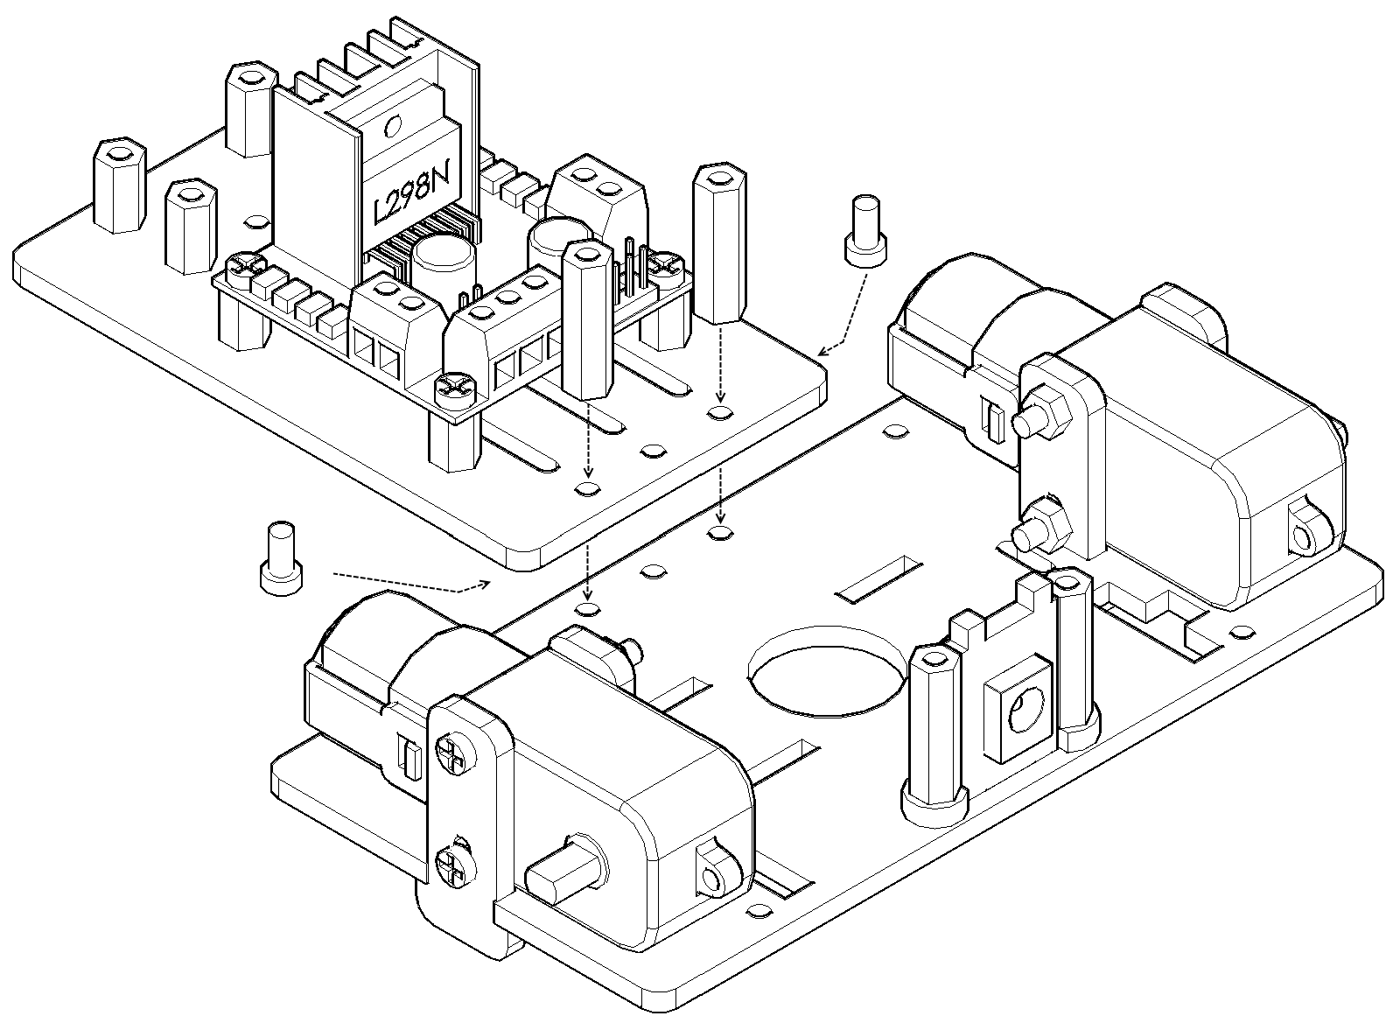
Инструкция/Шаги/Шаг 17.png
