Ant0Kr/Circuit-design/Инструкция/Шаги/Шаг 18!.png

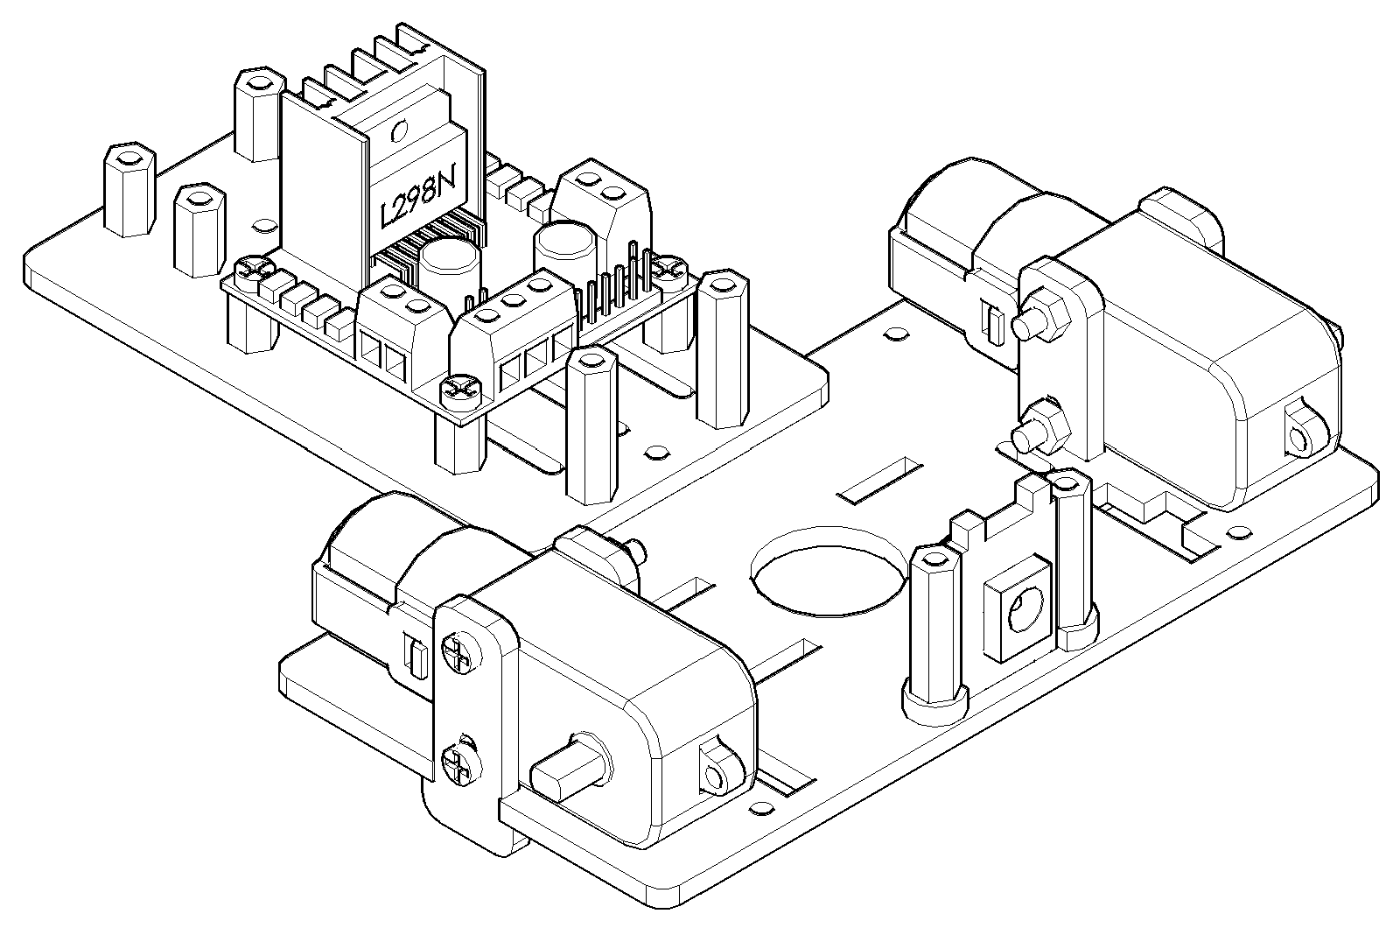
Инструкция/Шаги/Шаг 18!.png
