Ant0Kr/Circuit-design/Инструкция/Шаги/Шаг 19.png

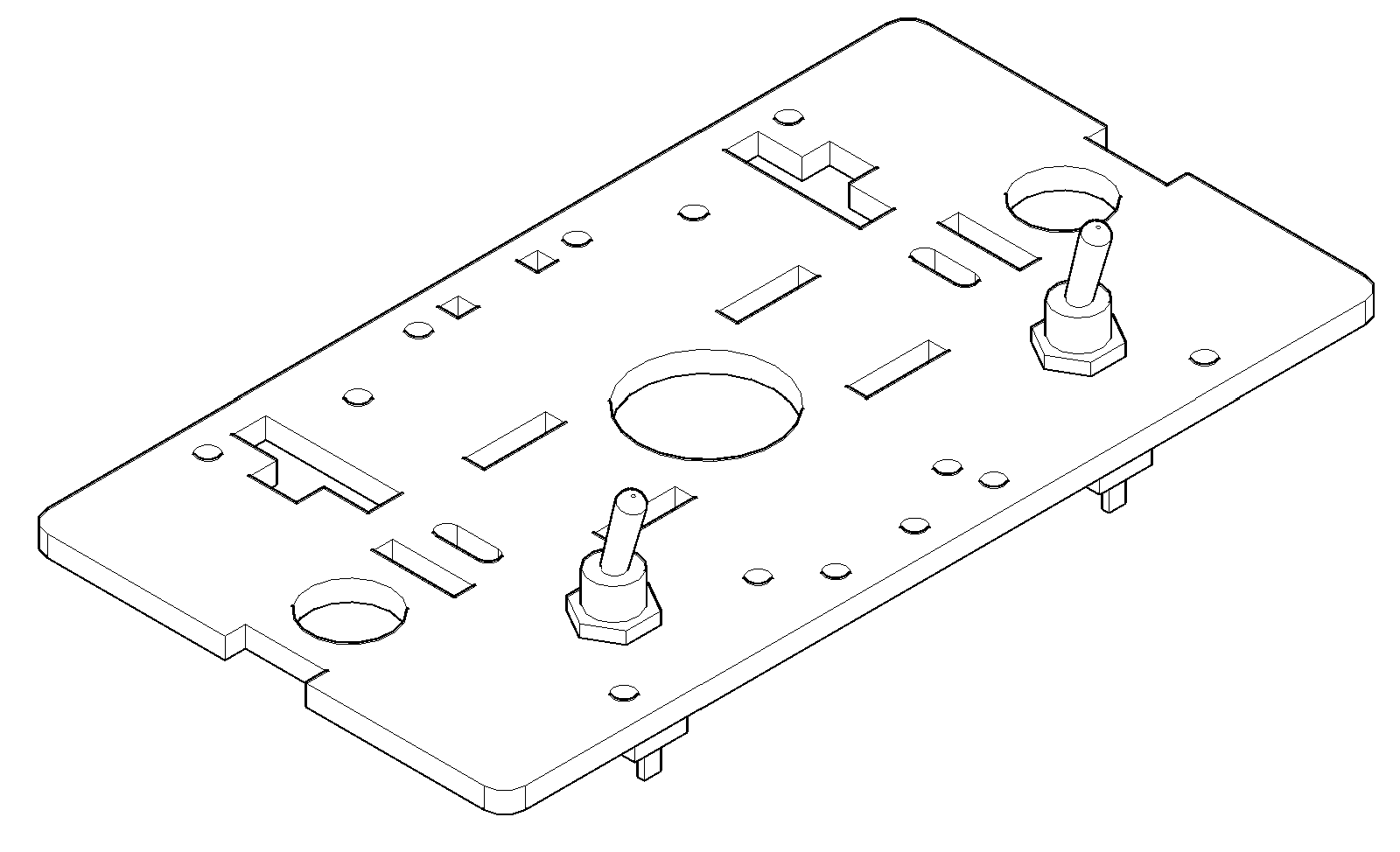
Инструкция/Шаги/Шаг 19.png
