Ant0Kr/Circuit-design/Инструкция/Шаги/Шаг 21.png

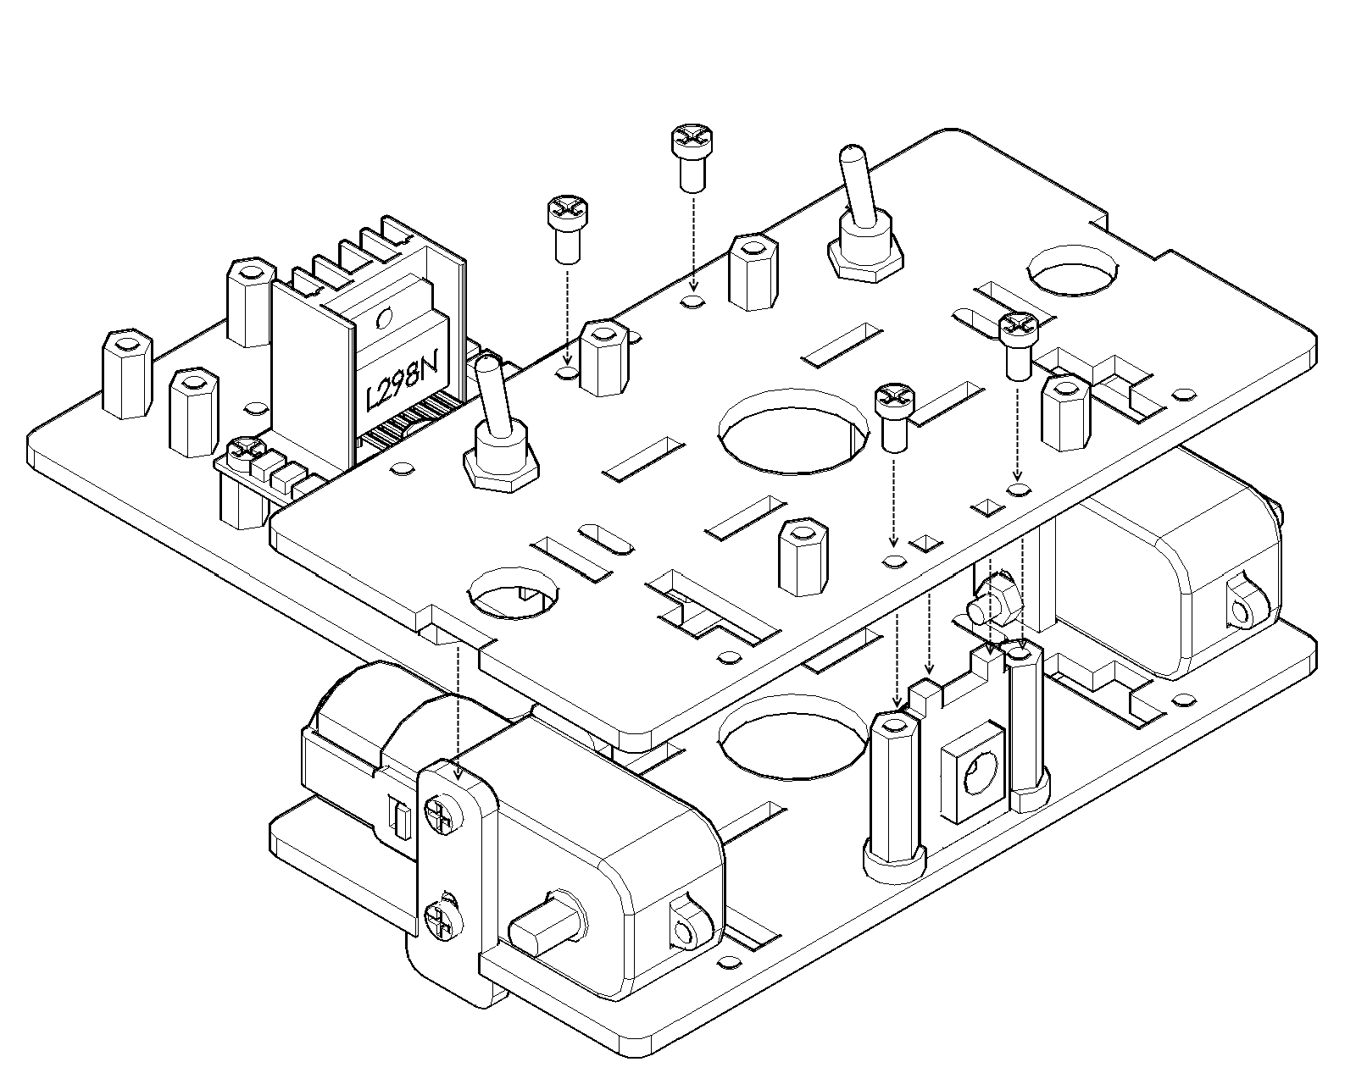
Инструкция/Шаги/Шаг 21.png
