Ant0Kr/Circuit-design/Инструкция/Шаги/Шаг 22!.png

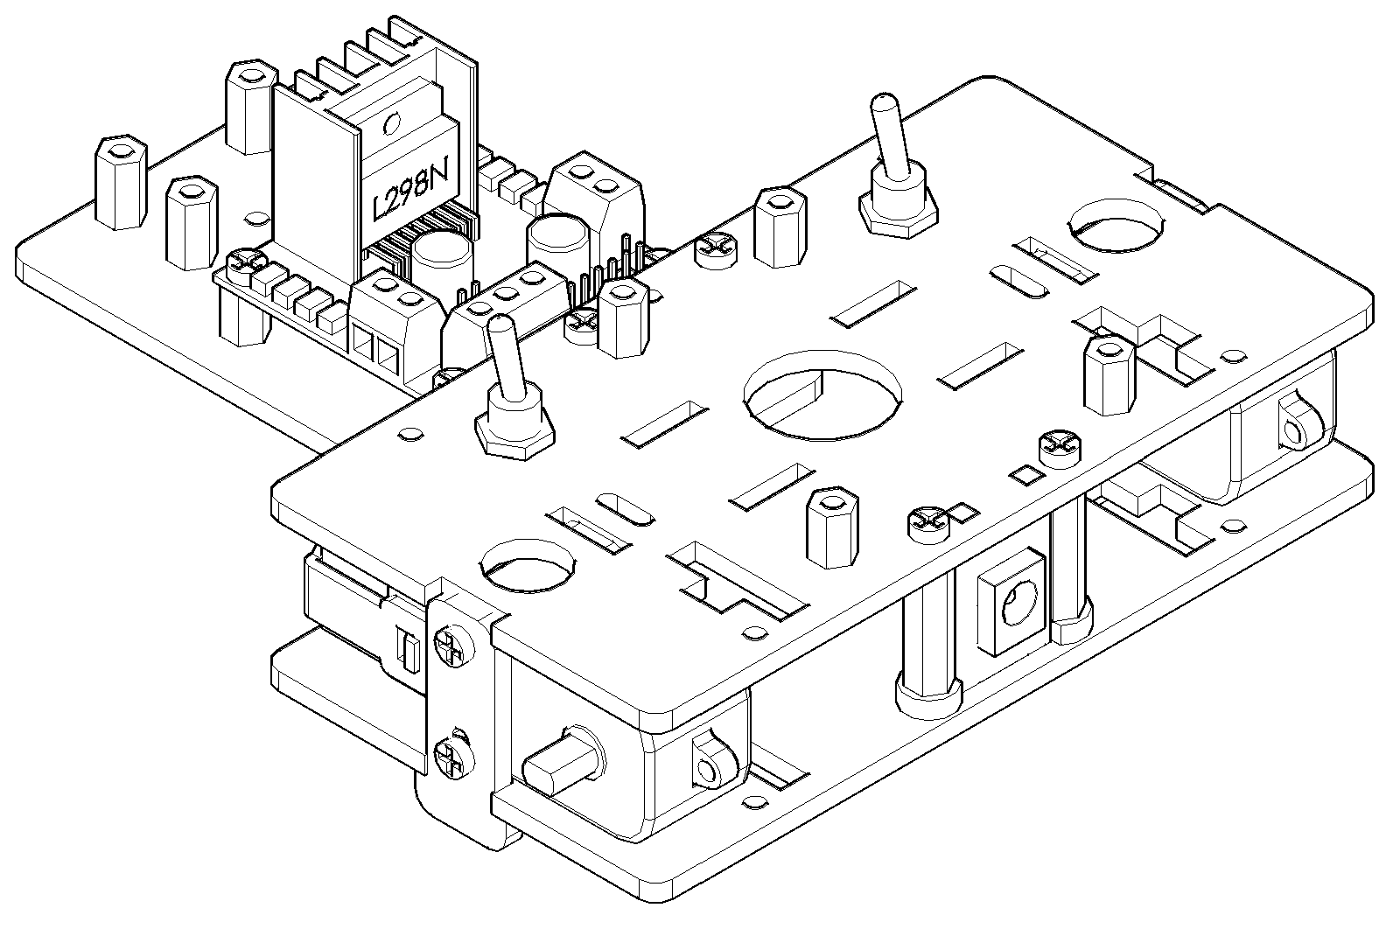
Инструкция/Шаги/Шаг 22!.png
