Ant0Kr/Circuit-design/Инструкция/Шаги/Шаг 23.png

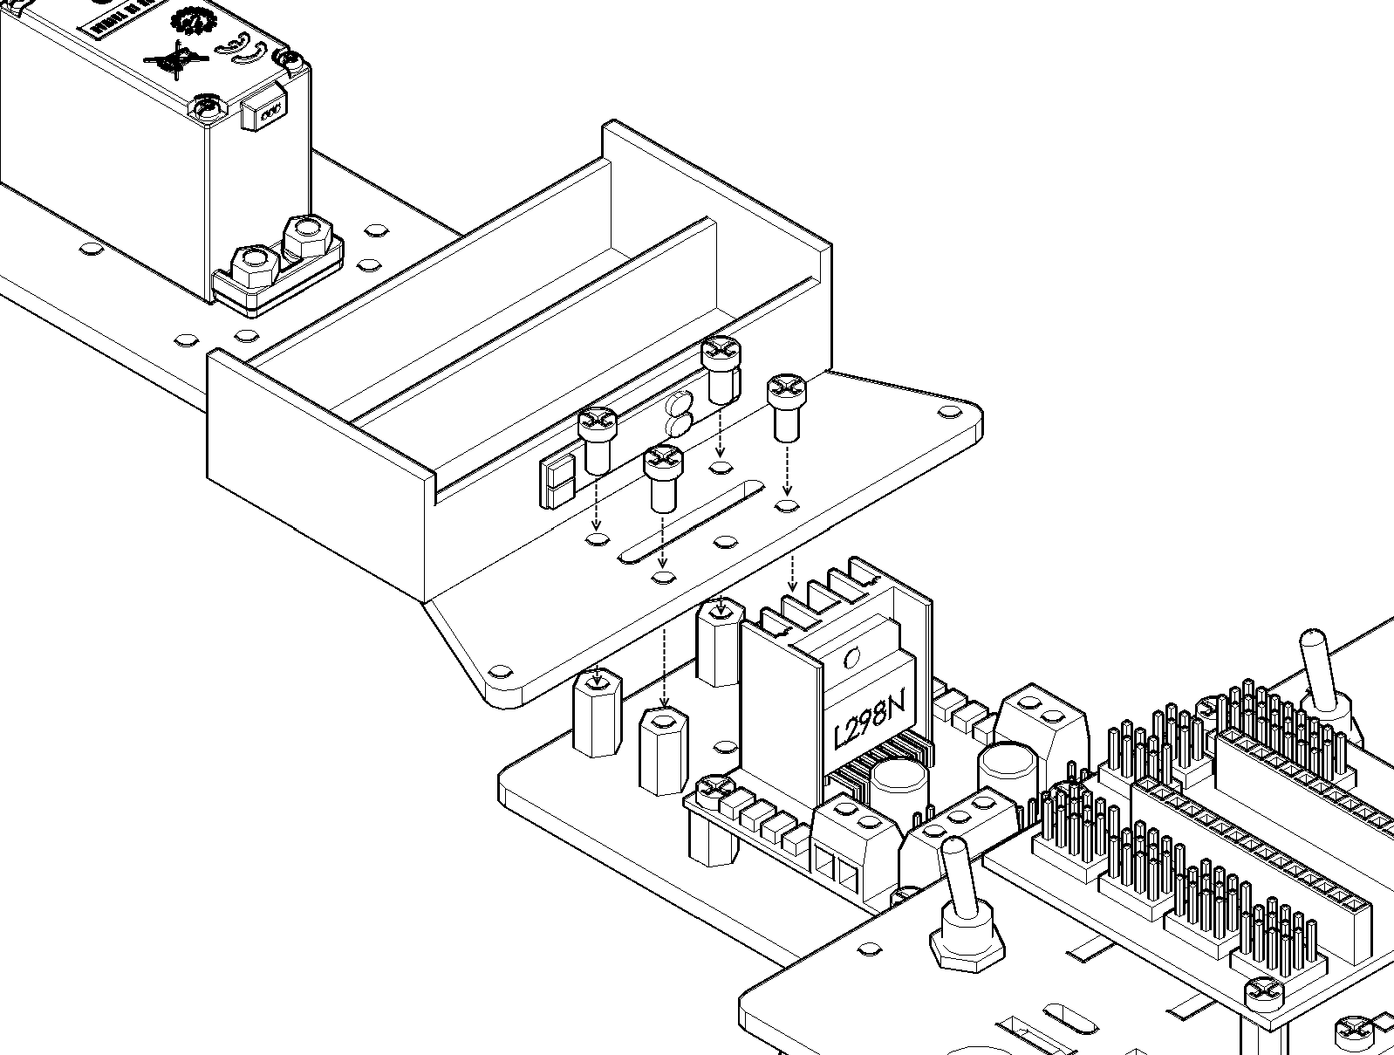
Инструкция/Шаги/Шаг 23.png
