Ant0Kr/Circuit-design/Инструкция/Шаги/Шаг 24!.png

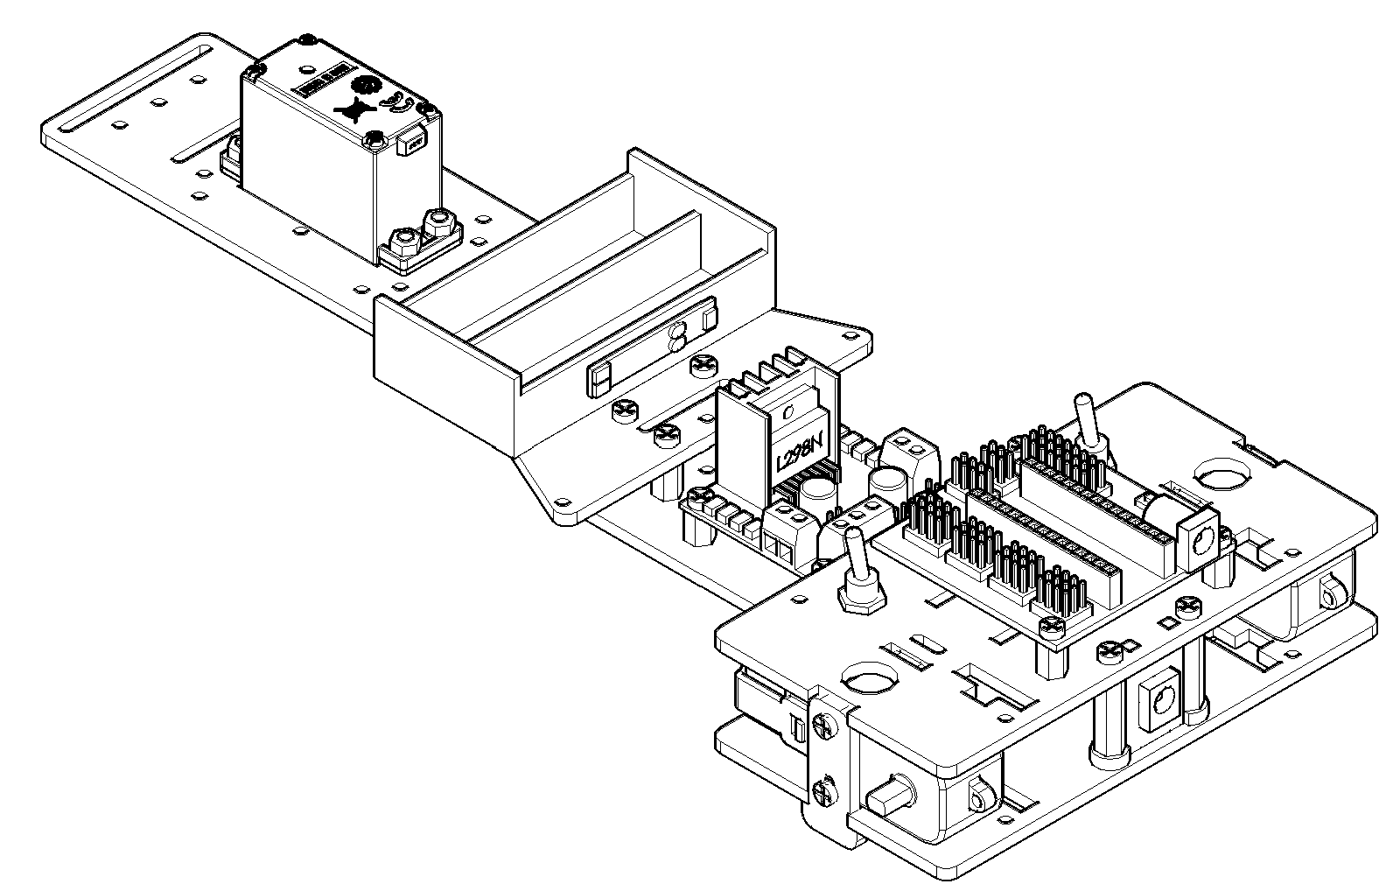
Инструкция/Шаги/Шаг 24!.png
