Ant0Kr/Circuit-design/Инструкция/Шаги/Шаг 25.png

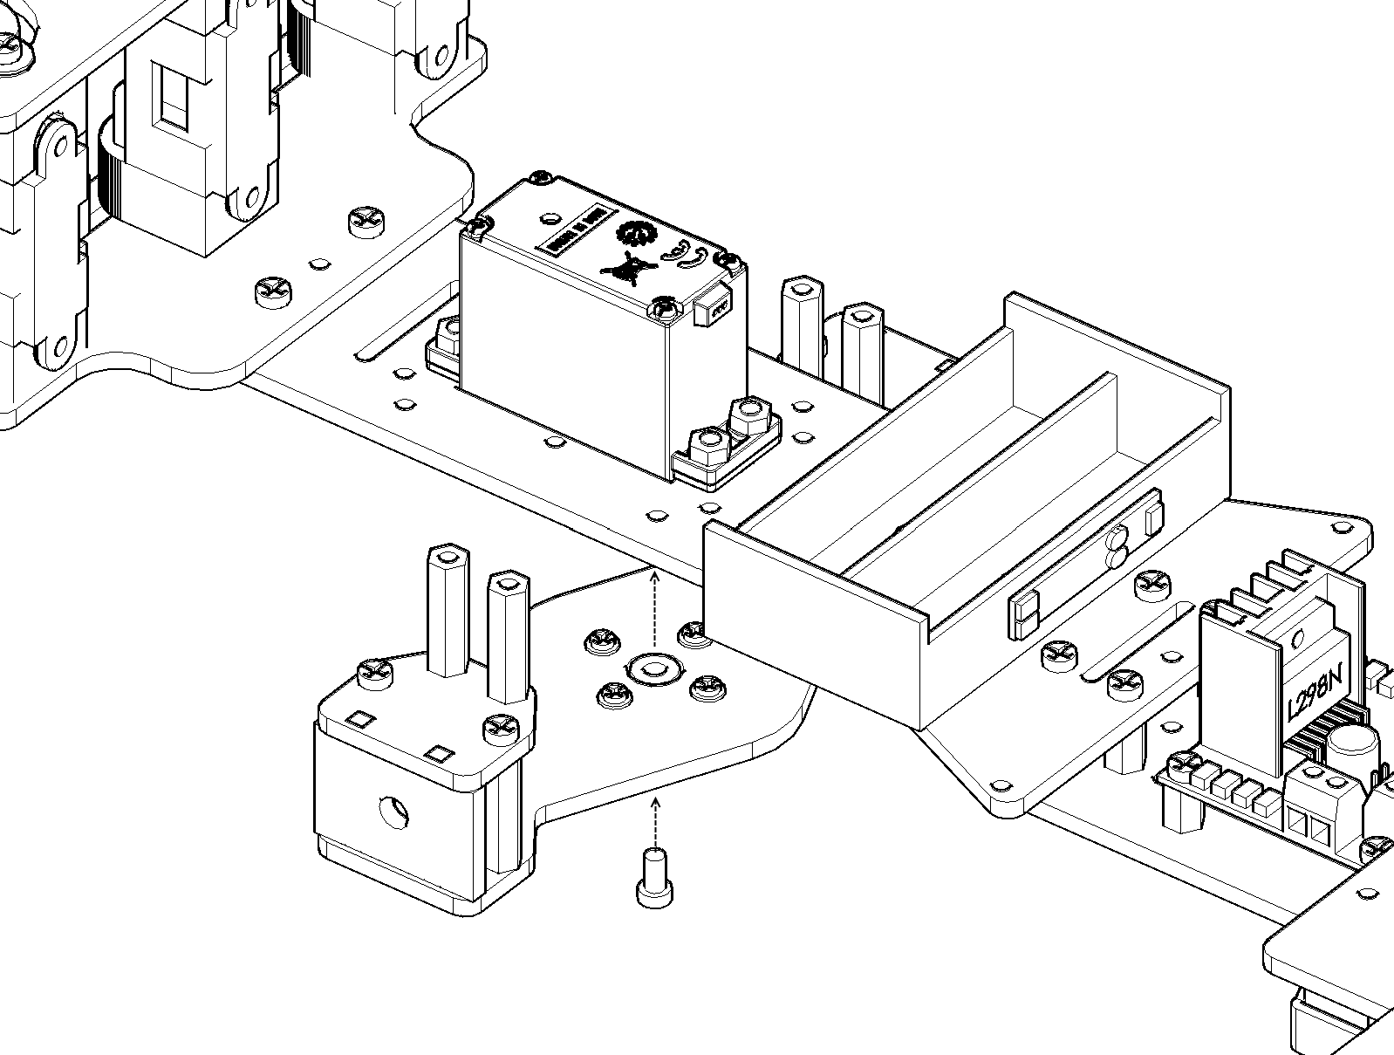
Инструкция/Шаги/Шаг 25.png
