Ant0Kr/Circuit-design/Инструкция/Шаги/Шаг 26!.png

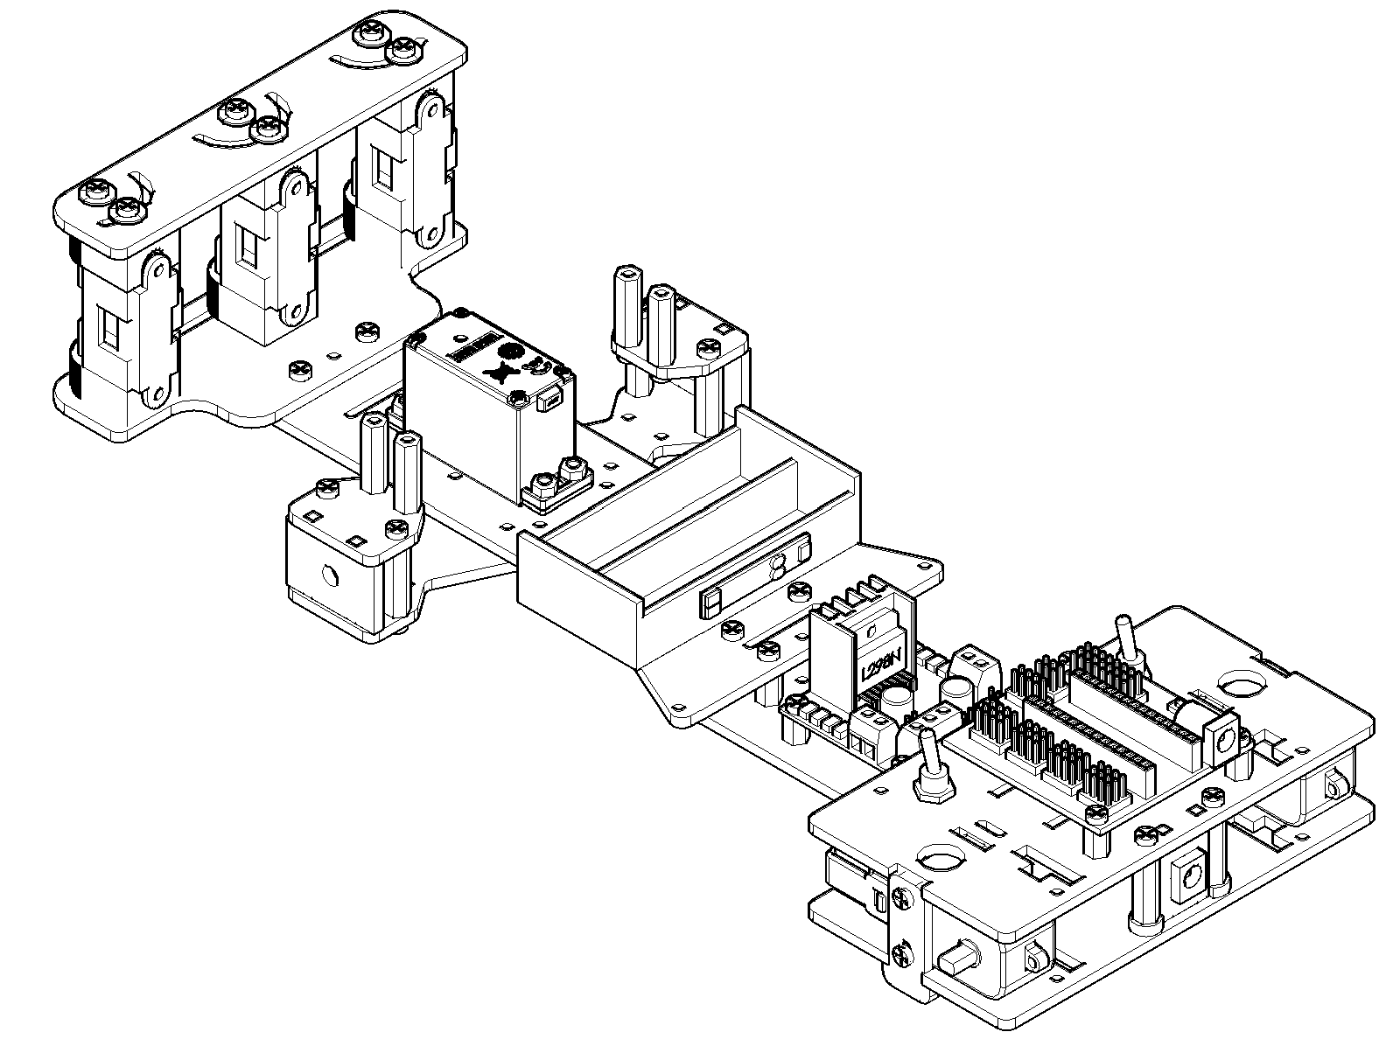
Инструкция/Шаги/Шаг 26!.png
