Ant0Kr/Circuit-design/Инструкция/Шаги/Шаг 27.png

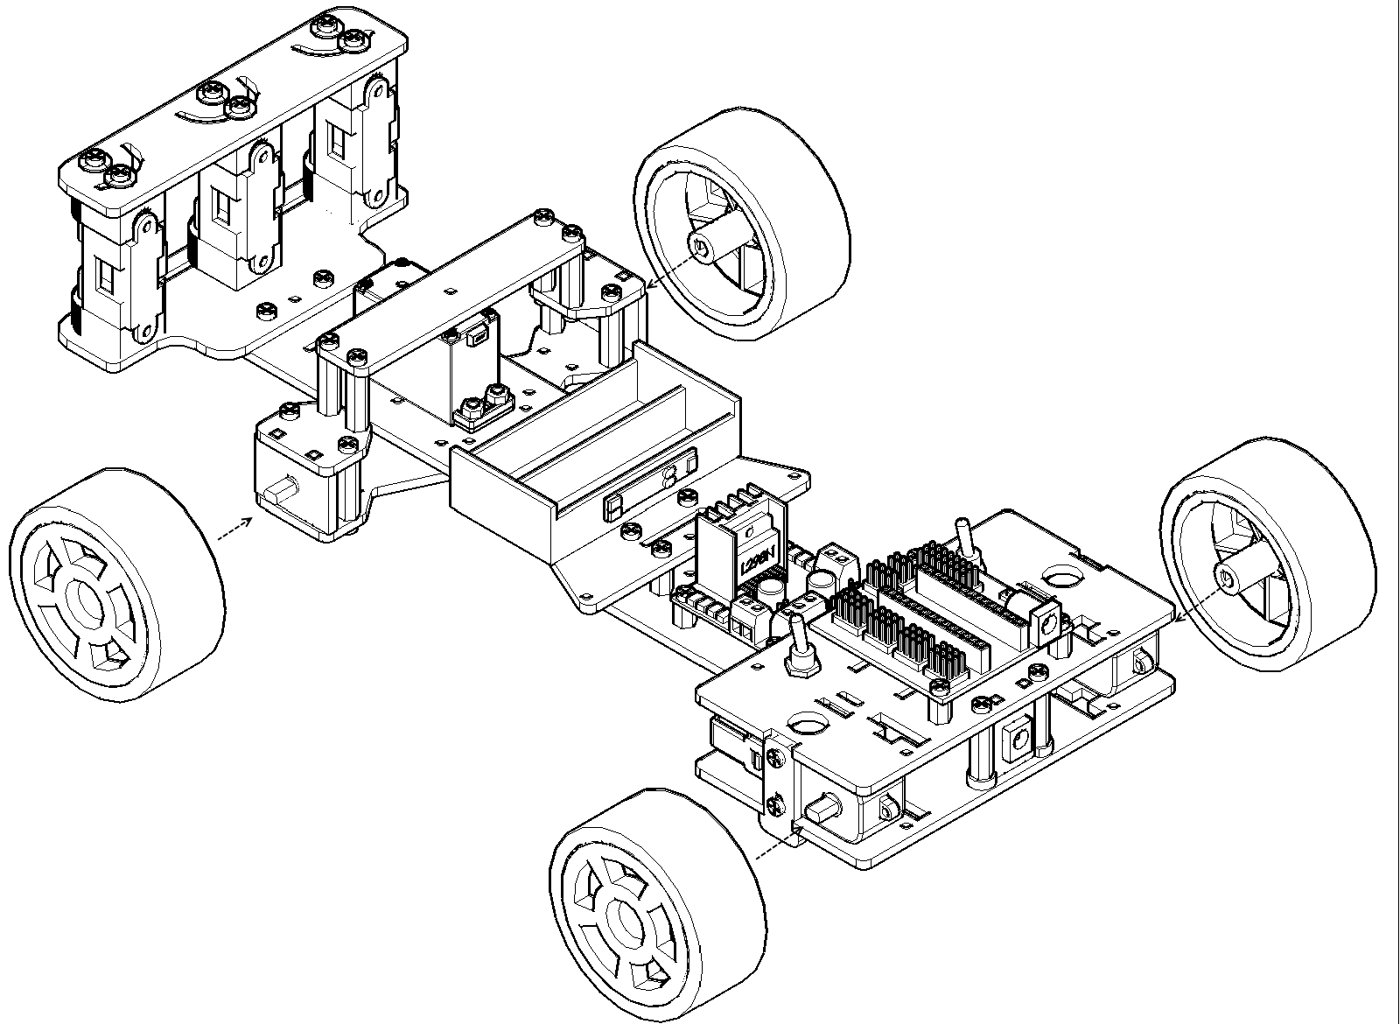
Инструкция/Шаги/Шаг 27.png
