Ant0Kr/Circuit-design/Инструкция/Шаги/Шаг 29.png

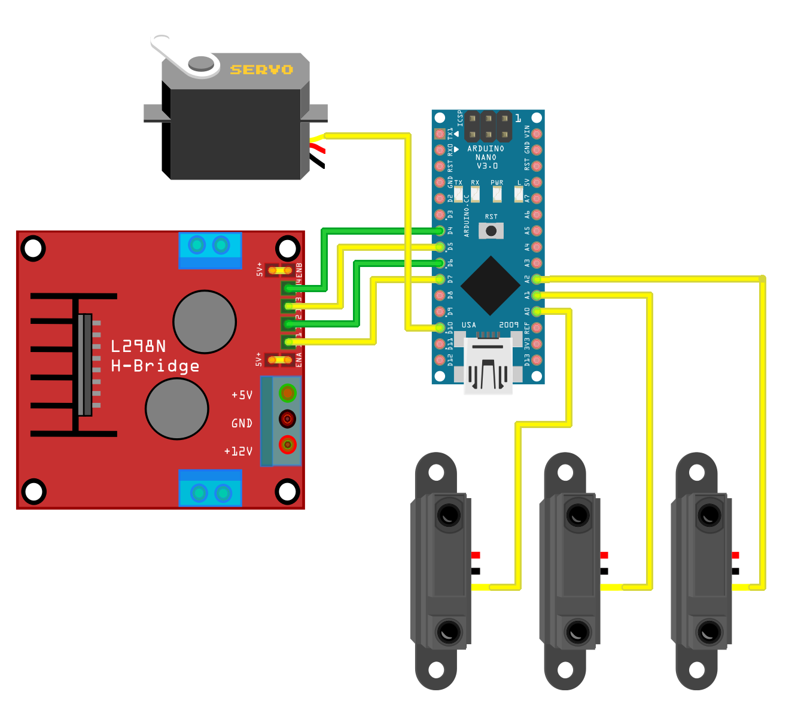
Инструкция/Шаги/Шаг 29.png
