Ant0Kr/Circuit-design/Чертежи/3D/Аккумулятор/аккумулятор.stl

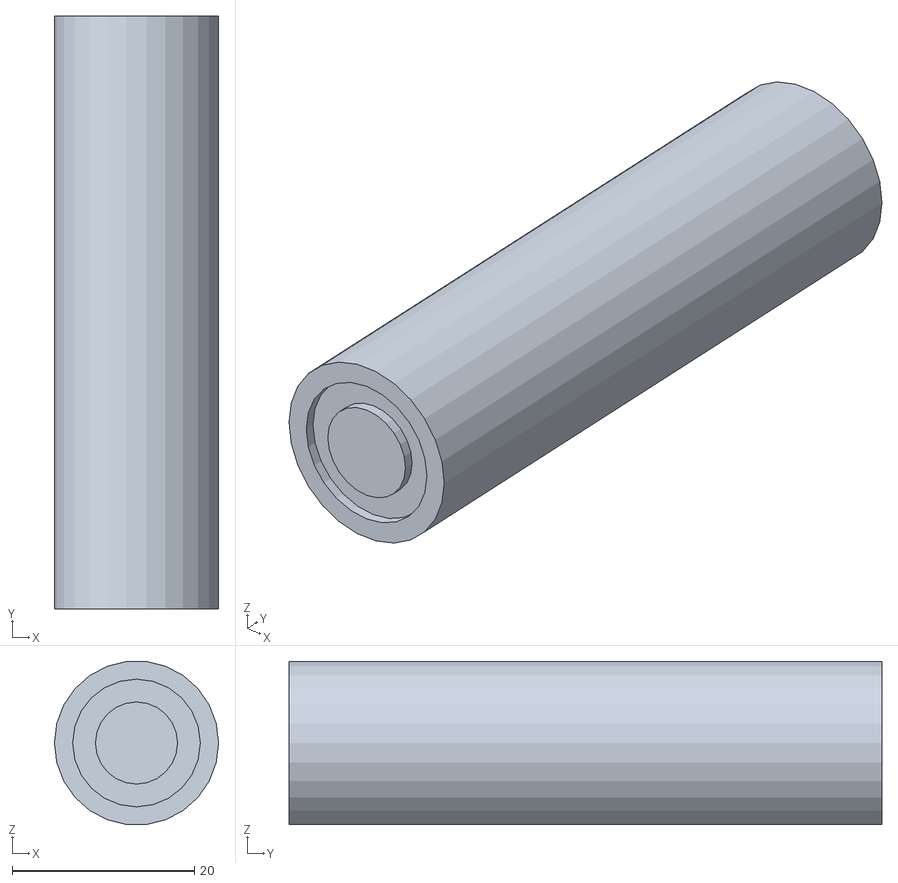
[picture p138: CAD file, 2017-10-29]
Чертежи/3D/Аккумулятор/аккумулятор.stl
18.0 x 65.0 x 17.9
