Ant0Kr/Circuit-design/Чертежи/3D/Батарейный отсек/отсек.stl

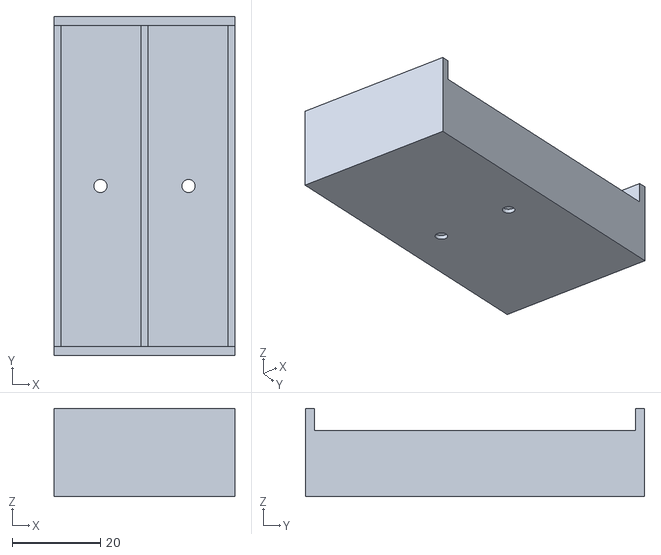
[picture p139: CAD file, 2017-10-30]
Чертежи/3D/Батарейный отсек/отсек.stl
41.0 x 77.0 x 20.0
