Ant0Kr/Circuit-design/Чертежи/3D/Винты/винты.stl

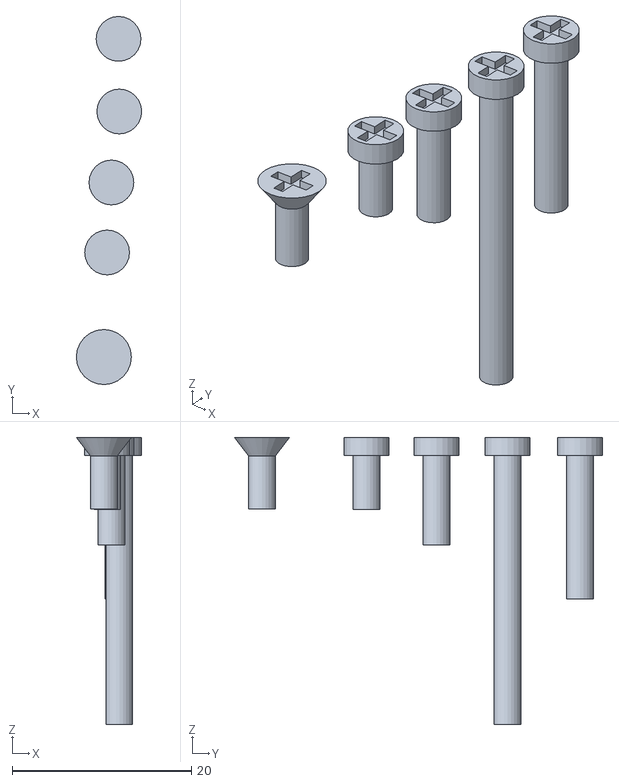
[picture p140: CAD file, 2017-10-29]
Чертежи/3D/Винты/винты.stl
7.29 x 41.0 x 32.0
