Ant0Kr/Circuit-design/Чертежи/3D/Гайка/гайка.stl

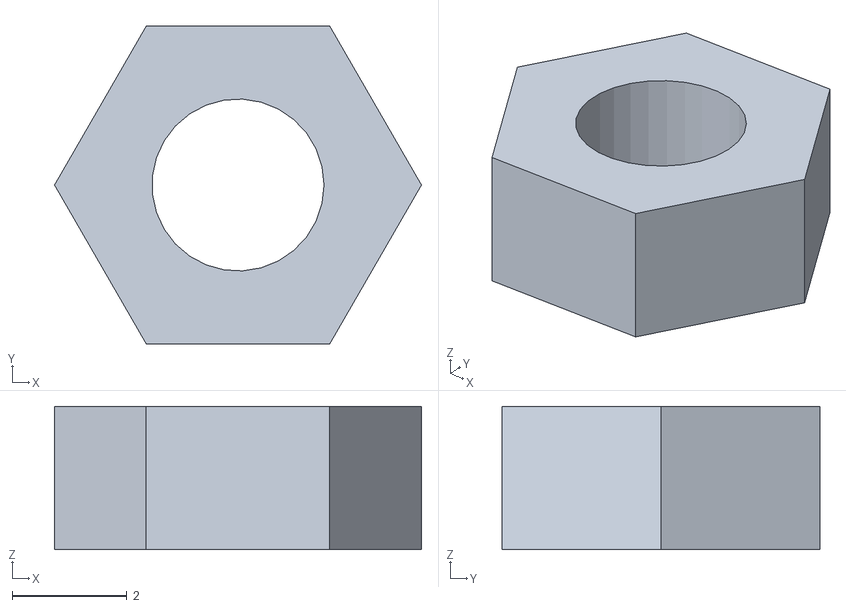
[picture p141: CAD file, 2017-10-29]
Чертежи/3D/Гайка/гайка.stl
6.40 x 5.54 x 2.50
