Ant0Kr/Circuit-design/Чертежи/3D/Датчик ИК/Sensor.stl

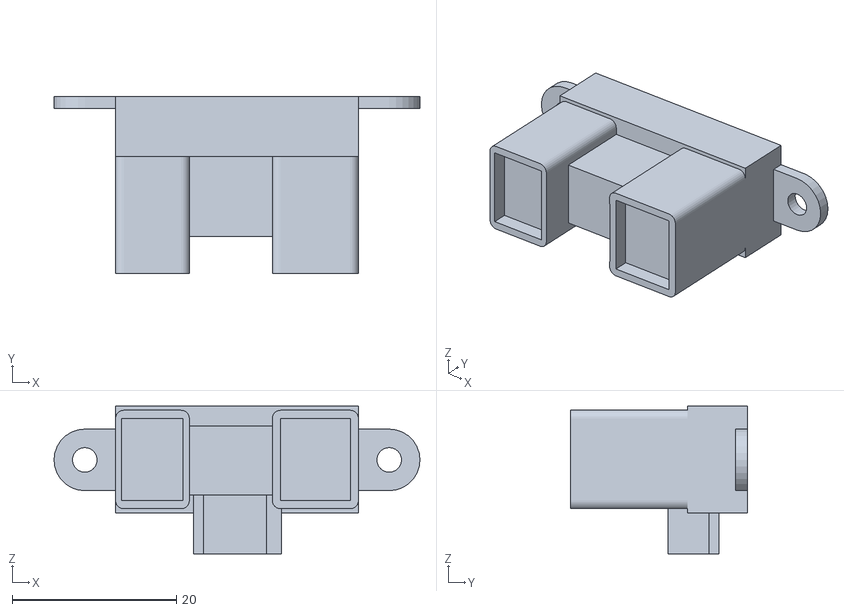
[picture p142: CAD file, 2017-10-29]
Чертежи/3D/Датчик ИК/Sensor.stl
44.6 x 21.6 x 18.0
