Ant0Kr/Circuit-design/Чертежи/3D/Двигатель с редуктором/motor.stl

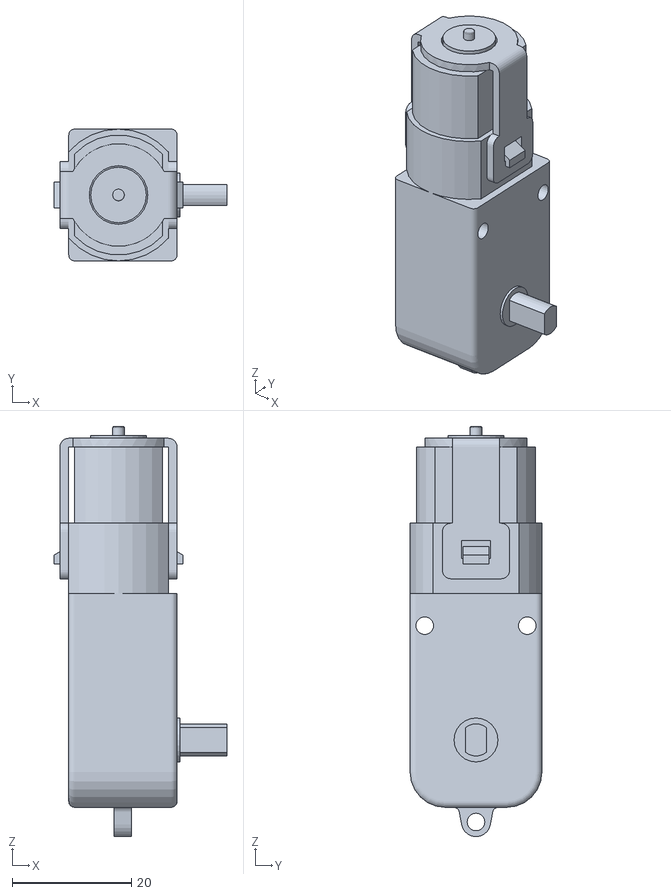
[picture p143: CAD file, 2017-10-29]
Чертежи/3D/Двигатель с редуктором/motor.stl
29.0 x 22.1 x 68.9
