Ant0Kr/Circuit-design/Чертежи/3D/Колесо/колесо.stl

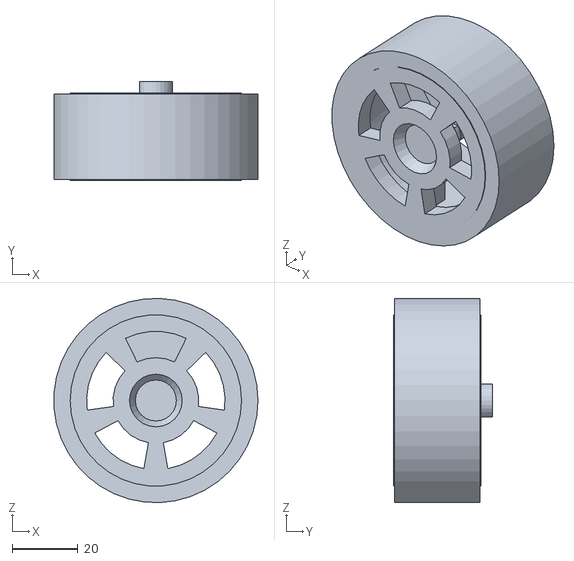
[picture p144: CAD file, 2017-10-29]
Чертежи/3D/Колесо/колесо.stl
61.9 x 30.0 x 62.0
