Ant0Kr/Circuit-design/Чертежи/3D/Контроллер двигателей/l298n.stl

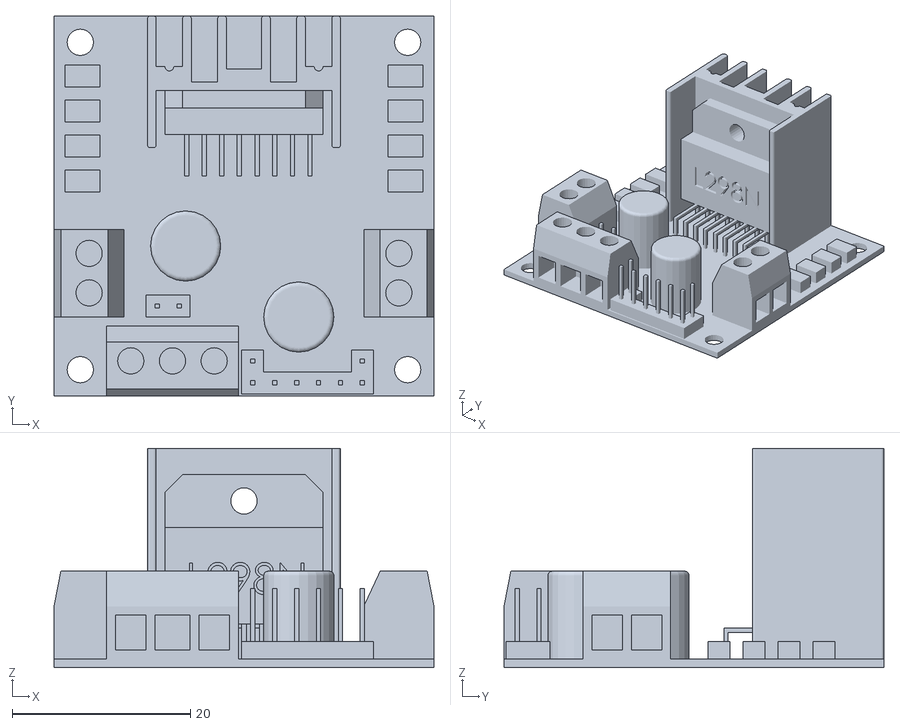
[picture p145: CAD file, 2017-10-29]
Чертежи/3D/Контроллер двигателей/l298n.stl
42.6 x 42.6 x 24.6
