Ant0Kr/Circuit-design/Чертежи/3D/Корпус для ИК датчика/korpus_IK_datchika.STL

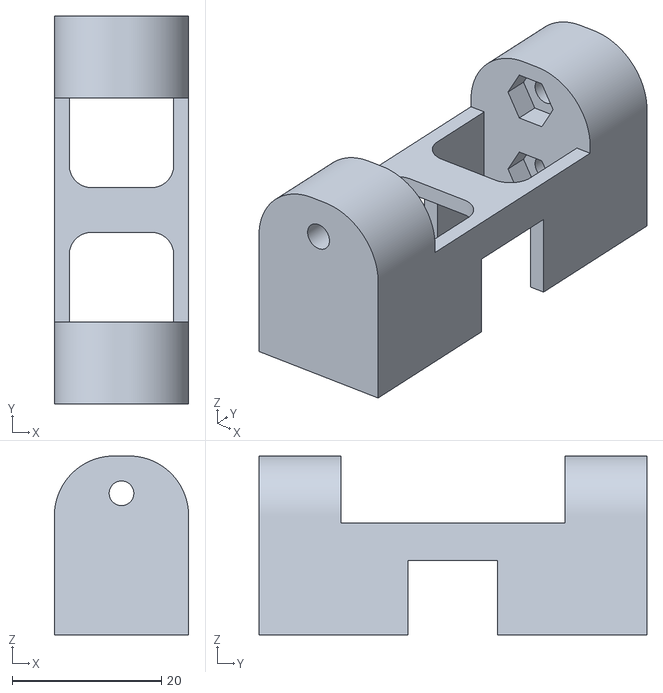
[picture p146: CAD file, 2017-10-01]
Чертежи/3D/Корпус для ИК датчика/korpus_IK_datchika.STL
18.0 x 52.0 x 24.0
