Ant0Kr/Circuit-design/Чертежи/3D/Корпус робота/корпус.stl

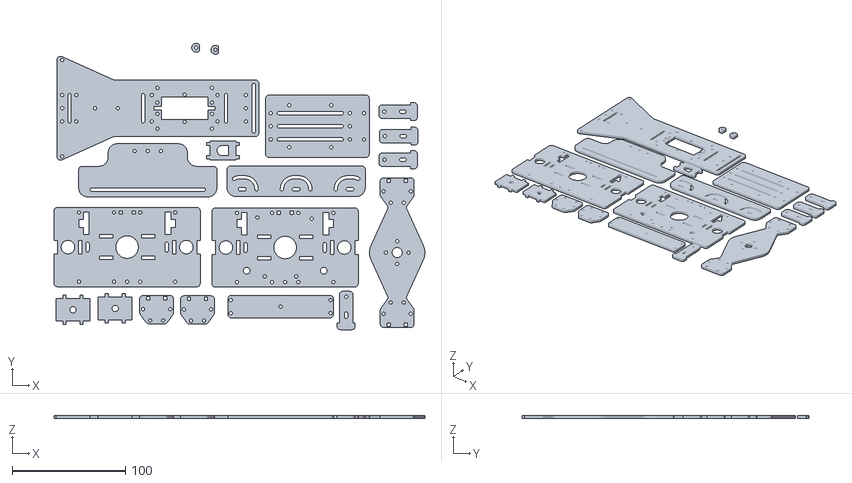
[picture p147: CAD file, 2017-10-29]
Чертежи/3D/Корпус робота/корпус.stl
327.2 x 252.7 x 3.00
