Ant0Kr/Circuit-design/Чертежи/3D/Крестовина/крестовина.stl

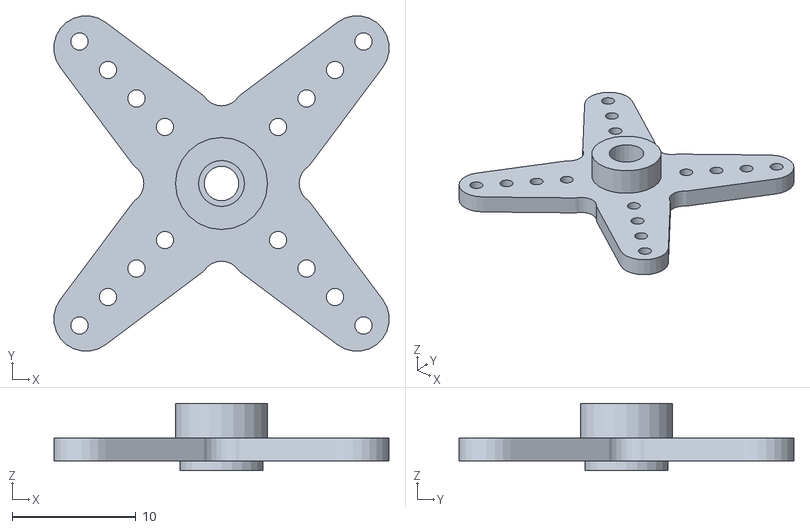
[picture p148: CAD file, 2017-10-30]
Чертежи/3D/Крестовина/крестовина.stl
27.0 x 27.0 x 5.44
