Ant0Kr/Circuit-design/Чертежи/3D/Модуль расширения ардуино/board.stl

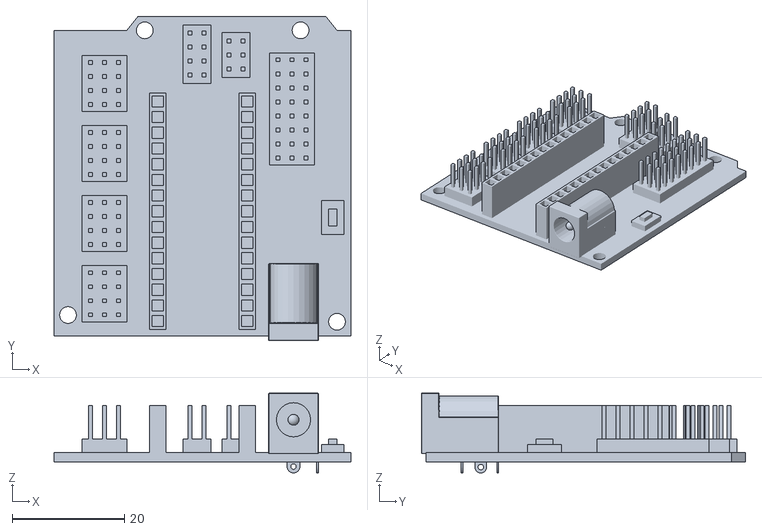
[picture p149: CAD file, 2017-10-29]
Чертежи/3D/Модуль расширения ардуино/board.stl
53.0 x 57.9 x 14.3
