Ant0Kr/Circuit-design/Чертежи/3D/Разъем питания/разъем питания.stl

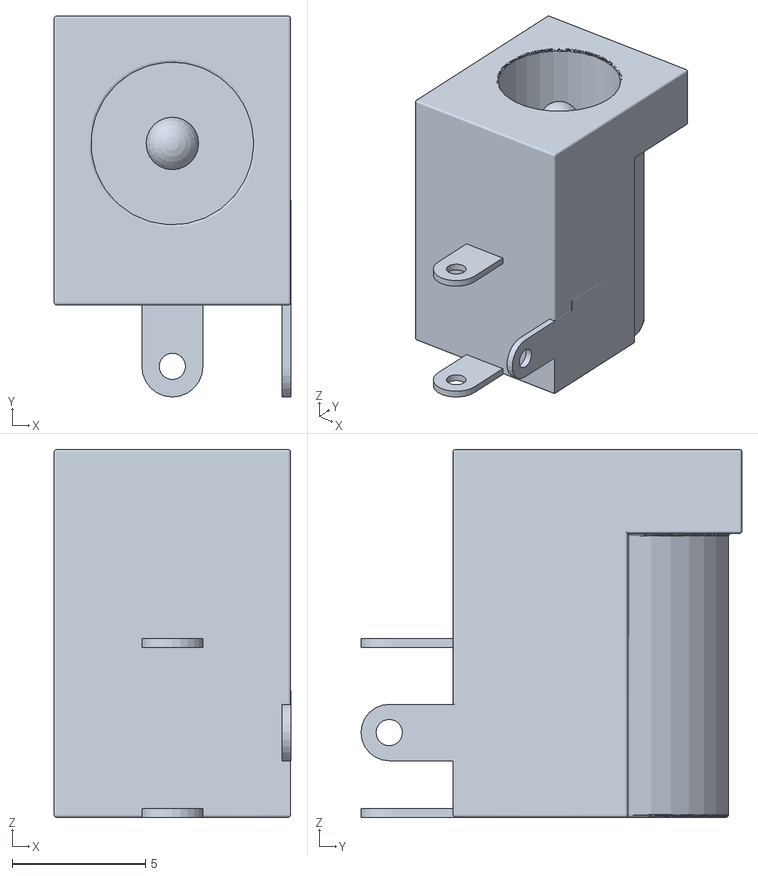
[picture p150: CAD file, 2017-10-29]
Чертежи/3D/Разъем питания/разъем питания.stl
8.87 x 14.3 x 13.8
