Ant0Kr/Circuit-design/Чертежи/3D/Сервопривод/futaba s3003.stl

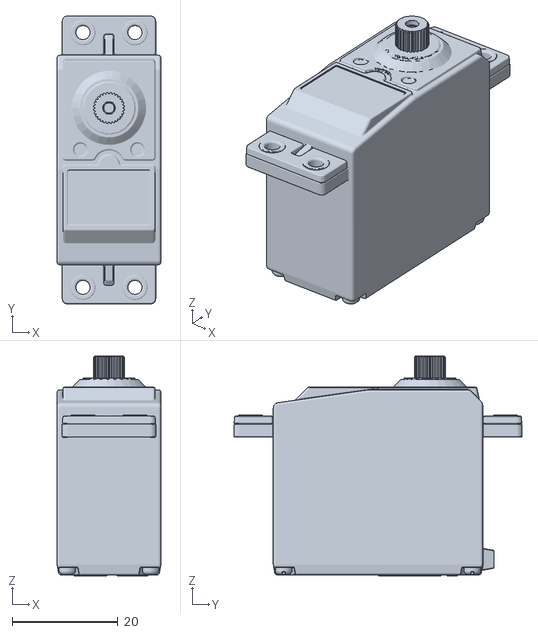
[picture p151: CAD file, 2017-10-29]
Чертежи/3D/Сервопривод/futaba s3003.stl
19.7 x 54.5 x 41.6
