Ant0Kr/Circuit-design/Чертежи/3D/Стойки/стойки.stl

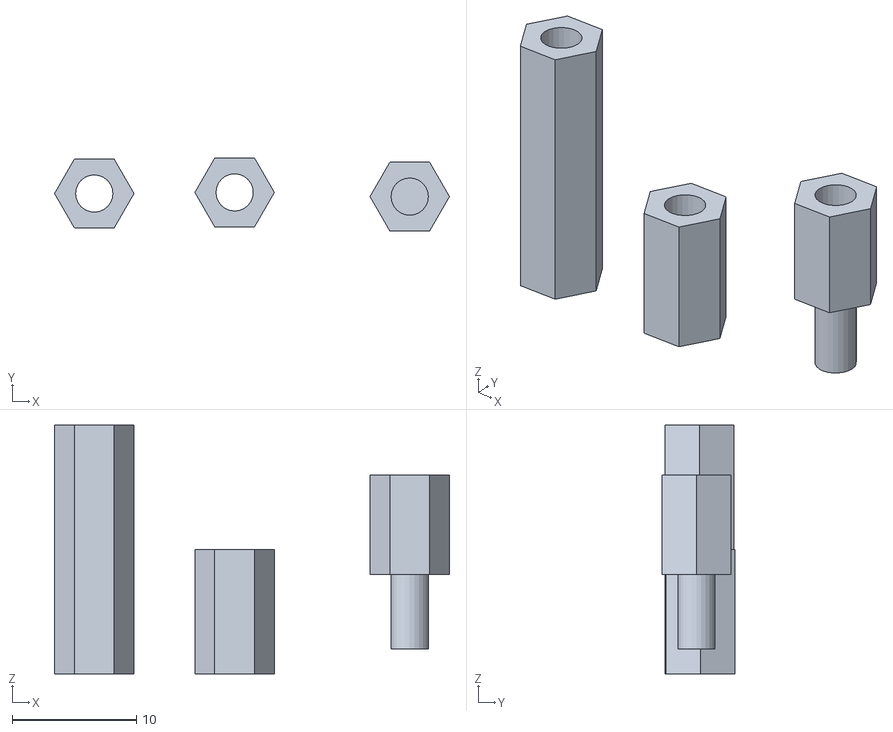
[picture p152: CAD file, 2017-10-29]
Чертежи/3D/Стойки/стойки.stl
31.8 x 5.88 x 20.0
