Ant0Kr/Circuit-design/Чертежи/3D/Тумблер/тумблер.stl

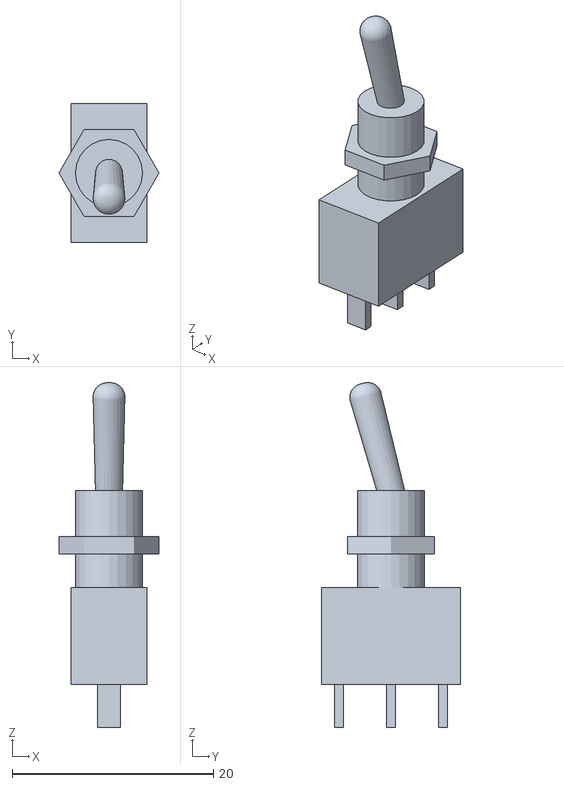
[picture p153: CAD file, 2017-10-29]
Чертежи/3D/Тумблер/тумблер.stl
9.94 x 13.8 x 34.3
