Ant0Kr/Circuit-design/Чертежи/3D/Шайба/шайба.stl

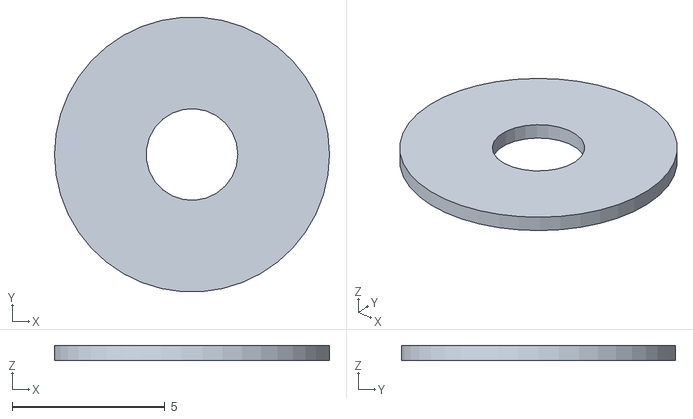
[picture p154: CAD file, 2017-10-29]
Чертежи/3D/Шайба/шайба.stl
9.00 x 8.97 x 0.5
