Ant0Kr/Circuit-design/Чертежи/3D/Ступица передних колес/stupica.STL

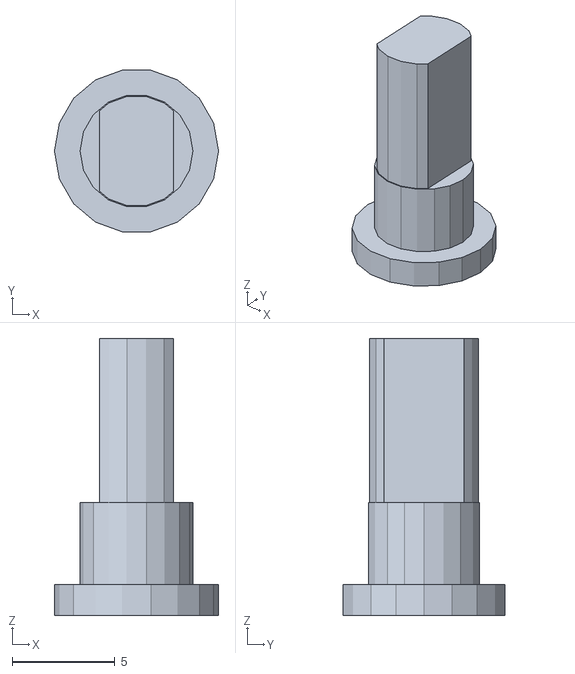
[picture p155: CAD file, 2017-10-01]
Чертежи/3D/Ступица передних колес/stupica.STL
8.00 x 7.88 x 13.5
