Ant0Kr/Circuit-design/(list of files, cad)

Other CAD files:
Чертежи/2D/робот.dwg
Чертежи/3D/Ардуино нано/nano.dwg
Чертежи/3D/Контроллер заряда/Контроллер заряда.dwg
Чертежи/3D/Провод/Провод.dwg
Чертежи/3D/Разъемы/Разъемы.dwg
Чертежи/3D/Ступица передних колес/ступица.dwg
Чертежи/3D/Штекер питания/Штекер питания.dwg
Чертежи/3D/Аккумулятор/аккумулятор.dwg
Чертежи/3D/Батарейный отсек/отсек.dwg
Чертежи/3D/Винты/винты.dwg
Чертежи/3D/Гайка/гайка.dwg
Чертежи/3D/Датчик ИК/Sensor.dwg
Чертежи/3D/Двигатель с редуктором/motor.dwg
Чертежи/3D/Колесо/колесо.dwg
Чертежи/3D/Контроллер двигателей/l298n.dwg
Чертежи/3D/Корпус для ИК датчика/korpus_IK_datchika.DWG
Чертежи/3D/Корпус робота/корпус.dwg
Чертежи/3D/Крестовина/крестовина.dwg
Чертежи/3D/Модуль расширения ардуино/board.dwg
Чертежи/3D/Разъем питания/разъем питания.dwg
Чертежи/3D/Сервопривод/futaba s3003.dwg
Чертежи/3D/Стойки/стойки.dwg
Чертежи/3D/Тумблер/тумблер.dwg
Чертежи/3D/Шайба/шайба.dwg
