Ant0Kr/Circuit-design/Чертежи/2D/робот.pdf

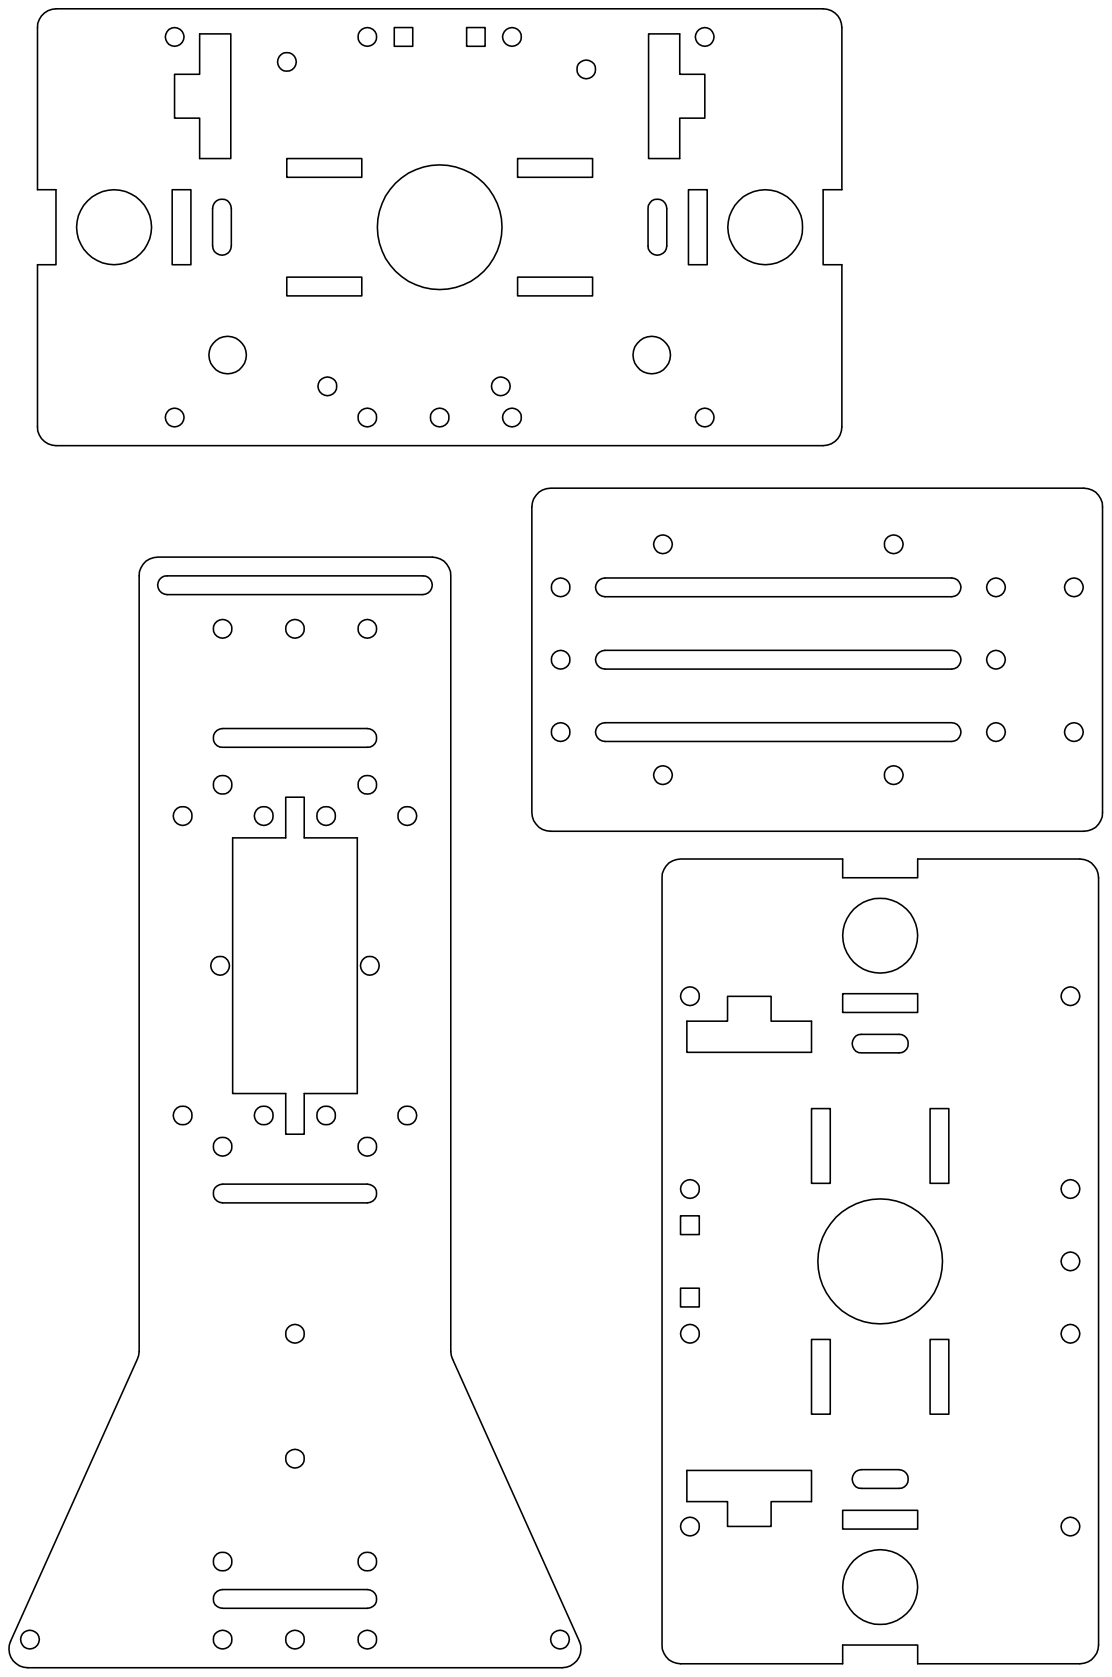
[picture p156: page 1]

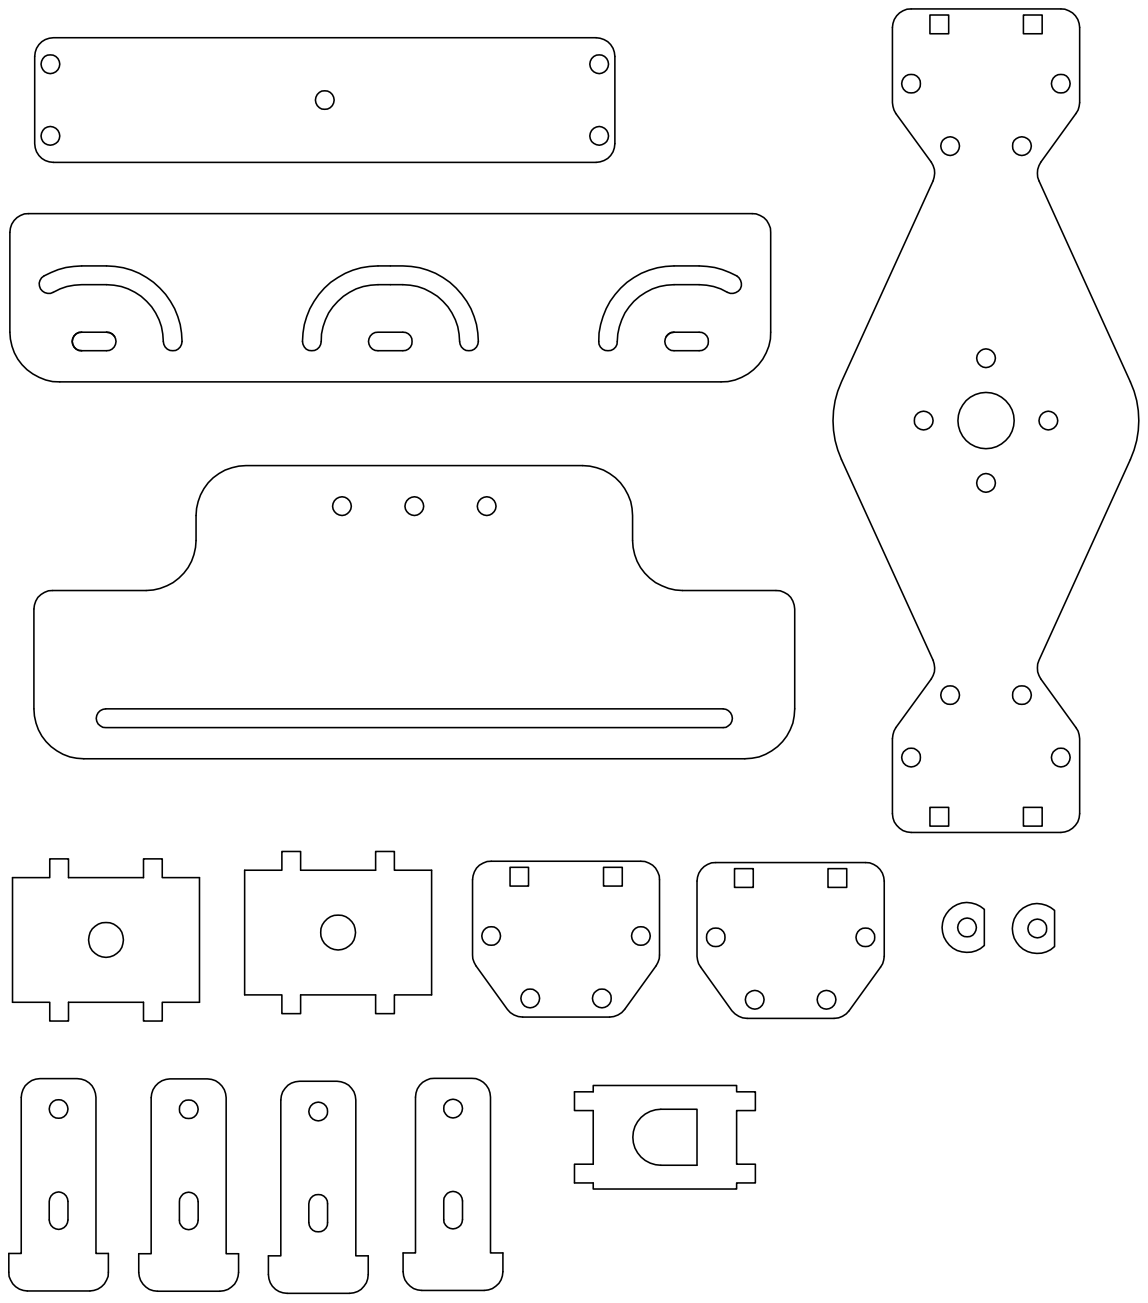
[picture p157: page 2]
