Ant0Kr/Circuit-design/(list of files, drawings)

Other design files:
Cхемы/robot.fzz
