Ant0Kr/Circuit-design/(commit log)

2017-10-01 Добавлены 3D и 2D чертежи
    [korpus_IK_datchika.STL, stupica.STL, робот.dwg]
2017-10-22 Исправлены шайбы на 2D чертежах
    [робот.dwg]
2017-10-22 Добавлены схемы подключения электроники
    [robot.fzz]
2017-10-22 Добавлено API взаимодействия с роботом
2017-10-22 Добавлена прошивка для вывода значений с датчиков
2017-10-22 Добавлена базовая прошивка управления роботом
2017-10-29 Исправлены отверстия для контроллера двигателей на чертеже корпуса
    [робот.dwg]
2017-10-29 Добавлены 3D модели составных частей робота
    [Sensor.dwg, Sensor.stl, board.dwg, board.stl, futaba s3003.dwg, futaba s3003.stl, korpus_IK_datchika.DWG, l298n.dwg]
2017-10-30 Добавлена 3D модель робота
2017-11-11 Добавлено первые три раздела инструкции
2017-11-12 Обновление инструкции
2017-11-14 Обновление 3D моделей
    [Контроллер заряда.dwg]
2017-11-19 Добавлены 3D чертежи шагов
2017-11-21 Добавление первых 10 слайдов презентации.
2017-11-23 Презентация без слайдов об инструкции и ресурсах(деталях)
2017-11-23 Обновление прошивки
2017-11-24 Обновление схемы
2017-11-24 Добавлен чертеж корпуса робота в формате pdf
2017-11-25 Обновление презентации. Добавлены слайды инструкции.
2017-12-02 Правки презентации. Подписи, шрифт, QR-код, и др.
2017-12-03 Добавлен QR-код в инструкцию
2017-12-03 Добавлены слайды с информацией о ресурсах и др.
